freecores/gecko3/GECKO3COM/gecko3com-fw/doc/inc/leopard_gecko_by_larkin_art.jpg

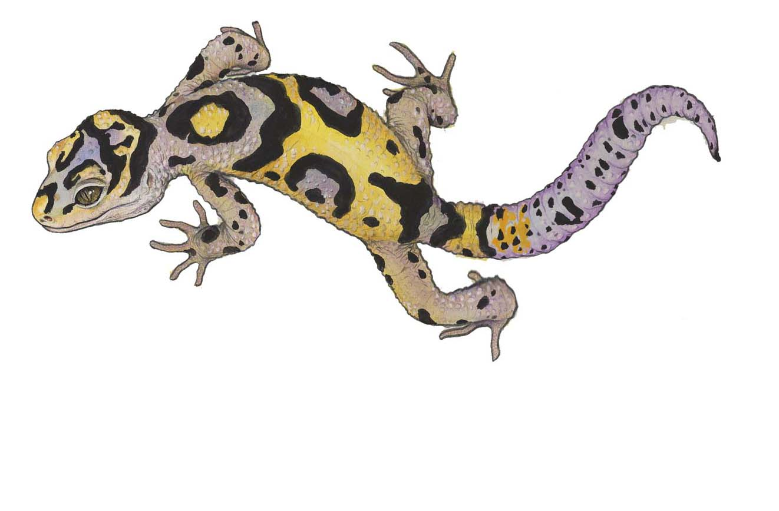
GECKO3COM/gecko3com-fw/doc/inc/leopard_gecko_by_larkin_art.jpg
