freecores/gecko3/GECKO3main/product-label/gecko3main-label.odt

# GECKO3main

Type: XC3S1500

Case: FG676

Speed: 4

Serialnumber: 1

Testdate:

# GECKO3main

Type: XC3S1500

Case: FG676

Speed: 4

Serialnumber: 2

Testdate:

# GECKO3main

Type: XC3S1500

Case: FG676

Speed: 4

Serialnumber: 3

Testdate:

# GECKO3main

Type: XC3S1500

Case: FG676

Speed: 4

Serialnumber: 4

Testdate:

# GECKO3main

Type: XC3S1500

Case: FG676

Speed: 4

Serialnumber: 5

Testdate:

# GECKO3main

Type: XC3S1500

Case: FG676

Speed: 4

Serialnumber: 6

Testdate:

# GECKO3main

Type: XC3S1500

Case: FG676

Speed: 4

Serialnumber: 7

Testdate:

# GECKO3main

Type: XC3S1500

Case: FG676

Speed: 4

Serialnumber: 8

Testdate:

# GECKO3main

Type: XC3S1500

Case: FG676

Speed: 4

Serialnumber: 9

Testdate:

# GECKO3main

Type: XC3S1500

Case: FG676

Speed: 4

Serialnumber: 10

Testdate:

# GECKO3main

Type: XC3S1500

Case: FG676

Speed: 4

Serialnumber: 11

Testdate:

# GECKO3main

Type: XC3S1500

Case: FG676

Speed: 4

Serialnumber: 12

Testdate:

# GECKO3main

Type: XC3S1500

Case: FG676

Speed: 4

Serialnumber: 13

Testdate:

# GECKO3main

Type: XC3S1500

Case: FG676

Speed: 4

Serialnumber: 14

Testdate:

# GECKO3main

Type: XC3S1500

Case: FG676

Speed: 4

Serialnumber: 15

Testdate:

# GECKO3main

Type: XC3S1500

Case: FG676

Speed: 4

Serialnumber: 16

Testdate:

# GECKO3main

Type: XC3S1500

Case: FG676

Speed: 4

Serialnumber: 17

Testdate:

# GECKO3main

Type: XC3S1500

Case: FG676

Speed: 4

Serialnumber: 18

Testdate:

# GECKO3main

Type: XC3S1500

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

Case: FG676

Speed: 4

Serialnumber: 48

Testdate:

# GECKO3main

Type: XC3S1500

Case: FG676

Speed: 4

Serialnumber: 49

Testdate:

# GECKO3main

Type: XC3S1500

Case: FG676

Speed: 4

Serialnumber: 50

Testdate:

# GECKO3main

Type: XC3S1500

Case: FG676

Speed: 4

Serialnumber: 51

Testdate:
