freecores/gecko3/GECKO3COM/gecko3com-ip/doc/fpga_fx2_interface_1.png

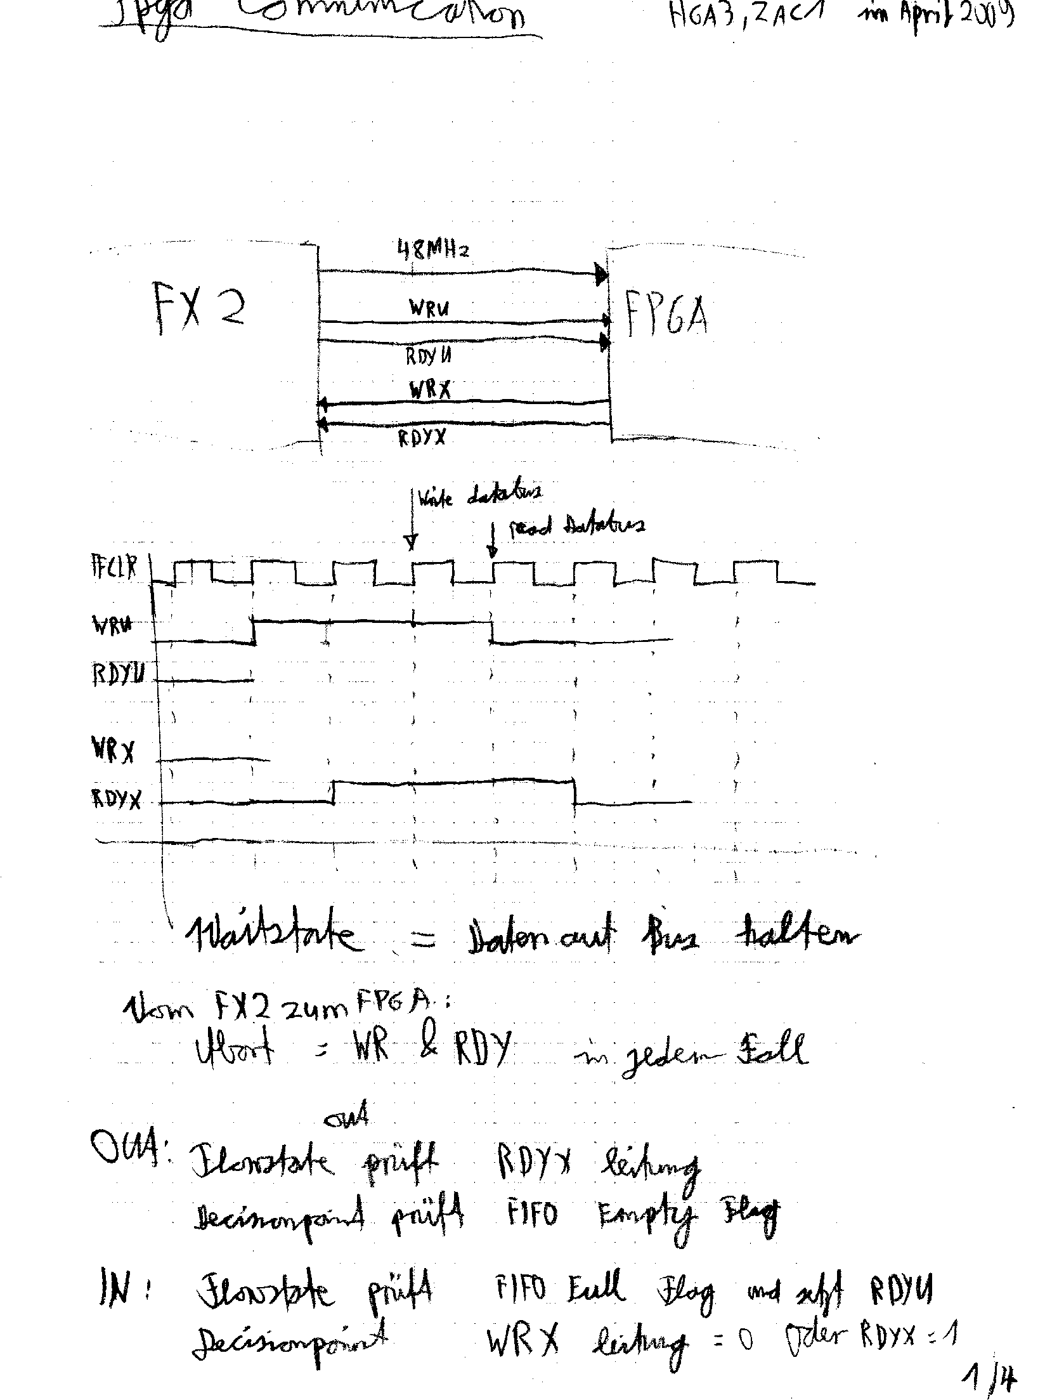
GECKO3COM/gecko3com-ip/doc/fpga_fx2_interface_1.png
