freecores/gecko3/GECKO3COM/gecko3com-ip/doc/GECKO3COM_simple_fsm_2.png

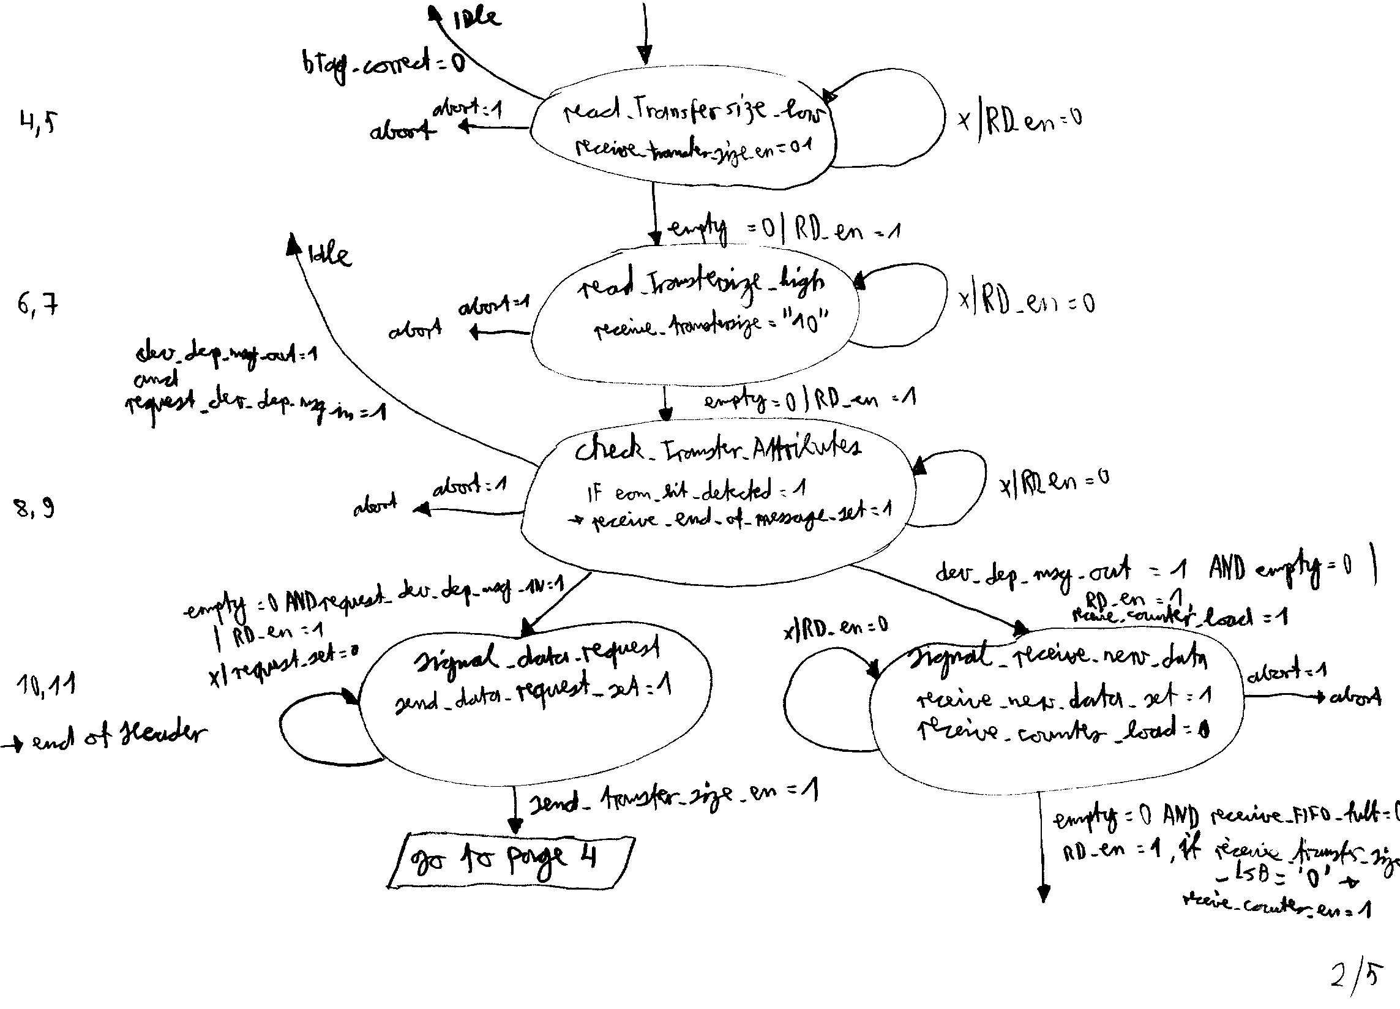
GECKO3COM/gecko3com-ip/doc/GECKO3COM_simple_fsm_2.png
