freecores/gecko3/GECKO3COM/gecko3com-ip/doc/GECKO3COM_simple_fsm_3.png

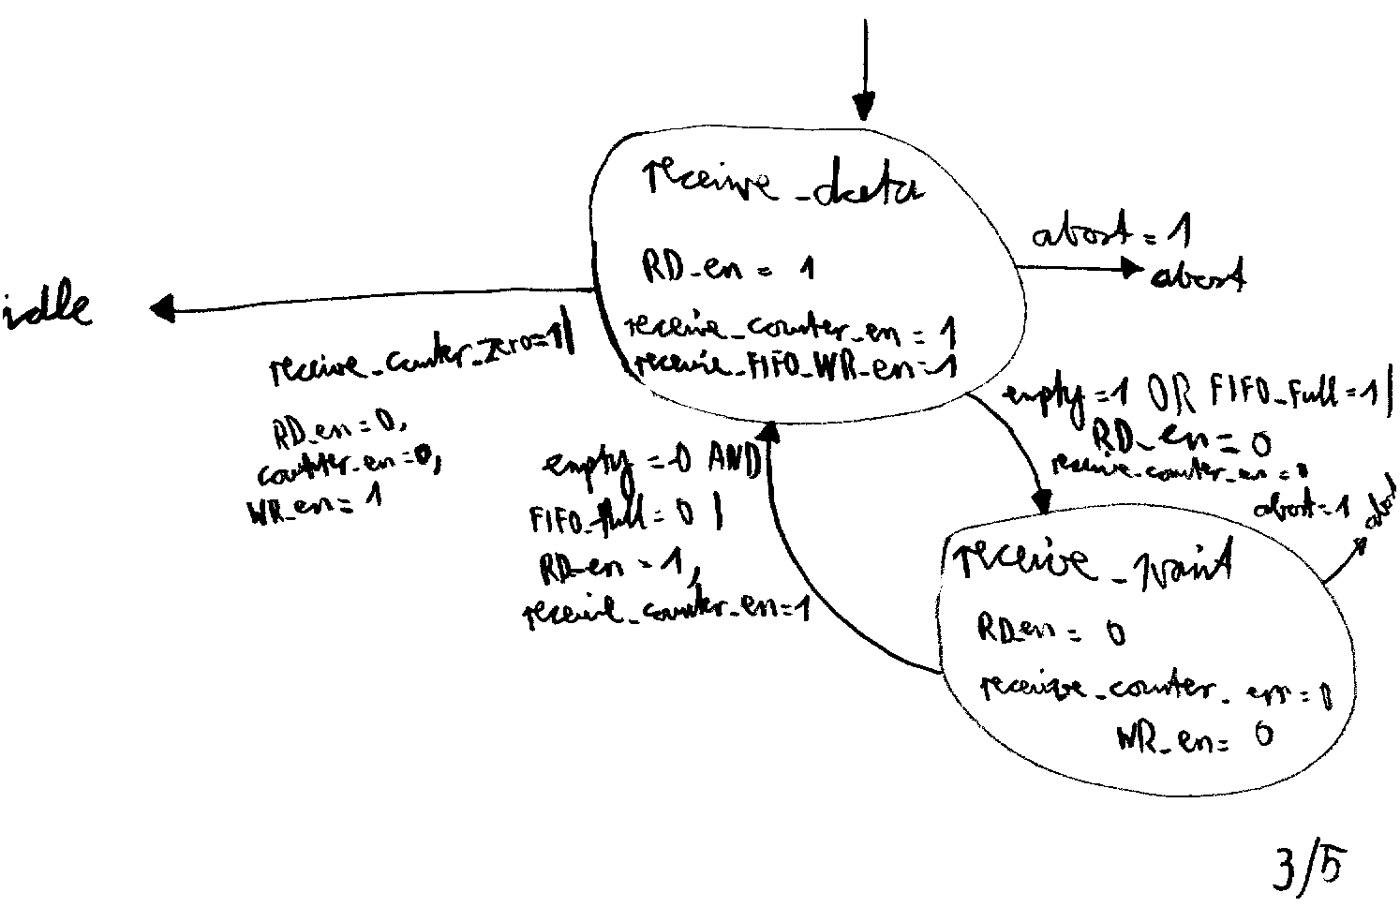
GECKO3COM/gecko3com-ip/doc/GECKO3COM_simple_fsm_3.png
