freecores/gecko3/GECKO3COM/gecko3com-ip/doc/GECKO3COM_simple_fsm_5.png

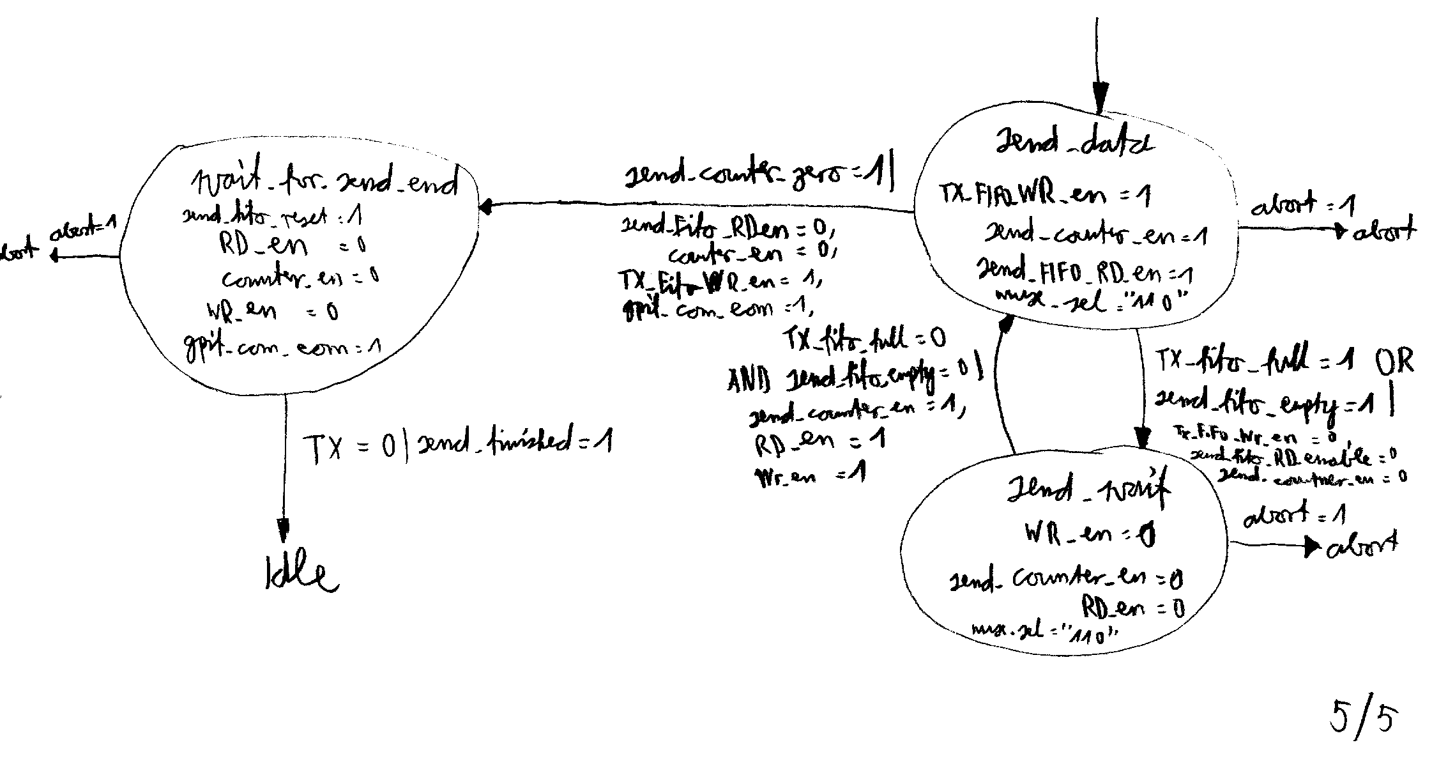
GECKO3COM/gecko3com-ip/doc/GECKO3COM_simple_fsm_5.png
