freecores/gecko3/GECKO3COM/gecko3com-ip/doc/GECKO3COM_simple_symbol.png

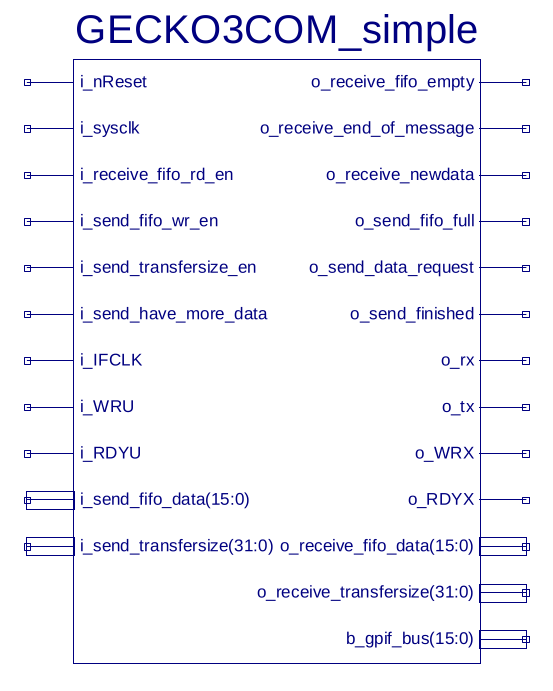
GECKO3COM/gecko3com-ip/doc/GECKO3COM_simple_symbol.png
