freecores/gecko3/GECKO3COM/gecko3com-ip/doc/gpif_com_symbol.png

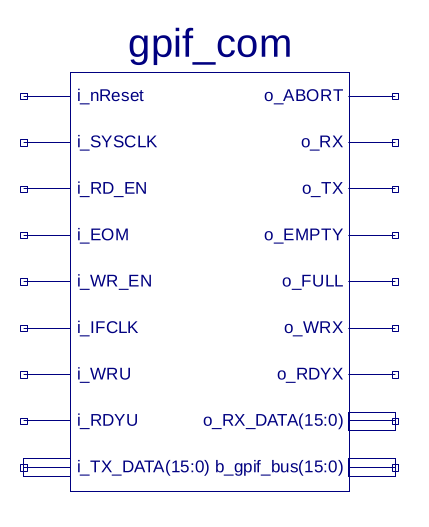
GECKO3COM/gecko3com-ip/doc/gpif_com_symbol.png
