freecores/gecko3/GECKO3COM/gecko3com-ip/doc/in_transfer_planing.png

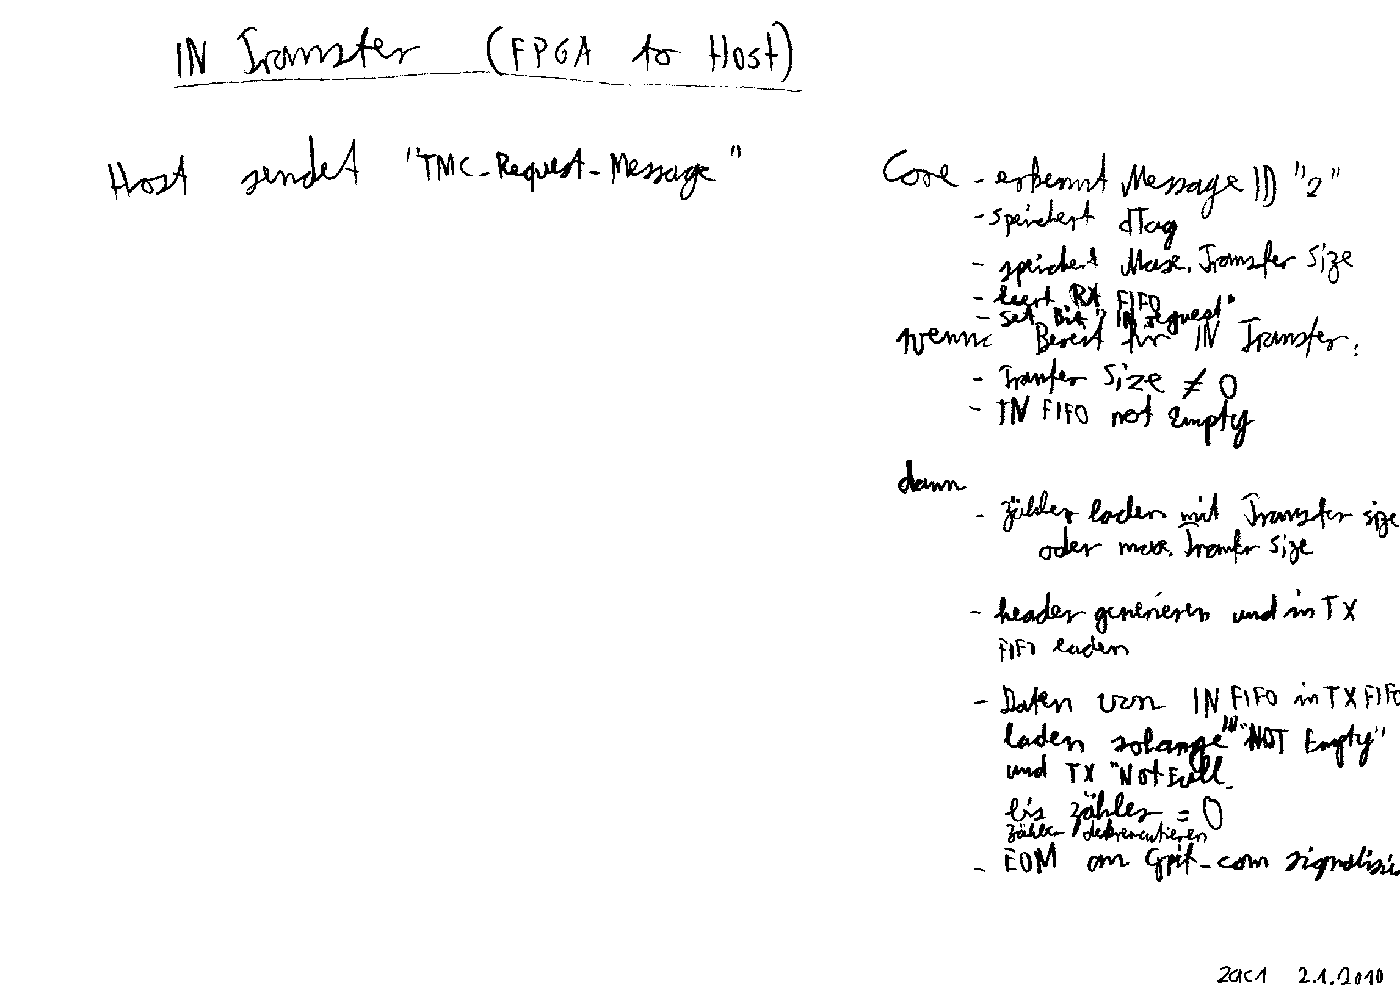
GECKO3COM/gecko3com-ip/doc/in_transfer_planing.png
