freecores/gecko3/GECKO3COM/gecko3com-ip/doc/out_transfer_planing.png

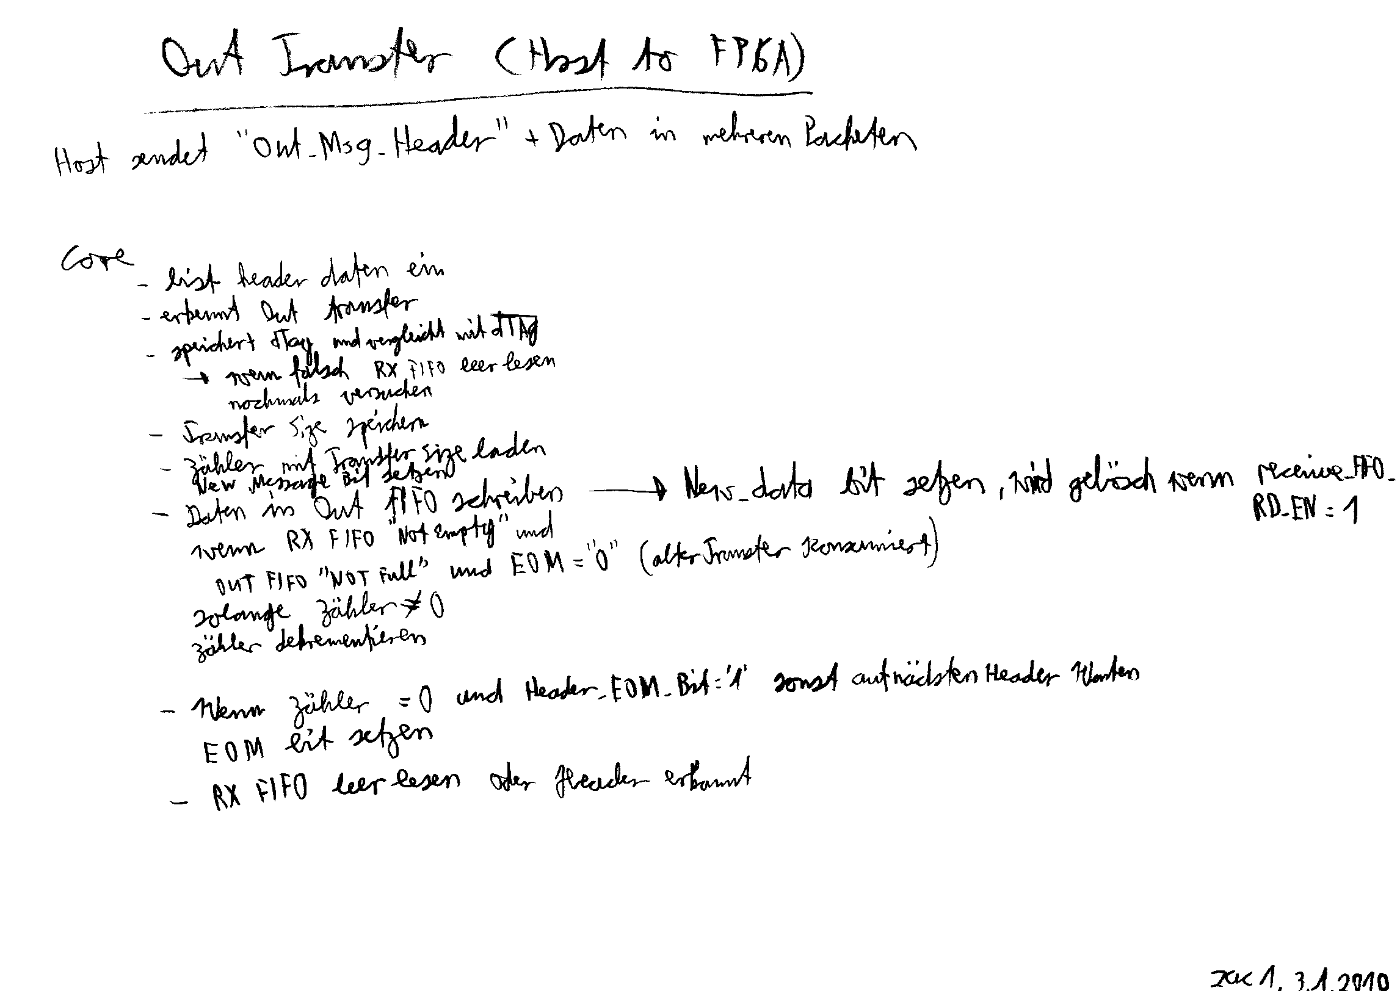
GECKO3COM/gecko3com-ip/doc/out_transfer_planing.png
