freecores/gecko3/GECKO3COM/gecko3com-ip/doc/wave_arbit_col.png

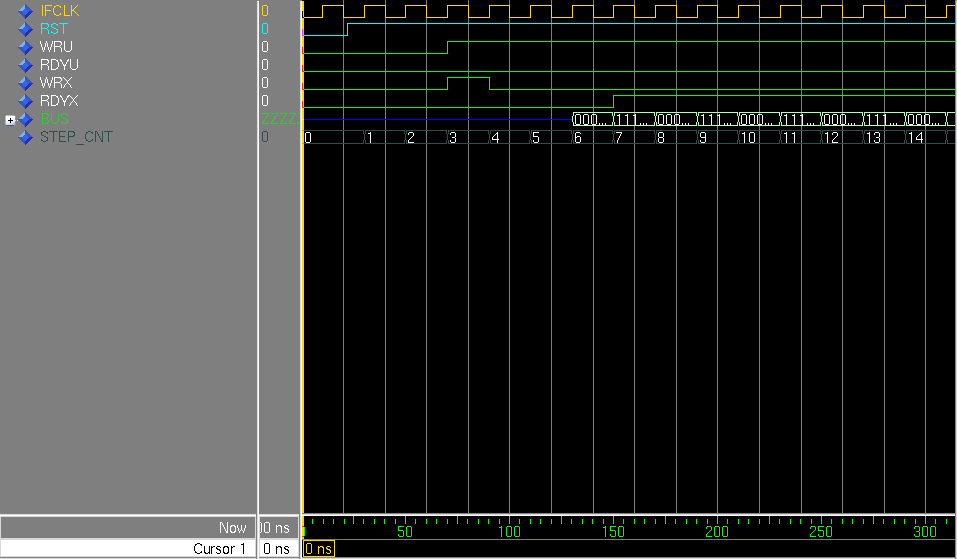
GECKO3COM/gecko3com-ip/doc/wave_arbit_col.png
