freecores/gecko3/GECKO3COM/gecko3com-ip/doc/wave_throt.png

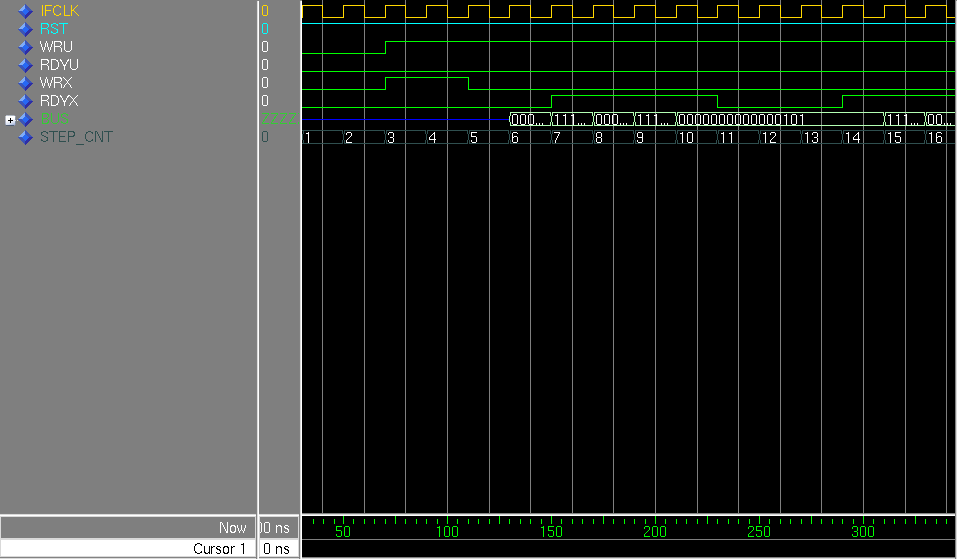
GECKO3COM/gecko3com-ip/doc/wave_throt.png
