freecores/gecko3/GECKO3main/blockdiagramm.png

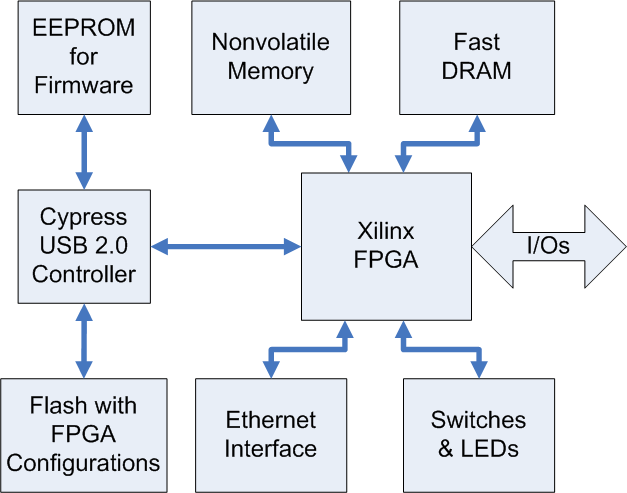
GECKO3main/blockdiagramm.png
