freecores/gecko3/CAD libraries/part-list.xls

Sheet: R
Value | Manufacturer | Part Number | Distributor | Distributor Number | Packaging unit | lead time | RoHS | Currency | Price
10R | TYCO ELECTRONICS | CRG0402J10R-10 | Farnell | 1174 141 | 50 |  | yes | CHF | 0.09
33R | TYCO ELECTRONICS | CRG0402J33R-10 | Farnell | 1174 144 | 50 |  | yes | CHF | 0.09
49.9R | Multicomp | MC 0.063W 0603 1% 49R9 | Farnell | 1170 658 | 50 |  | X-yes | CHF | 0.062
68R | PHYCOMP | 232270676809 | Farnell | 9239 090 | 50 |  | yes | CHF | 0.12
100R | PHYCOMP | 232270671001 | Farnell | 9239 111 | 50 |  | yes | CHF | 0.12
120R | PHYCOMP | 232270671201 | Farnell | 9239 120 | 50 |  | yes | CHF | 0.12
220R | PHYCOMP | 232270672201 | Farnell | 9239 154 | 50 |  | yes | CHF | 0.12
330R | PHYCOMP | 232270673301 | Farnell | 9239 170 | 50 |  | yes | CHF | 0.12
1.5K | PHYCOMP | 232270671502 | Farnell | 9239 251 | 50 |  | yes | CHF | 0.12
160K | Multicomp | MC 0.063W 0603 1% 160K | Farnell | 9330 682 | 50 |  | X-yes | CHF | 0.055
180K | PHYCOMP | 232270671804 | Farnell | 9239 502 | 50 |  | yes | CHF | 0.12
1M_250V | Multicomp | MC 0.125W 1206 1% 1M | Farnell | 9335 781 | 50 |  | X-yes | CHF | 0.055
2.2K | PHYCOMP | 232270672202 | Farnell | 9239 278 | 50 |  | yes | CHF | 0.12
2.2M | PHYCOMP | 232270672205 | Farnell | 9239 618 | 50 |  | yes | CHF | 0.12
330k | PHYCOMP | 232270673304 | Farnell | 9239 537 | 50 |  | yes | CHF | 0.12
4.7K | PHYCOMP | 232270674702 | Farnell | 9239 316 | 50 |  | yes | CHF | 0.12
4.87K | Multicomp | MC 0.063W 0603 1% 4K87 | Farnell | 1170 858 | 50 |  | X-yes | CHF | 0.09
4x27 | PHYCOMP | 235003410279 | Farnell | 9234 969 | 10 |  | yes | CHF | 0.17
6.2K | Multicomp | MC 0.063W 0603 1% 6K2 | Farnell | 9331 409 | 50 |  | X-yes | CHF | 0.055
82K | PHYCOMP | 232270678203 | Farnell | 9239 464 | 50 |  | yes | CHF | 0.12
27R | PHYCOMP | 232270672709 | Farnell | 9239 049 | 50 |  | yes | CHF | 0.12
1.2K | PHYCOMP | 232270671202 | Farnell | 9239 243 | 50 |  | yes | CHF | 0.12
1.8k 0603 | Multicomp | MC 0.063W 0603 1% 1K8 | Farnell | 9330 712 | 50 |  | X-yes | CHF | 0.062
330k 0603 | Multicomp | MC 0.063W 0603 1% 330K | Farnell | 9331 042 | 50 |  | X-yes | CHF | 0.062
1M 0603 | Multicomp | MC 0.063W 0603 1% 1M | Farnell | 9330 410 | 50 |  | X-yes | CHF | 0.062
1k 0603 | Multicomp | MC 0.063W 0603 1% 1K | Farnell | 9330 380 | 50 |  | X-yes | CHF | 0.062
1M 0603 | Multicomp | MC 0.063W 0603 1% 1K24 | Farnell | 1170 797 | 50 |  | X-yes | CHF | 0.034
10R 0603 | Multicomp | MC 0.063W 0603 1% 10R | Farnell | 9330 429 | 50 |  | X-yes | CHF | 0.062
150R 0603 | Multicomp | MC 0.063W 0603 1% 150R | Farnell | 9330 593 | 50 |  | X-yes | CHF | 0.062
2k 0603 | Multicomp | MC 0.063W 0603 1% 2K | Farnell | 9330 763 | 50 |  | X-yes | CHF | 0.062
7.5k 0603 | Multicomp | MC 0.063W 0603 1% 7K5 | Farnell | 9331 514 | 50 |  | X-yes | CHF | 0.062
10k 0603 | Multicomp | MC 0.063W 0603 1% 10K | Farnell | 9330 399 | 50 |  | X-yes | CHF | 0.062
100k 0603 | Multicomp | MC 0.063W 0603 1% 100K | Farnell | 9330 402 | 50 |  | X-yes | CHF | 0.062
137k 0603 | Multicomp | MC 0.063W 0603 1% 137K | Farnell | 1170 999 | 50 |  | X-yes | CHF | 0.034
150k 0603 | Multicomp | MC 0.063W 0603 1% 150K | Farnell | 9330 623 | 50 |  | X-yes | CHF | 0.034
470k 0603 | Multicomp | MC 0.063W 0603 1% 470K | Farnell | 9331 263 | 50 |  | X-yes | CHF | 0.034
2.2M 0603 | PHYCOMP | 232270462205 | Farnell | 9238 883 | 50 |  | yes | CHF | 0.122
3.3M 0603 | PHYCOMP | 232270463305 | Farnell | 9238 905 | 50 |  | yes | CHF | 0.122
680k 0603 | Multicomp | MC 0.063W 0603 1% 680K | Farnell | 9331 476 | 50 |  | X-yes | CHF | 0.062
120k 0603 | Multicomp | MC 0.063W 0603 1% 120K | Farnell | 9330 526 | 50 |  | X-yes | CHF | 0.062
220R 0603 | PHYCOMP | 232270462204 | Farnell | 9238 760 | 50 |  | yes | CHF | 0.123

Sheet: C
Value | Manufacturer | Part Number | Distributor | Distributor Number | Packaging unit | lead time | RoHS | Currency | Price
470nF | PHYCOMP | 2238 786 19758 | Farnell | 3188 851 | 10 |  | yes | CHF | 0.17
100nF | Murata | GRM155R71C104KA88D | Farnell | 8819 742 | 10 |  | yes | CHF | 0.07
10nF | AVX | 04023C103KAT2A | Farnell | 1327 624 | 10 |  | yes | CHF | 0.11
10uF | Murata | GRM31CR70J106KA01L | Farnell | 9527 729 | 1 |  | yes | CHF | 0.25
22pF | Murata | GRM1555C1H220JZ01D | Farnell | 8819 629 | 10 |  | yes | CHF | 0.07
15pF | AVX | 04025A150JAT2A | Farnell | 1327 631 | 1 |  | yes | CHF | 0.07
1nF | PHYCOMP | 2238 587 15623 | Farnell | 3019 380 | 10 |  | yes | CHF | 0.11
2.2uF | Murata | GRM21BR71A225KA01L | Distrelec | 823 517 | 1 |  | yes | CHF | 0.54
220uF | AVX | TAJY227K010R | Farnell | 1135 081 | 1 |  | yes | CHF | 2.5
22uF | Yuden | EMK325BJ226MM-T | Farnell | 6578 950 | 1 | 14 Tage | yes | CHF | 0.67
22uF_ | Murata | GRM32CF51A226ZA01L | Farnell | 9527 770 | 10 |  | yes | CHF | 0.43
33pF | Murata | GRM1555C1H330JZ01D | Farnell | 8819 645 | 10 |  | yes | CHF | 0.066
39pF | PHYCOMP | 2238 867 15399 | Farnell | 722 030 | 1 |  | yes | CHF | 0.11
4.7nF_1000V | Murata | DEBF33A472ZC1B | Farnell | 9527 249 | 1 |  | yes | CHF | 0.52
470uF | Kemet | B45196-H2477-K509 | Distrelec | 811 024 | 1 |  | yes | CHF | 3.77
100uF | AVX | TCJB107M004R0070 | Farnell | 1135 228 | 1 |  | yes | CHF | 0.98
3.3nF | PHYCOMP | 2238 587 15629 | Farnell | 3019 410 | 10 |  | yes | CHF | 0.11
47pF | Murata | GRM1555C1H470JZ01D | Farnell | 8819 670 | 10 |  | yes | CHF | 0.07
680nF | PHYCOMP | 2238 240 15661 | Farnell | 3352 055 | 10 |  | yes | CHF | 0.34
47nF | PHYCOMP | 2238 787 19845 | Farnell | 3019 469 | 10 |  | yes | CHF | 0.15
4.7nF_1KV_SMD | AVX | 1206AC472KAT1A | Farnell | 1216 464 | 5 |  | yes | CHF | 0.38
22uF 0805 | Kemet | C0805C226M9PAC7800 | Farnell | 1108 326 | 1 |  | yes | CHF | 1.8
100uF ceramic | Kemet | C1210C107M9PAC7800 | Farnell | 1108 328 | 1 |  | yes | CHF | 4.13
4.7uF | Kemet | C0805C475K4PAC | Farnell | 9227 849 | 10 |  | yes | CHF | 0.508
4.7pF 0603 | AVX | 06032U4R7CAT2A | Farnell | 7568 258 | 5 |  | yes | CHF | 0.45
10nF 0603 | AVX | 06035C103KAT2A | Farnell | 1327 675 | 10 |  | yes | CHF | 0.07
22pF 0603 | Epcos | B37930K5220J60 | Farnell | 9753 486 | 10 |  | yes | CHF | 0.083
47pF 0603 | Murata | GRM1885C1H470JA01D | Farnell | 8819 840 | 10 |  | yes | CHF | 0.071
820pF 0603 | PHYCOMP | 2238 861 15821 | Farnell | 718 555 | 10 |  | yes | CHF | 0.115
1nF 0603 | Murata | GRM188R71H102KA01D | Farnell | 8819 955 | 10 |  | yes | CHF | 0.071

Sheet: IC
Value | Manufacturer | Part Number | Distributor | Distributor Number | Packaging unit | lead time | RoHS | Currency | Price
CY7C68013A-56BAXC | Cypress | CY7C68013A-56BAXC | Silica | CY7C68013A56BAXC | 490 | 12 Weeks | yes | CHF | 15.95
DP83848I | National | DP83848IVV/NOPB | EBV | DP83848IVV/NOPB | 1 |  | yes | CHF | 5.55
JS28F128J3D-75 | Intel | JS28F128J3D-75 | Silica | JS28F128J3D-75 | 96 | 13 Weeks | yes | $ | 10.2
LP8340CDT-2.5 | National | LP8340CDT-2.5 | EBV | LP8340CDT-2.5/NOPB | 75 | 6 Weeks | yes | CHF | 1.065
LTC3412A | Linear | LTC3412AEUF#PBF | Linear online | LTC3412AEUF#PBF | 1 | 2 Weeks | yes | $ | 4.93
LTC4411 | Linear | LTC4411ES5#PBF | Linear online | LTC4411ES5#PBF | 1 | 2 Weeks | yes | $ | 2.36
M25P16-SO8 | ST | M25P16-VMW6TG | Silica | M25P16VMW6TG | 1 | 8 Weeks | yes | CHF | 3.31
XC3S1500-4FG676C | Xilinx | XC3S1500-4FGG676C | Silica | XC3S15004FGG676C | 40 | 6 Weeks | yes | CHF | 130.74
XC3S1500-4FG456C | Xilinx | XC3S1500-4FG456C | Silica | XC3S1500FG456C | 66 | 6 Weeks | no | CHF | 85.93
MAX3232 | Maxim | MAX 3232 CPE | Distrelec | 648 972 | 1 |  | yes | CHF | 7.75
MT46V32M16P5B | Micron | MT46V32M16P5B | Silica | MT46V32M16P5B | 108 | 12 Weeks | yes | CHF | 15.87
MAX3232CSE | Maxim | MAX 3232 CSE | Distrelec | 648 973 | 1 |  | yes | CHF | 7.75
PCA9536DP | TI | PCA9536DGKR | Farnell | 1310 217 | 1 | 2 Weeks | yes | CHF | 2.45
24LC128-I/SN | Microchip | 24LC128-I/SN | Silica | 24LC128ISN | 100 | 6 Weeks | yes | CHF | 0.96
M25P16-SO16 | ST | M25P16-VMF6P | Farnell | 8661 316 | 1 |  | yes | CHF | 6.30
CY7C68013A-56LFXC | Cypress | CY7C68013A-56LFXC | Silica | CY7C68013A56LFXC | 260 | 5 Weeks | yes | CHF | 12.39
M25P32-VDFPN | ST | M25P32-VME6G | Silica | M25P32VME6G | 320 | 12 Weeks | yes | CHF | 6.92
XC3S4000-5FG676C | Xilinx | XC3S4000-5FG676C | Silica | XC3S40005FGG676C | 40 | 6 Weeks | yes | CHF | 184.72
Si9986 | Vishay | SI9986DY-T1-E3 | Farnell | 1199 224 | 1 | 2 Weeks | yes | CHF | 6.60
LTC4075 | Linear | LTC4075EDD#PBF | Linear online | LTC4075EDD#PBF | 1 | 2 Weeks | yes | $ | 2.67
LTC3412AEFE | Linear | LTC3412AEFE#PBF | Linear online | LTC3412AEFE#PBF | 2 | 2 Weeks | yes | $ | 4.93
LTC4412 | Linear | LTC4412ES6#PBF | Linear online | LTC4412ES6#PBF | 2 | 2 Weeks | yes | $ | 1.93
LMV321IDBVR | TI | LMV321IDBVR | Farnell | 1105 935 | 1 |  | yes | CHF | 0.863
LM2703 | National | LM2703MF-ADJ | Farnell | 9779 442 | 1 |  | yes | CHF | 4.00
74HC74D | TI | SN74HC74D | Farnell | 9591 680 | 1 |  | yes | CHF | 0.632

Sheet: L
Value | Manufacturer | Part Number | Distributor | Distributor Number | Packaging unit | lead time | RoHS | Currency | Price
22nH | Panasonic | ELJRE22NJFA | Farnell | 1198 381 | 5 |  | yes | CHF | 0.45
2uH | Cooper Bussmann | SD14-2R0-R | Hy-Line |  | 3800 | 10 Days | yes | CHF | 1.85
2.2uH | Cooper Bussmann | SD18-2R2-R | Farnell | 9458 719 | 1 | 2 Weeks | yes | CHF | 2.40
MLB-160808-0300A-N2 | Kitagawa | MLB-160808-0300A-N2 | Distrelec | 330 117 | 5 |  | yes | CHF | 0.54
MLB-160808-S600Q | Kitagawa | MLB-160808-S600Q | Distrelec | 330 131 | 5 |  | yes | CHF | 0.75
2.2uH 1210 | Murata | LQH32CN2R2M33L | Farnell | 9522 182 | 5 |  | yes | CHF | 0.357
2.2uH DR73 | Cooper Bussmann | DR73-2R2 | Farnell | 1463 507 | 1 |  | yes | CHF | 2.00

Sheet: Con
Value | Manufacturer | Part Number | Distributor | Distributor Number | Packaging unit | lead time | RoHS | Currency | Price
fh-120p-5mm | AMP | 5177984-5 | Farnell | 1098 339 | 1 |  | yes | CHF | 7.95
fh-120r-9mm | AMP | 5-5179009-5 | Farnell | 1098 355 | 1 |  | yes | CHF | 6.85
fh-120r-5mm | AMP | 5177983-5 | Farnell | 1098 349 | 1 |  | yes | CHF | 7.76
fh-60p-5mm | AMP | 5177984-2 | Farnell | 1098 336 | 1 |  | yes | CHF | 3.7
fh-60r-9mm | AMP | 5-5179009-2 | Farnell | 1098 352 | 1 |  | yes | CHF | 3.7
fh-60r-13mm | AMP | 5-5179010-2 | Farnell | 1098 357 | 1 |  | yes | CHF | 3.85
Header 1x6, right angle | Preci-Dip | 330.36.1 L 02 902 | Distrelec | 122 112 | 6 |  | yes | CHF | 2.26
Header 1x6, straight | Fischer | SL1/53/36 Z | Distrelec | 122 201 | 6 |  | yes | CHF | 2.69
M22-2040205 | HARWIN | M22-2040205 | Farnell | 672 208 | 1 |  | yes | CHF | 1.2
M22-2540305 | HARWIN | M22F2040305 | Farnell | 672 210 | 1 |  | yes | CHF | 2.3
miniUSB-tht | Molex | 54819-0519 | Mouser | 538-54819-0519 | 1 | 2 Weeks | yes | $ | 1.2
S1751-46R | HARWIN | S1751-46R | Farnell | 1022 338 | 100 |  | yes | CHF | 0.1895
SI-10021 | Stewart | SI-10021 | Farnell | 1137 981 | 1 |  | yes | CHF | 12.65
DB9M | Harting | 0965 162 6812 | Farnell | 1097 063 | 1 |  | yes | CHF | 3.1
miniUSB-smt | Lumberg | 2486 01 | Farnell | 1243 250 | 1 |  | yes | CHF | 2.55
Header 2x3,smt | AMP | 1241050-3 | Farnell | 9689 567 | 1 |  | yes | CHF | 1.5
DC8 | CLIFF ELECTRONIC | DC8 | Farnell | 224 947 | 10 |  | yes | CHF | 1.855
M20-7890546 | HARWIN | M20-7890546 | Farnell | 7992 076 | 10 |  | yes | CHF | 1.45
Socket 2x20,smt | Sullins | NPPC202KFMS-RC | DIGIKEY | S5729-ND | 1 | 2 Weeks | yes | $ | 5.94
DB9F | MULTICOMP | 5504F1-09S-01-03-F1 | Farnell | 1084 710 | 10 |  | yes | CHF | 1.55
Header 1x2, straight | Preci-Dip | 330.36.1 L 02 902 | Distrelec | 122 112 | 18 |  | yes | CHF | 2.26

Sheet: T
Value | Manufacturer | Part Number | Distributor | Distributor Number | Packaging unit | lead time | RoHS | Currency | Price
BSS670 | Infineon | BSS670S2L | Farnell | 1095 673 | 5 |  | yes | CHF | 0.35
IRF5800 | IRF | IRF5800TRPBF | Farnell | 1298 519 | 1 |  | yes | CHF | 1.5
IRF7705 | IRF | IRF7705TRPBF | Farnell | 1298 533 | 1 |  | yes | CHF | 3.65

Sheet: D
Value | Manufacturer | Part Number | Distributor | Distributor Number | Packaging unit | lead time | RoHS | Currency | Price
10BQ030 | Vishay | 10BQ030PBF | Farnell | 9100 687 | 1 |  | yes | CHF | 0.42
MBR0520 | ON Semi | MBR0520LT1G | Farnell | 9556 915 | 1 |  | yes | CHF | 0.561
BAT54C | ST | BAT54CFILM | Farnell | 1261 334 | 1 | 2 Weeks | yes | CHF | 0.13
BRBG1211C | Stanley | BRBG1211C | Distrelec | 253 183 | 1 |  | yes | CHF | 0.86
side led green | Avago | HSMQ-C110 | Farnell | 8554 692 | 5 |  | yes | CHF | 1.8
side led red | Avago | HSMC-C110 | Farnell | 8554 498 | 5 |  | yes | CHF | 0.288
side led yellow | Avago | HSMA-C110 | Farnell | 8554 455 | 5 |  | yes | CHF | 0.577
MBRS340TR | Vishay | MBRS340TRPBF | Farnell | 1463 234 | 1 |  | yes | CHF | 0.617
LED 5mm green | Avago | HLMP-3507 | Distrelec | 251 536 | 5 |  | yes | CHF | 0.43
LED 5mm red | Avago | HLMP3301 | Distrelec | 251 534 | 5 |  | yes | CHF | 0.54
SB340 | Diotec | SB340 | Distrelec | 601 797 | 1 |  | yes | CHF | 0.86

Sheet: other
Value | Manufacturer | Part Number | Distributor | Distributor Number | Packaging unit | lead time | RoHS | Currency | Price
50MHz-osc | Jauch | VX3MH-5000 | Distrelec | 644 127 | 1 |  | yes | CHF | 6.99
?MHz-osc | Jauch | VX3MH-* | Distrelec | 644 1XX | 1 |  | yes | CHF | 6.99
24MHz | auris | Q-24.000M-HC49USSMD-F-30-50-D-30 | Distrelec | 335 040 | 1 |  | yes | CHF | 1.29
25MHz | ABRACON | ABLS-25.000MHZ-B2F-T | Farnell | 7940 579 | 1 | 2 Weeks | yes | CHF | 0.53
MMS 238 T | KNITTER | MMS 238 T | Farnell | 8546 827 | 1 |  | yes | CHF | 3.35
FSM | TYCO | 0-1437565-1 | Distrelec | 200 858 | 1 |  | yes | CHF | 0.86
SMD-DIP2 | TYCO | GDH02S | Farnell | 1123 952 | 1 |  | yes | CHF | 7.10
SW-DIP4 | Diptronics | PM-040900 | Distrelec | 210 036 | 1 |  | yes | CHF | 3.34
PA-LP987 | Contrel | PA-LP987 | Contrel | PA-LP987 | 1 | 5 Weeks | yes | CHF
TCND5000 | Vishay | TCND5000 | Farnell | 9169 997 | 1 | 2 Weeks | yes | CHF | 3.30
74HC74D | TI | SN74HC74D | Farnell | 9591 680 | 1 |  | yes | CHF | 0.632
TEN5-0510 | TRACO | TEN5-0510 | Distrelec | 362 901 | 1 |  | yes | CHF | 47.34
?MHz-osc dil14 | Rakon | LF X3xxB | Farnell | 9712 xxx | 1 |  | yes | CHF | 8.35
