freecores/gecko3/GECKO3 tester/gecko3main-tester.pdf

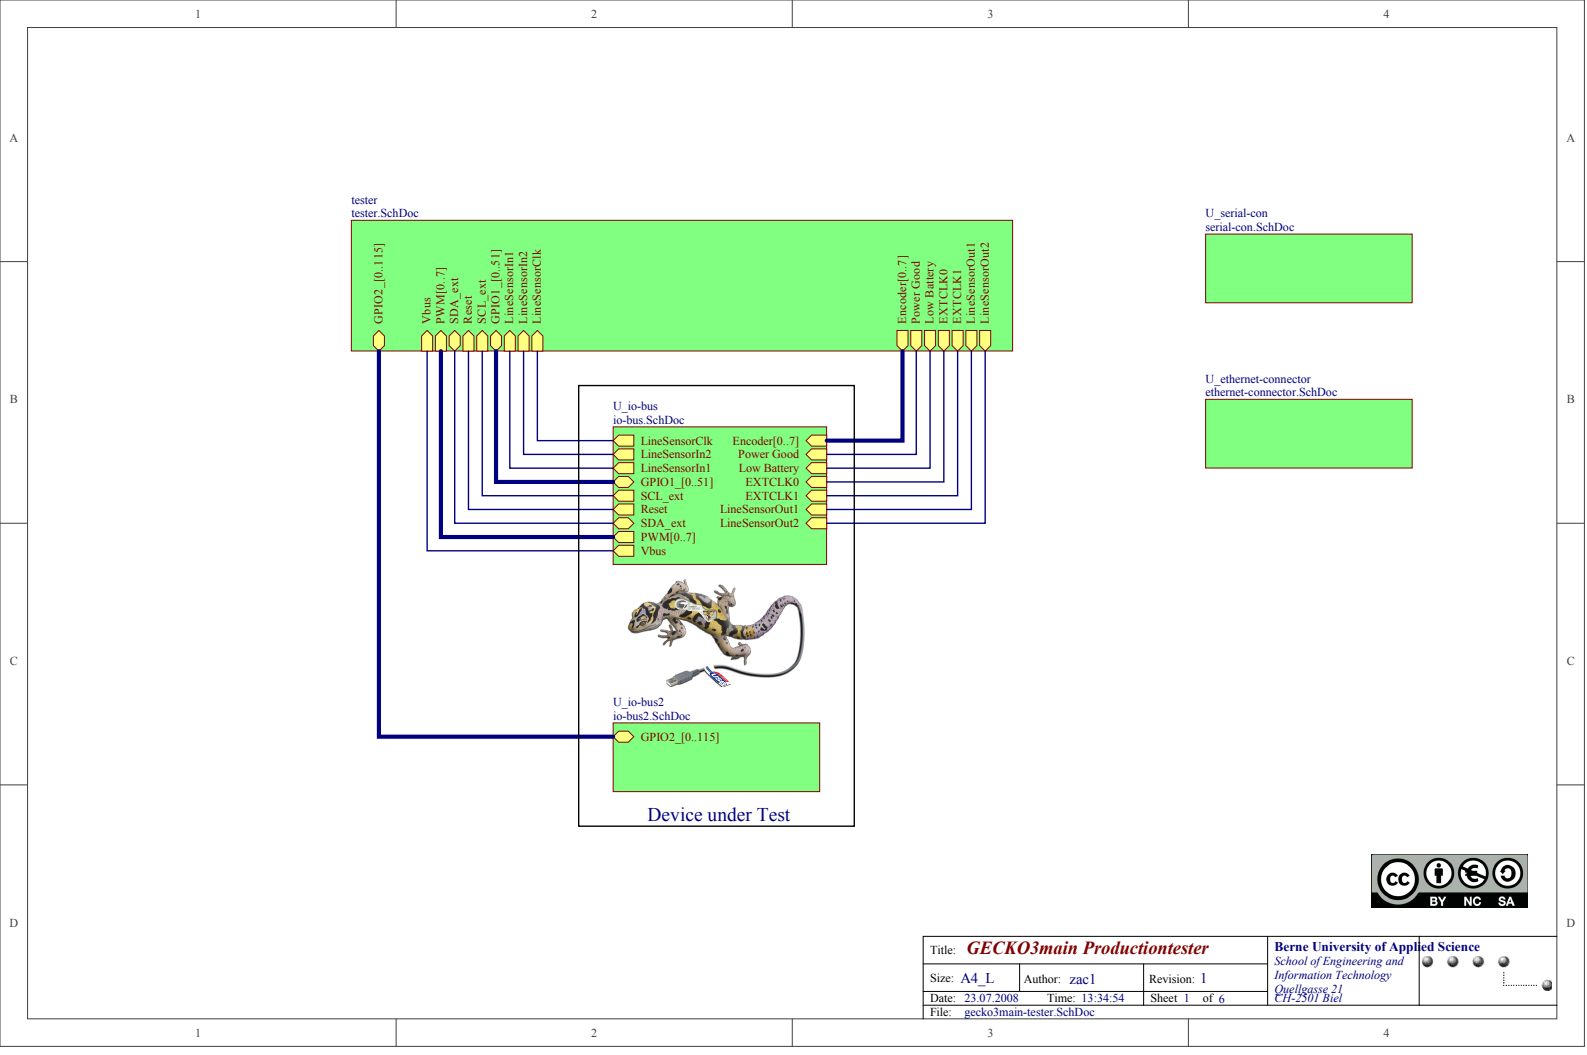
[picture p24: page 1]
Power Good Low Battery

U_serial-con
serial-con.SchDoc

U_ethernet-connector
ethernet-connector.SchDoc

Device under Test

GECKO3main Productiontester Title: | Berne University of Applied Science School of Engineering and Information Technology CH-2501 Biel

Size: A4_L | Author: zac1 | Revision: 1 | Quellgasse 21 6

Date: 23.07.2008 Time: 13:34:54 | | Sheet 1 of

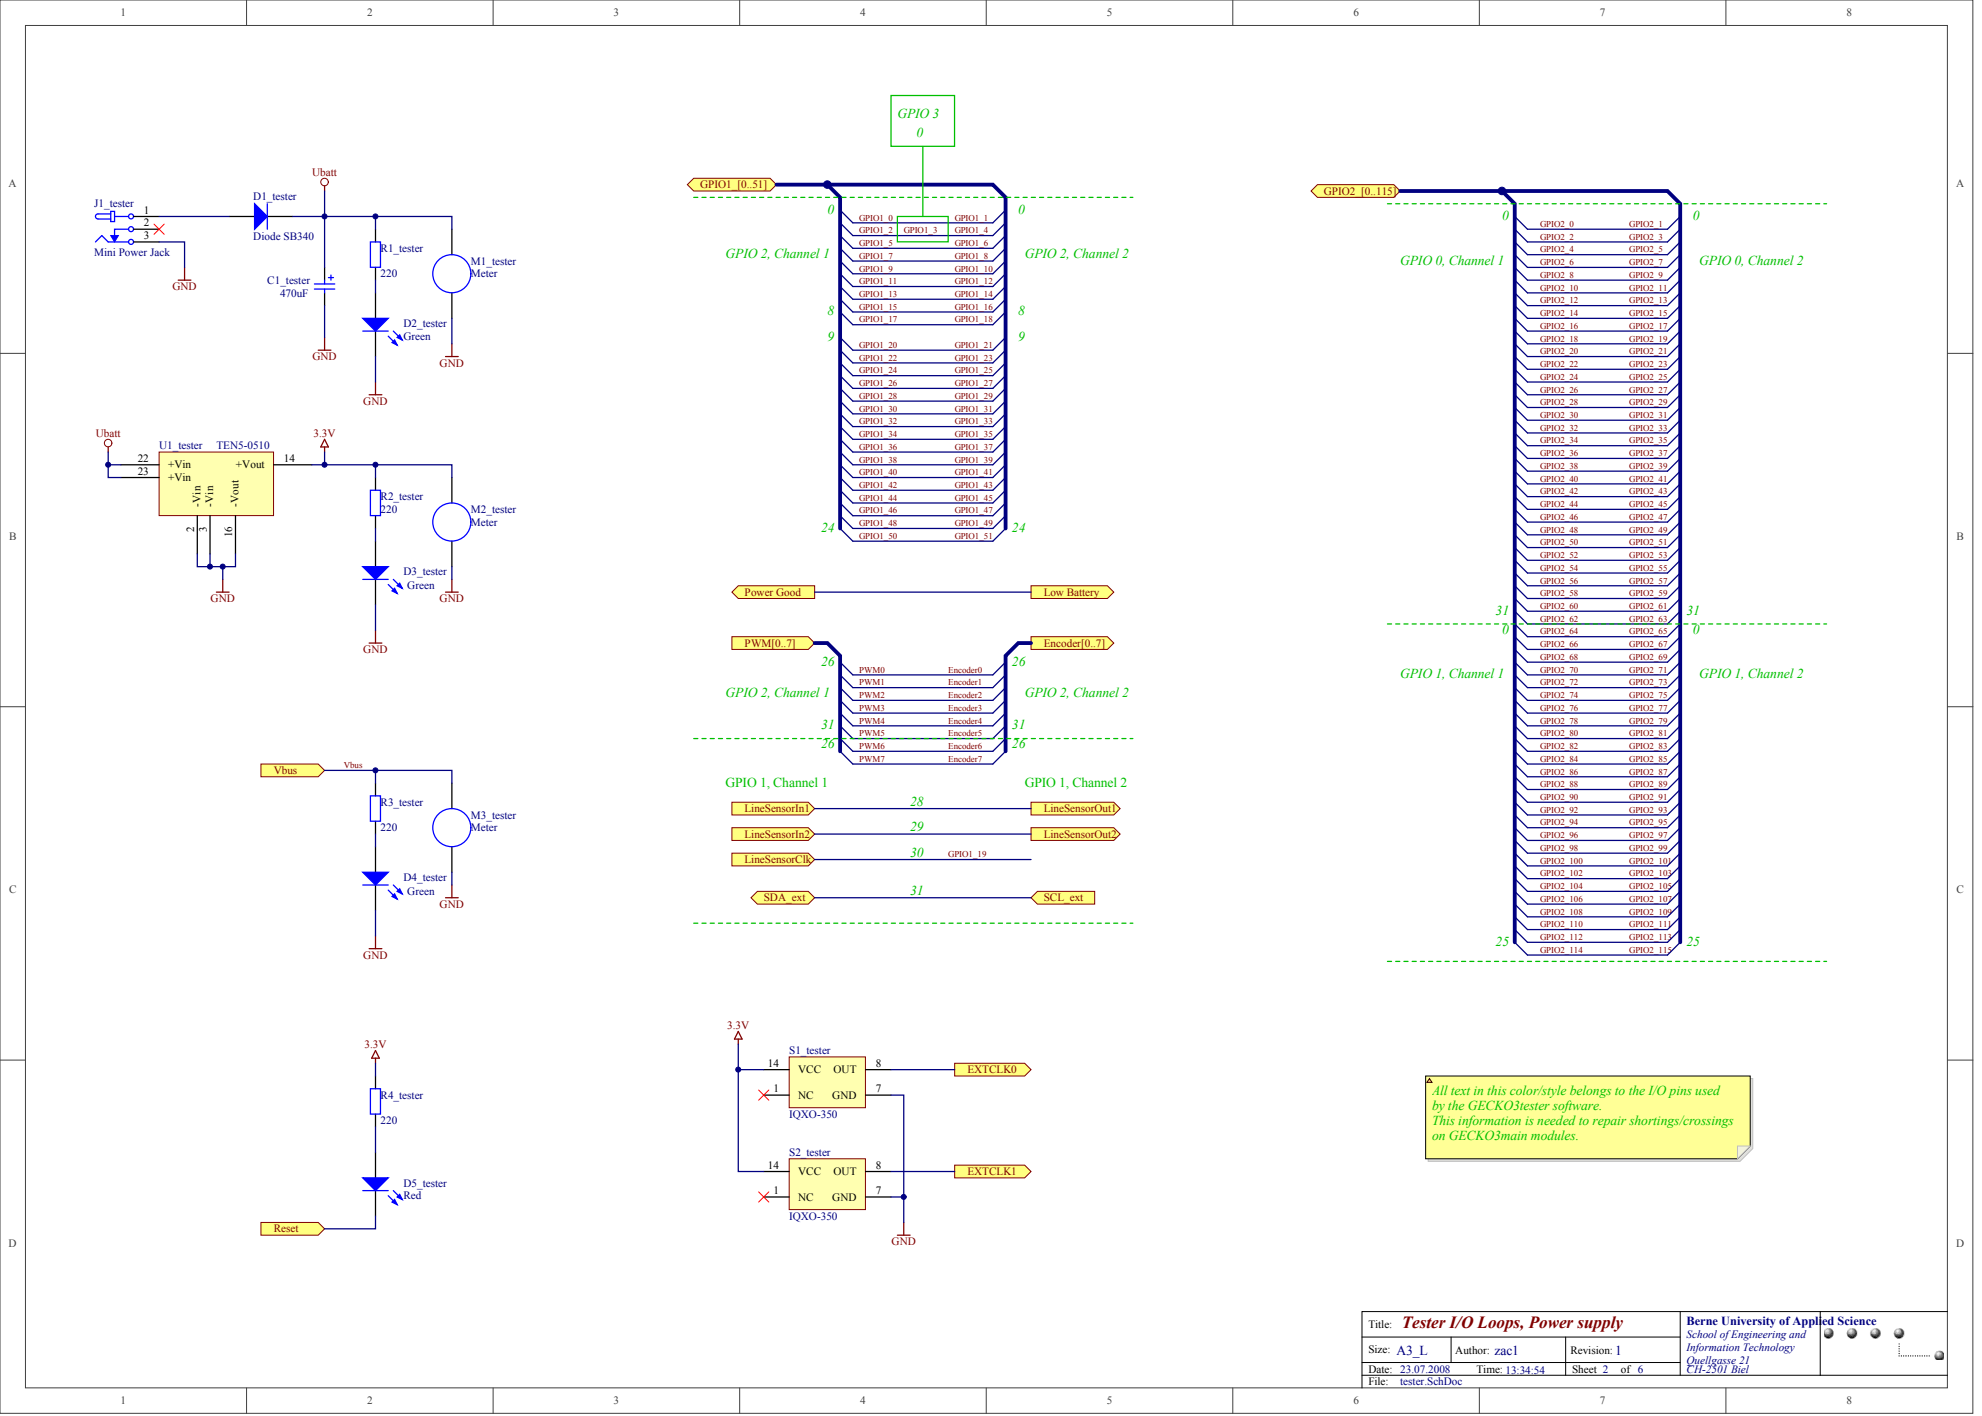
[picture p25: page 2]
PWM[0..7]; Encoder[0..7] Power Good; Low Battery; IO1_[0..51] LineSensorIn1 LineSensorIn2; LineSensorOut1 LineSensorOut2; 321 J1_tester; Diode SB340; -Vin 2; +Vin 22; +Vout; +Vin 23; -Vin 3; -Vout 16; VCC 14; Encoder7 GPIO1_19; GPIO 0, Channel 1; GPIO 0, Channel 2; GPIO 1, Channel 10; GPIO 1, Channel 2; GPIO 2, Channel 1098; GPIO 2, Channel 2; GPIO 2, Channel 1; PIO 1, Channel 1; PIO 1, Channel 2; GPIO 3 0; CKO3tester software.; CKO3main modules.; P0C10tester01 P0C10tester02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

Mini Power Jack

All text in this color/style belongs to the I/O pins used
by the GE
This information is needed to repair shortings/crossings

Tester I/O Loops, Power supply Title: | Berne University of Applied Science School of Engineering and Information Technology Quellgasse 21 CH-2501 Biel

Size: A3_L | Author: zac1 | Revision: 1

Date: File: 23.07.2008 Time: 13:34:54 | | Sheet 2 of 6

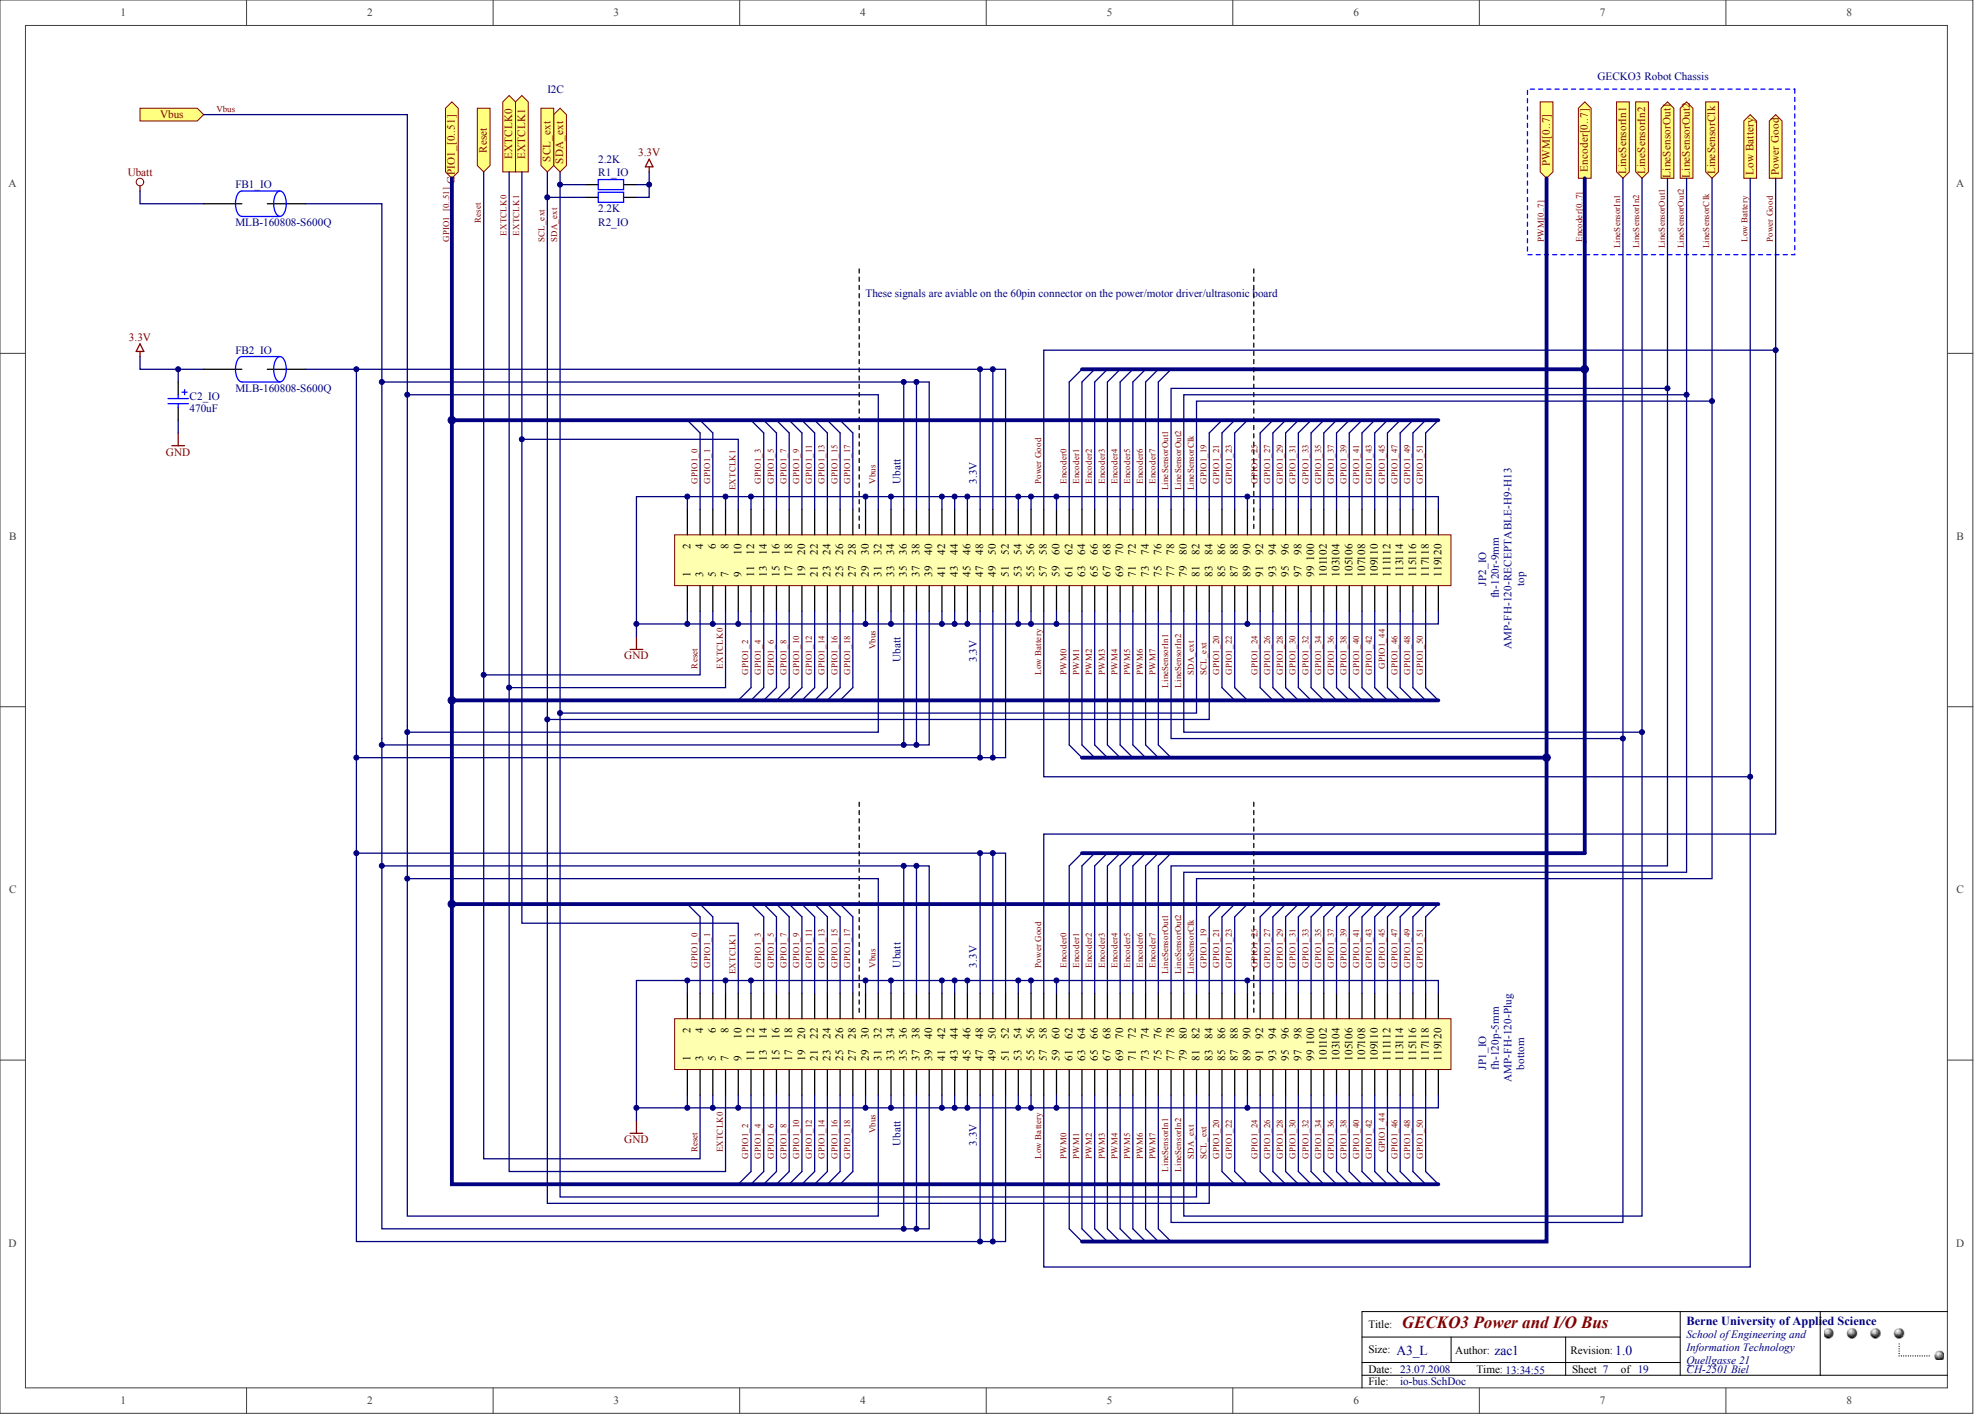
[picture p26: page 3]
GECKO3 Robot Chassis; MLB-160808-S600Q FB2_IO; MLB-160808-S600Q FB1_IO; Power Good; Low Battery; Vbus Vbus; ext I2C; _[0..51] GPIO1_[0..51]; LineSensorClk LineSensorClk; 3 GPIO1; 5 GPIO1; 7 GPIO1; 9 GPIO1; 11 GPIO1; 13 GPIO1; 15 GPIO1; 17 GPIO1; 20 GPIO1; 22 GPIO1; 24 GPIO1; 26 GPIO1; 28 GPIO1; 30 GPIO1; 32 GPIO1; 34 GPIO1; 36 GPIO1; 38 GPIO1; 40 GPIO1; 42 GPIO1; 44 GPIO1; 46 GPIO1; 48 GPIO1; 50 GPIO1; N0ENCODER0 N0ENCODER0; N0ENCODER1 N0ENCODER1; N0ENCODER2 N0ENCODER2; N0ENCODER3 N0ENCODER3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

These signals are aviable on the 60pin connector on the power/motor driver/ultrasonic board

AMP-FH-120-RECEPTABLE-H9-H13

Low Battery Power Good

AMP-FH-120-Plug

GECKO3 Power and I/O Bus Title: | Berne University of Applied Science School of Engineering and Information Technology CH-2501 Biel

Size: A3_L | Author: zac1 | Revision: 1.0
Date: File: 23.07.2008 Time: 13:34:55 | | Sheet 7 of | Quellgasse 21 19

io-bus.SchDoc

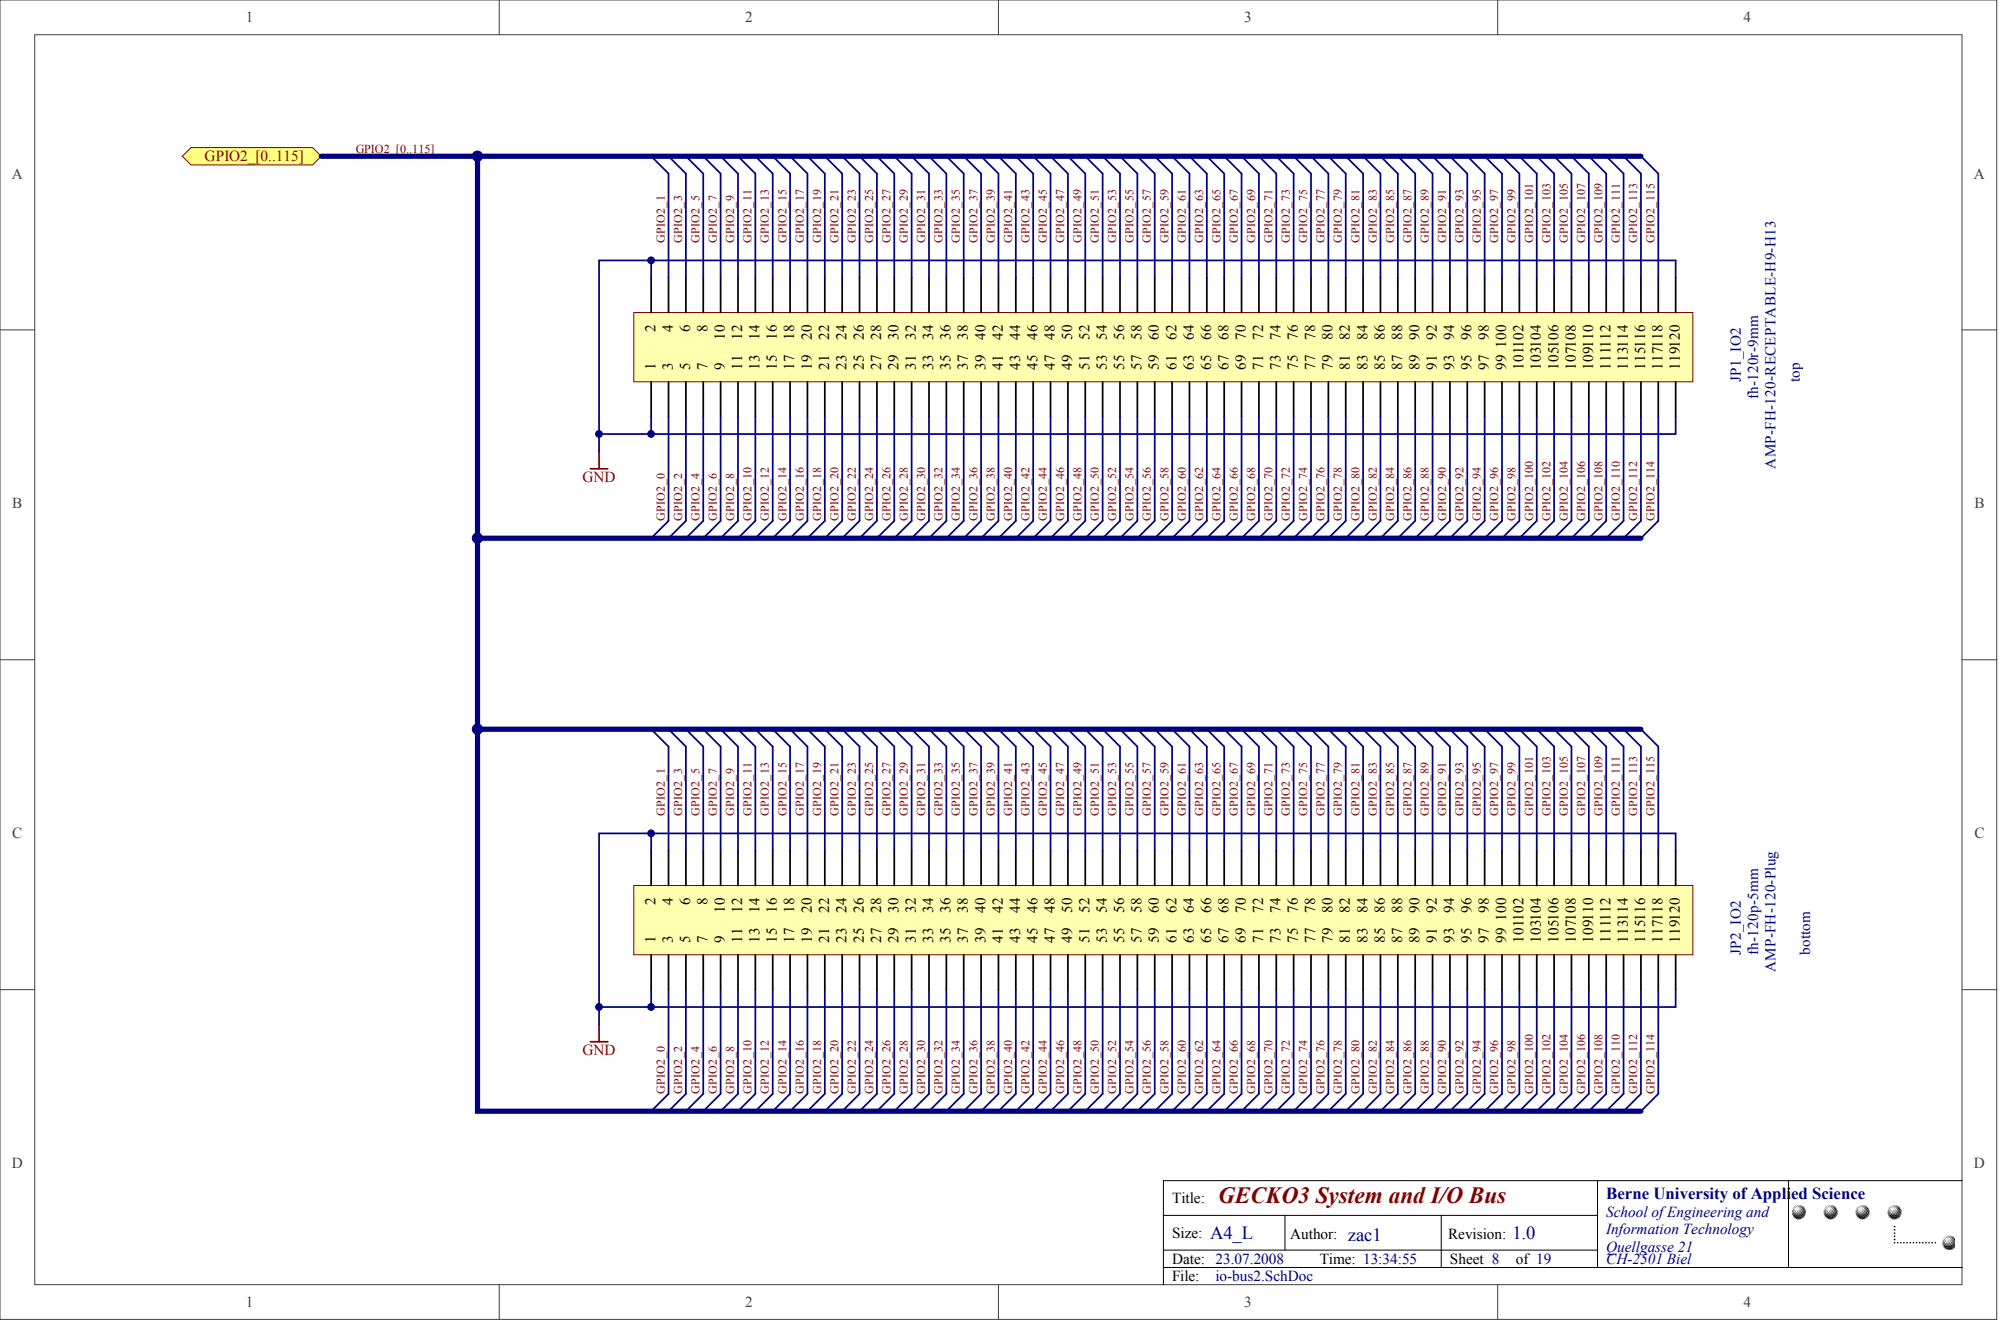
[picture p27: page 4]
2 GPIO2; 4 GPIO2; 6 GPIO2; 8 GPIO2; 10 GPIO2; 12 GPIO2; 14 GPIO2; 16 GPIO2; 18 GPIO2; 20 GPIO2; 22 GPIO2; 24 GPIO2; 26 GPIO2; 28 GPIO2; 30 GPIO2; 32 GPIO2; 34 GPIO2; 36 GPIO2; 38 GPIO2; 40 GPIO2; 42 GPIO2; 44 GPIO2; 46 GPIO2; 48 GPIO2; 50 GPIO2; 52 GPIO2; 54 GPIO2; 56 GPIO2; 58 GPIO2; 60 GPIO2; 62 GPIO2; 64 GPIO2; 66 GPIO2; 68 GPIO2; 70 GPIO2; 72 GPIO2; 74 GPIO2; 76 GPIO2; 78 GPIO2; 80 GPIO2; 82 GPIO2; 84 GPIO2; 86 GPIO2; 88 GPIO2; 90 GPIO2; 92 GPIO2; 94 GPIO2; 96 GPIO2; 98 GPIO2; 100 GPIO2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

AMP-FH-120-RECEPTABLE-H9-H13

AMP-FH-120-Plug

GECKO3 System and I/O Bus Title: | Berne University of Applied Science School of Engineering and Information Technology CH-2501 Biel

Size: A4_L | Author: zac1 | Revision: 1.0 | Quellgasse 21 19

Date: File: 23.07.2008 Time: 13:34:55 | | Sheet 8 of

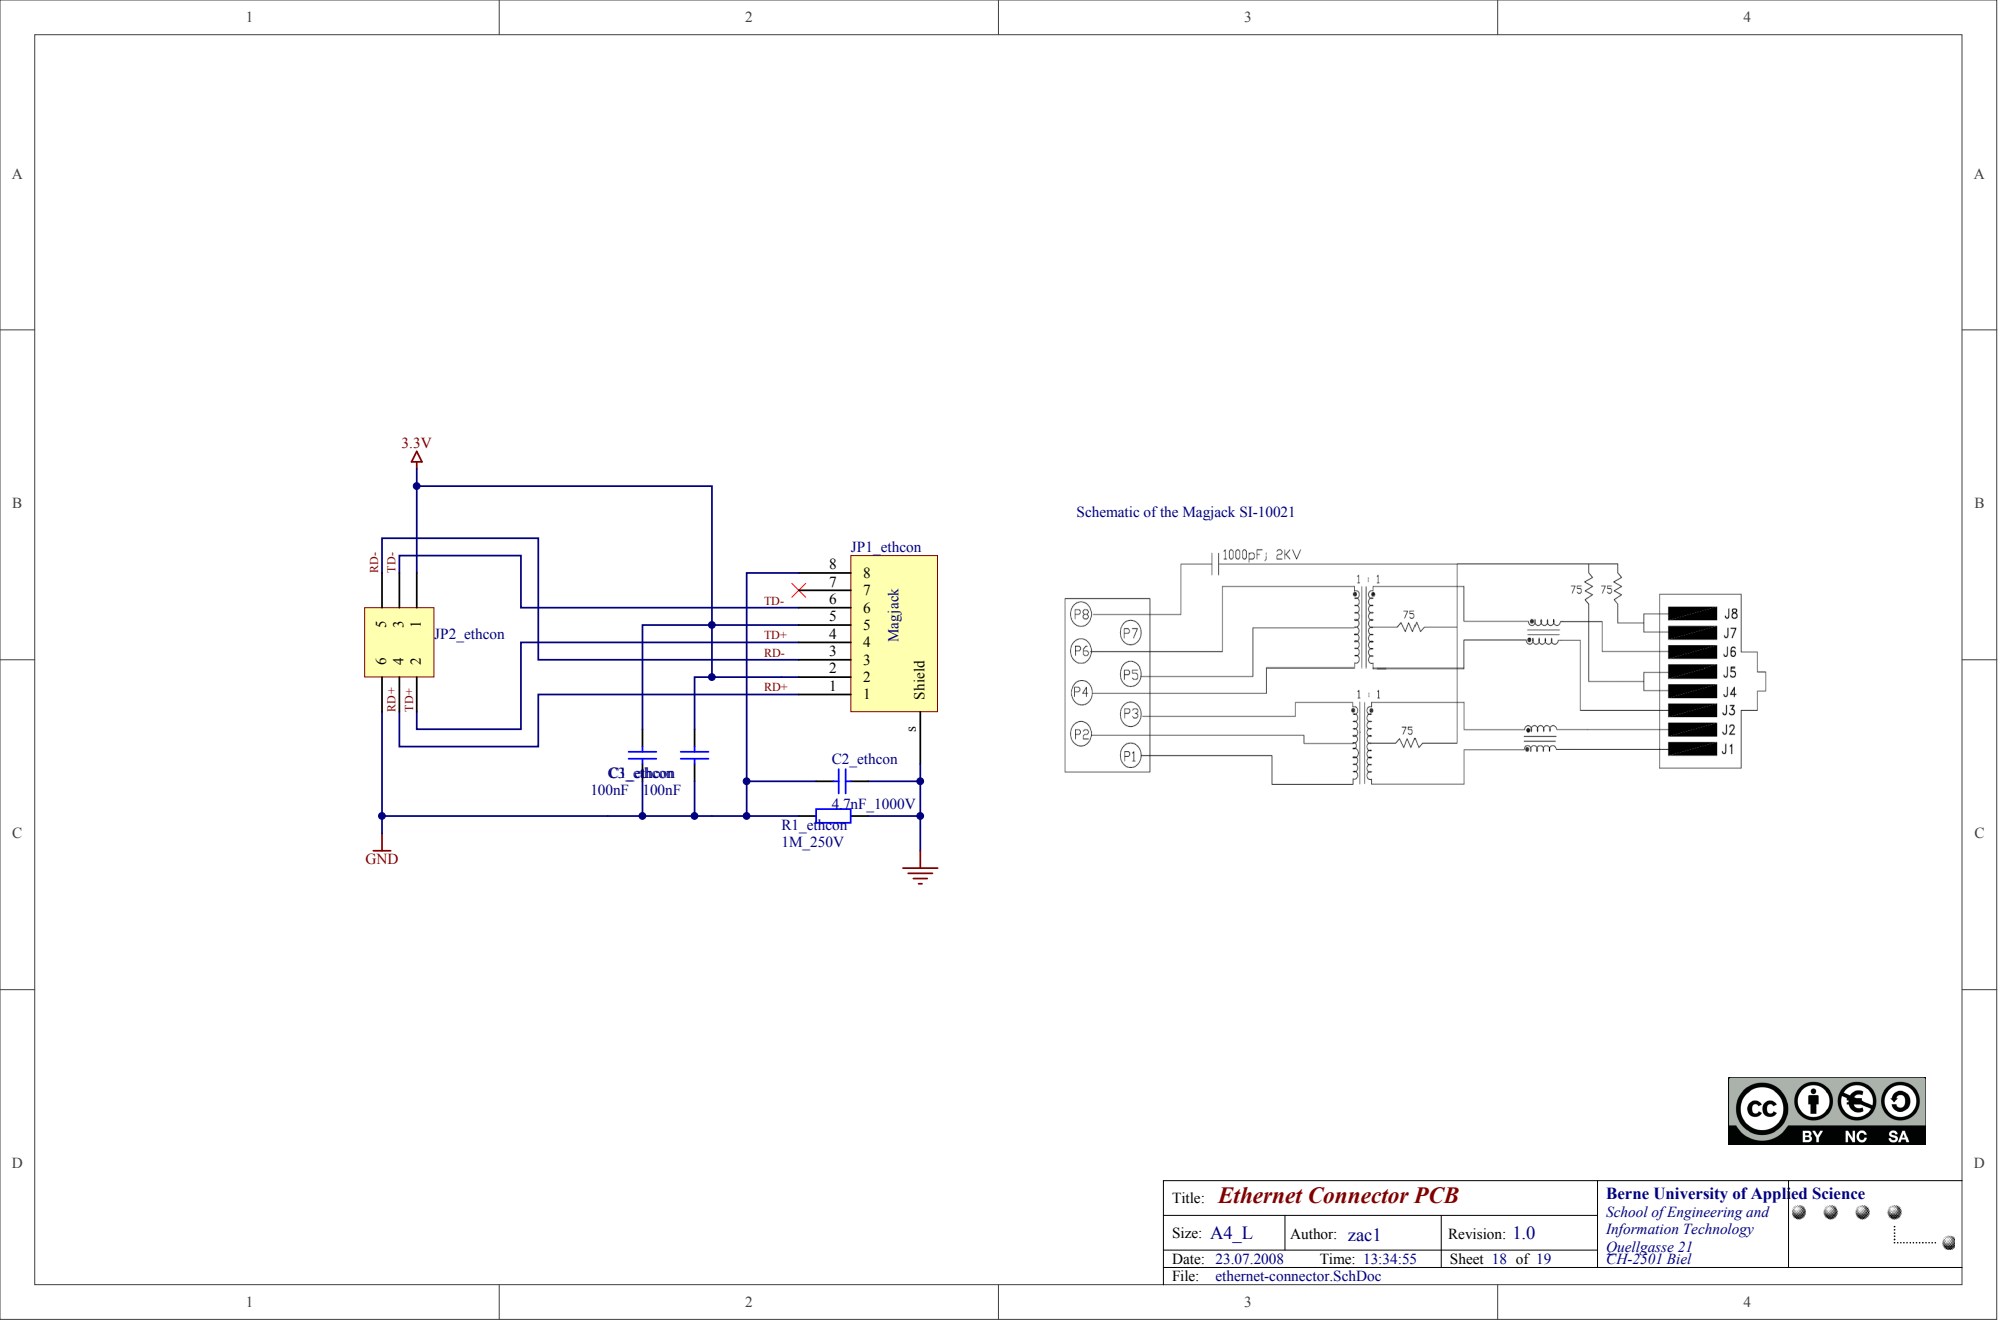
[picture p28: page 5]
Shield s; P0C10ethcon01 P0C10ethcon02; P0C20ethcon02 P0C20ethcon01; P0C30ethcon01 P0C30ethcon02; P0JP20ethcon01 P0JP20ethcon02; P0JP20ethcon03 P0JP20ethcon04; P0JP20ethcon05 P0JP20ethcon06; P0R10ethcon02 P0R10ethcon01

Schematic of the Magjack SI

JP2_ethcon | | RD+ TD- TD+ N0TD+ | | 4 P0JP10ethcon04 P0JP10ethcon04 P0JP10ethcon04 P0JP10ethcon04

5 P0JP10ethcon05 P0JP10ethcon05 P0JP10ethcon05 P0JP10ethcon05

RD-N0RD0 | | 3 P0JP10ethcon03 P0JP10ethcon03 P0JP10ethcon03 P0JP10ethcon03

2 P0JP10ethcon02 P0JP10ethcon02 P0JP10ethcon02 P0JP10ethcon02
N0RD+ | 1 P0JP10ethcon01 P0JP10ethcon01 P0JP10ethcon01 P0JP10ethcon01

Ethernet Connector PCB Title: | Berne University of Applied Science School of Engineering and Information Technology CH-2501 Biel

Size: A4_L | Author: zac1 | Revision: 1.0 | Quellgasse 21 19

Date: File: 23.07.2008 Time: 13:34:55 | | Sheet 18 of

ethernet-connector.SchDoc

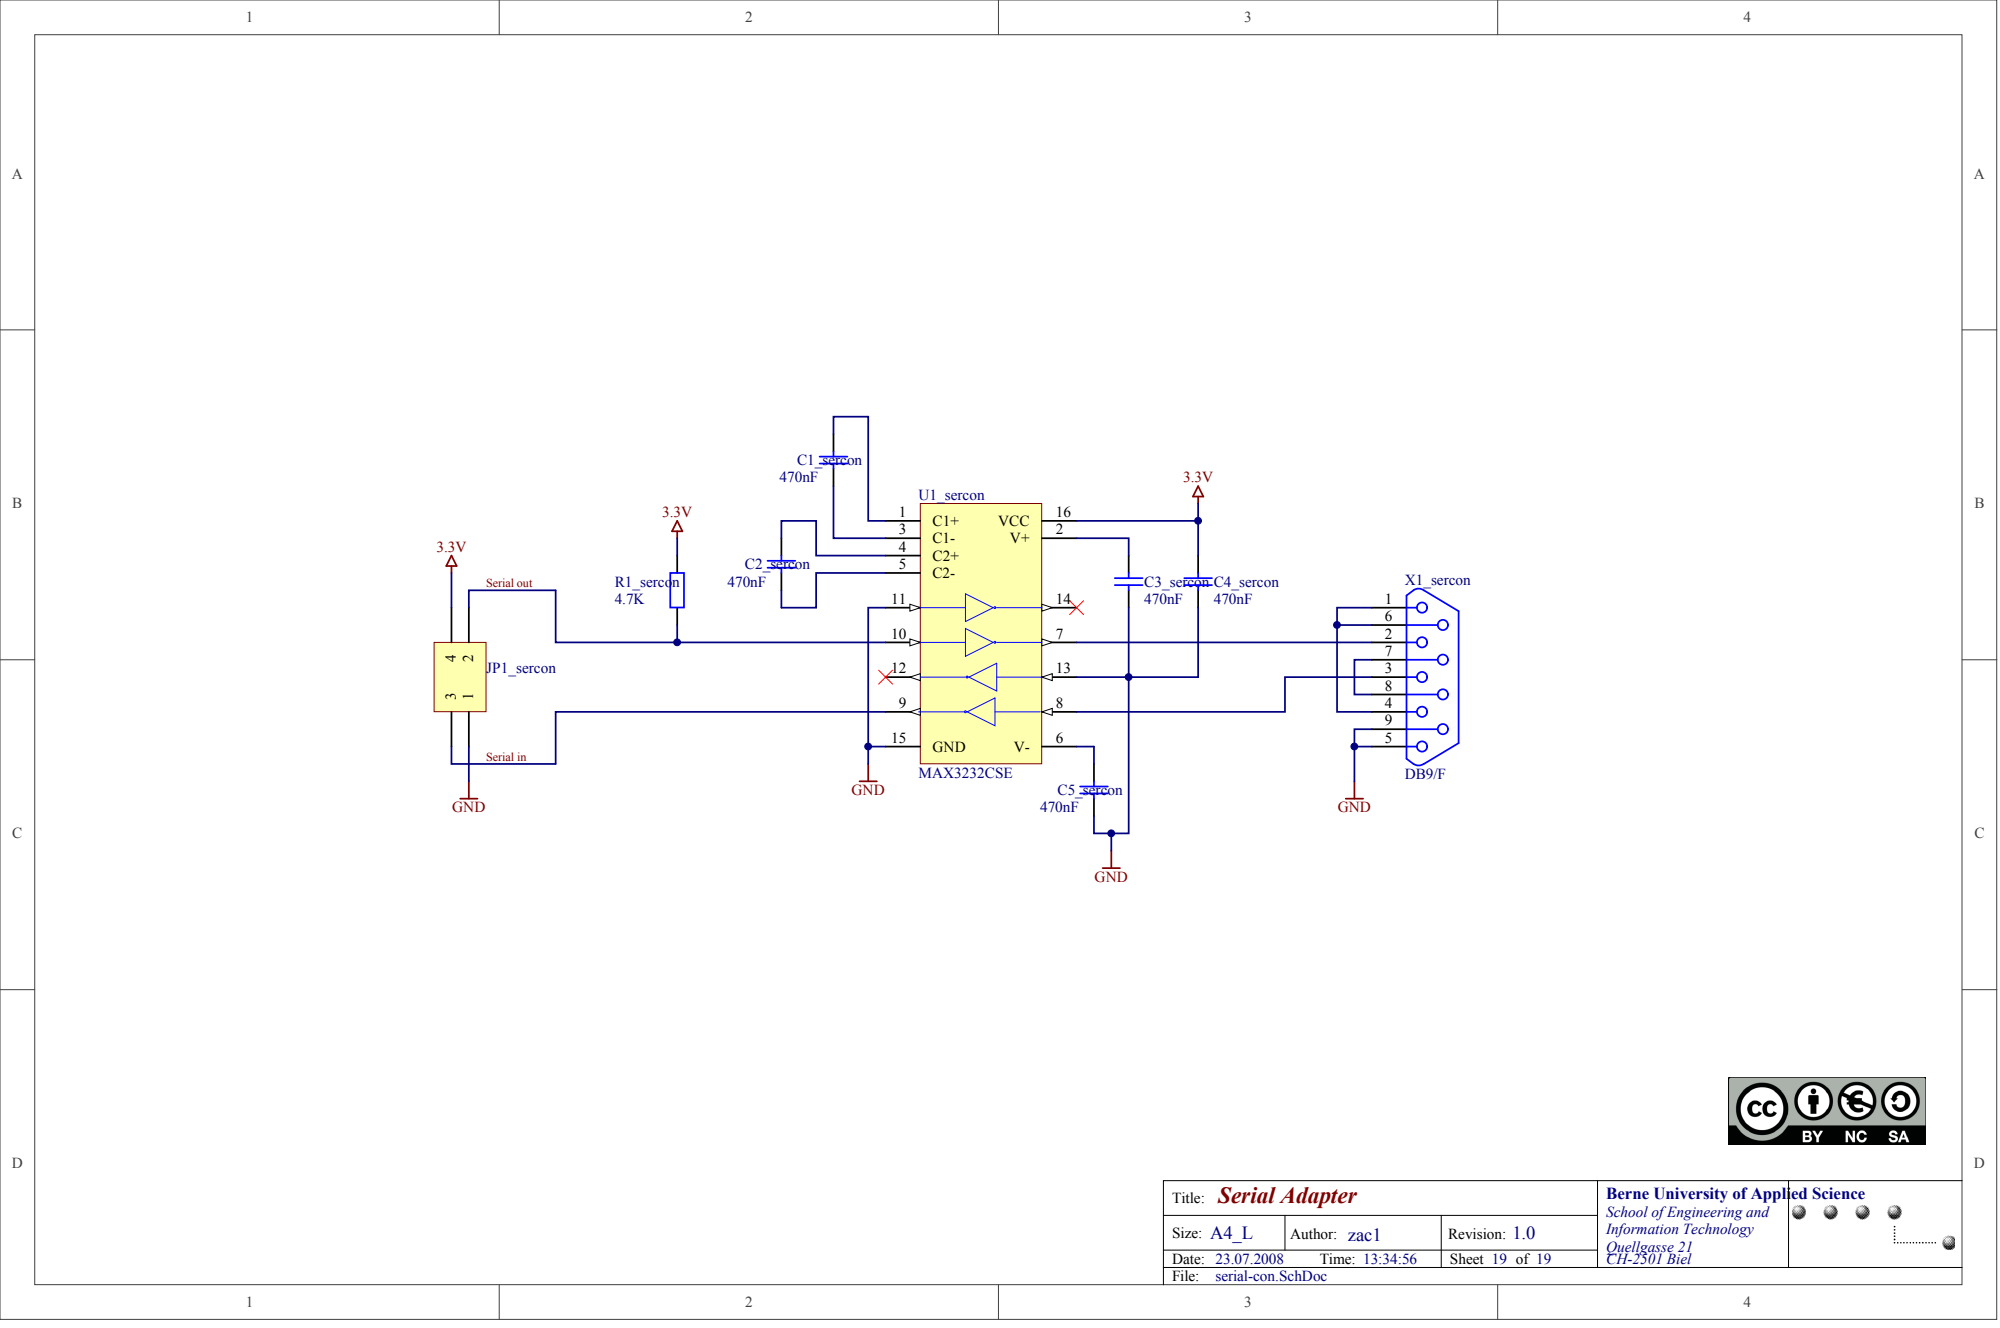
[picture p29: page 6]
GND 15; Serial out; P0C10sercon01 P0C10sercon02; P0C20sercon01 P0C20sercon02; P0C30sercon01 P0C30sercon02; P0C40sercon01 P0C40sercon02; P0C50sercon01 P0C50sercon02; P0JP10sercon01 P0JP10sercon02; P0JP10sercon03 P0JP10sercon04; P0R10sercon01 P0R10sercon02; P0U10sercon02 P0U10sercon03; P0U10sercon08 P0U10sercon09; N0SERIAL OUT

Serial in N0SERIAL IN N0SERIAL IN

Serial Adapter Title: | Berne University of Applied Science School of Engineering and Information Technology CH-2501 Biel

Size: A4_L | Author: zac1 | Revision: 1.0 | Quellgasse 21 19

Date: File: 23.07.2008 Time: 13:34:56 | | Sheet 19 of

serial-con.SchDoc

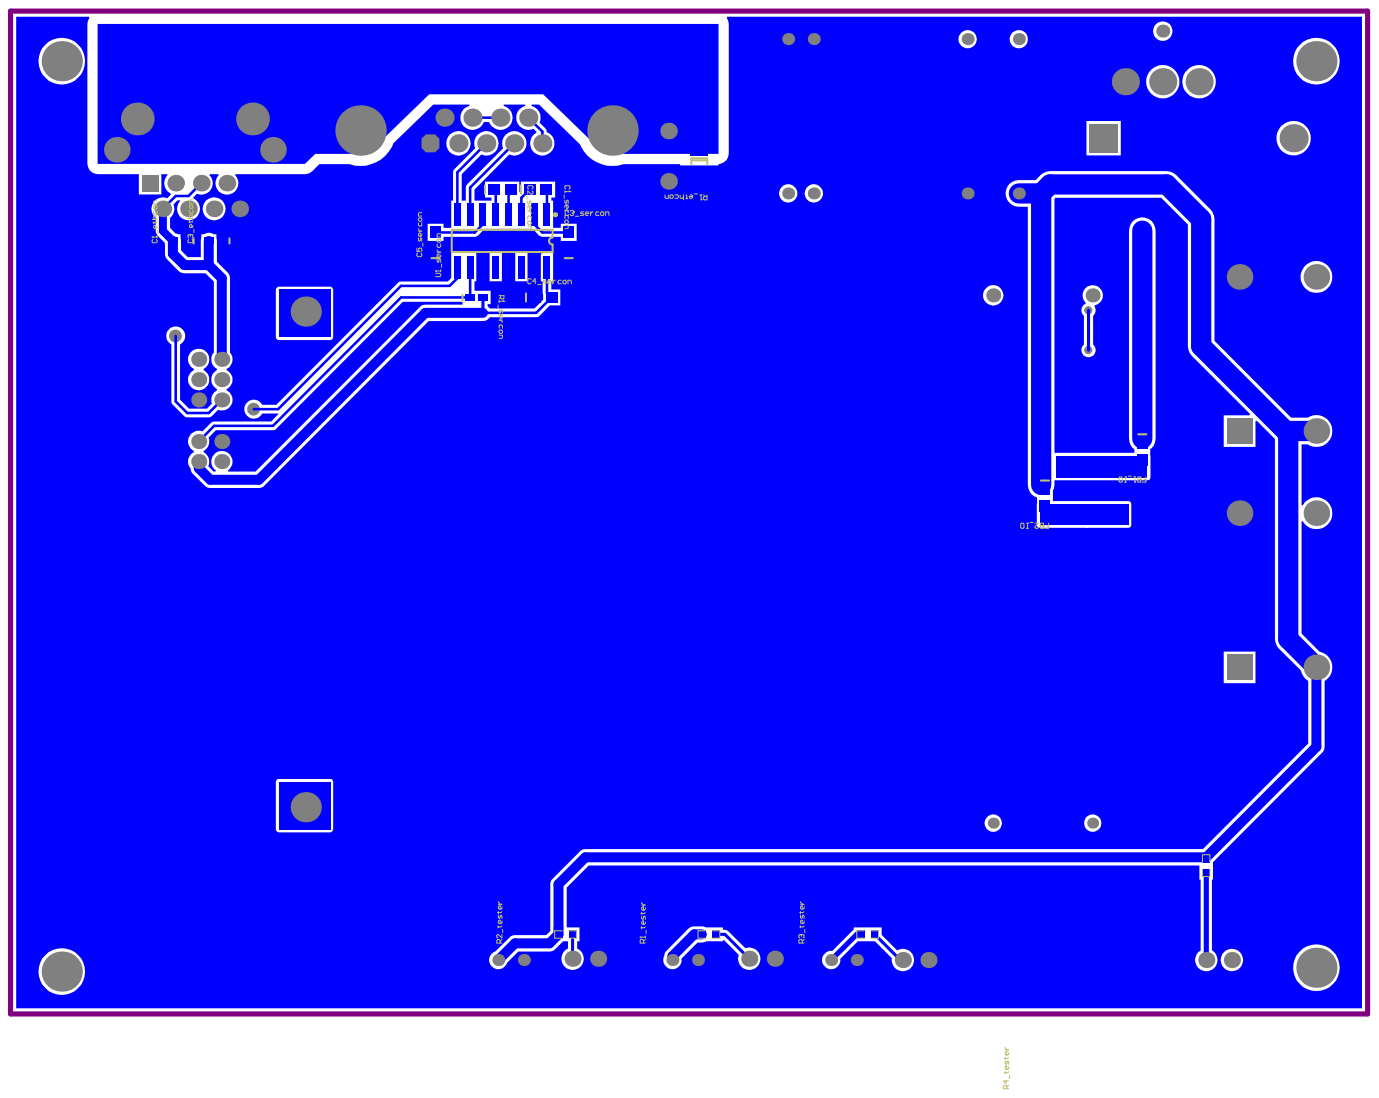
[picture p30: page 7]
P0C10ethcon02 P0C10ethcon01 C10ethcon; P0C10sercon01 P0C10sercon02 C20sercon; P0C20sercon01 P0C20sercon02; P0C30ethcon02 P0C30ethcon01 C30ethcon; C30sercon P0C30sercon01 P0C30sercon02; P0C40sercon01 P0C40sercon02; P0C50sercon01 P0C50sercon02; P0R10sercon01 P0R10sercon02; P0R10tester01 P0R10tester02; P0C10ethcon02 P0C30ethcon02; P0JP10ethcon02 P0JP10ethcon05; P0JP10ethcon0s; P0R10ethcon01 P0X10sercon0; P0JP10sercon01 P0JP20ethcon06; P0U10tester02 P0U10tester03; P0C10sercon01 P0U10sercon03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

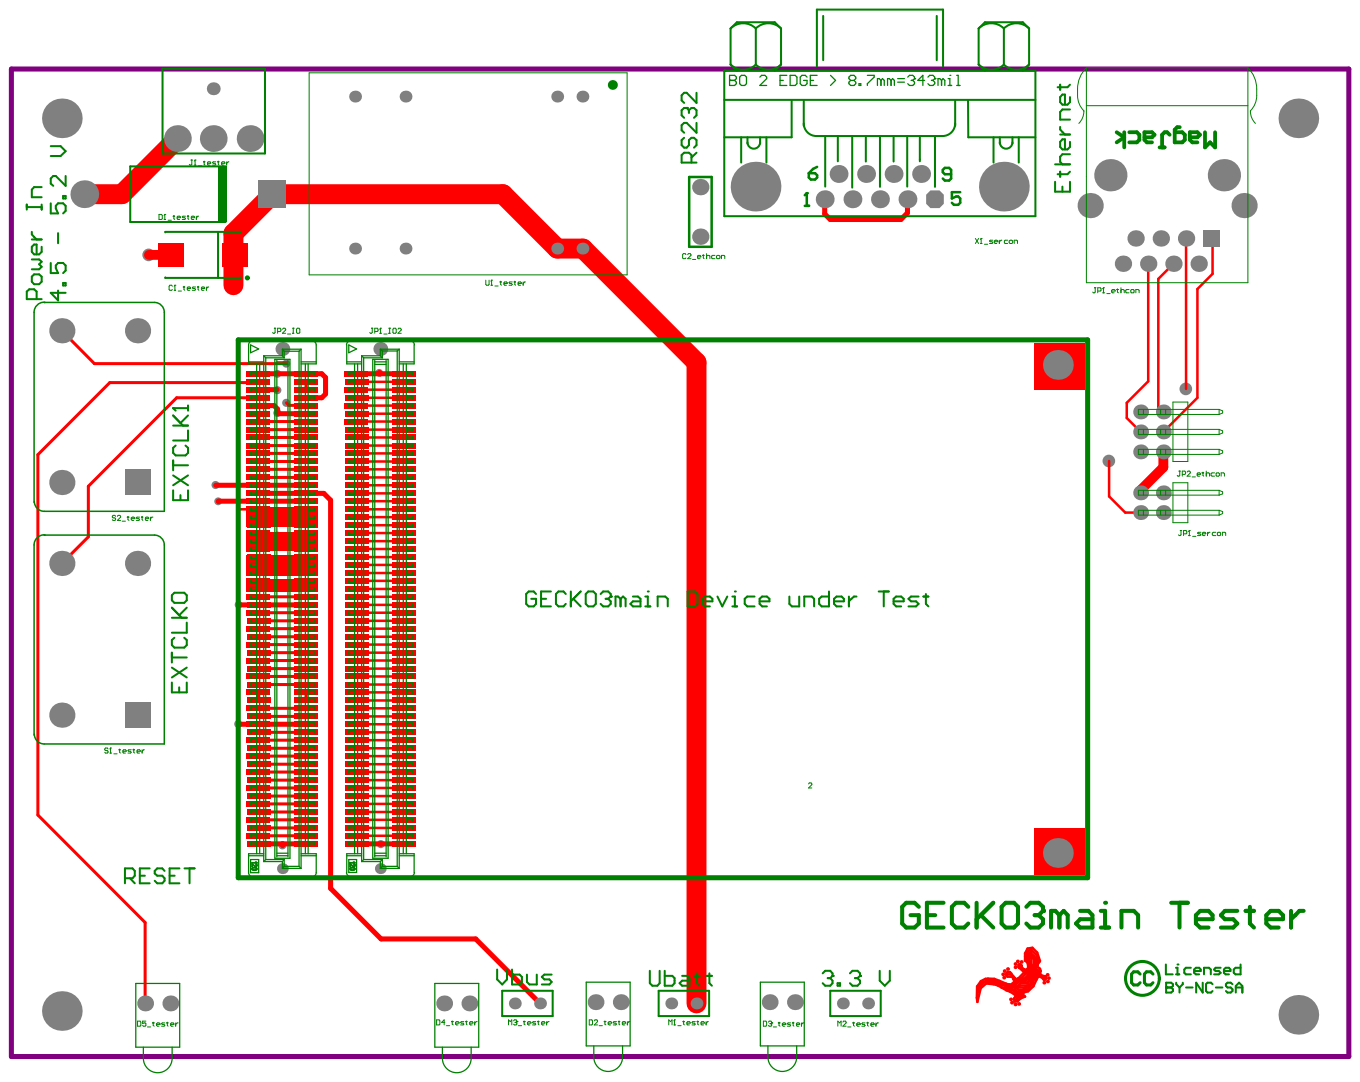
[picture p31: page 8]
P0C10tester02 P0C10tester01; C20ethcon; P0D20tester01 P0D20tester02; D30tester P0D30tester01; P0D40tester02 P0D40tester01; P0D50tester02 P0D50tester01; P0J10tester01 P0J10tester02 P0J10tester03; P0JP10ethcon02 P0JP10ethcon03; P0JP10ethcon04 P0JP10ethcon05; P0JP10sercon01 P0JP10sercon02; P0JP10sercon03 P0JP10sercon04; P0JP20ethcon01 P0JP20ethcon02; P0JP20ethcon03 P0JP20ethcon04 P0JP20ethcon05; P0JP20ethcon06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
