freecores/gecko3/GECKO3COM/gecko3com-ip/doc/GECKO3COM_simple_test_2.png

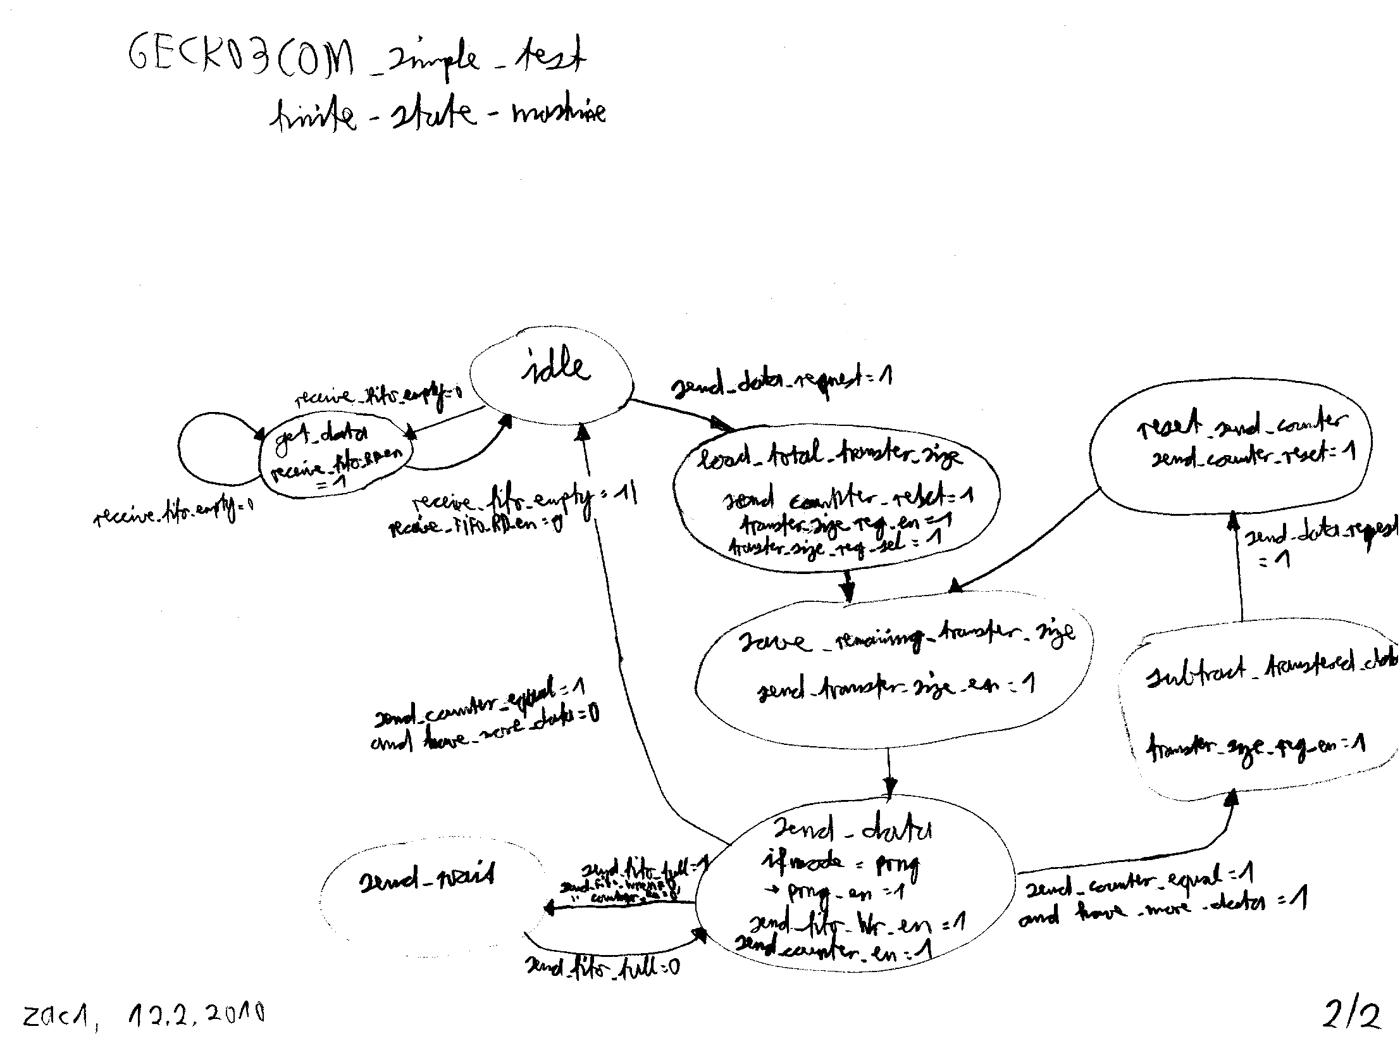
GECKO3COM/gecko3com-ip/doc/GECKO3COM_simple_test_2.png
