freecores/gecko3/GECKO3COM/gecko3com-ip/doc/gpif_com_test.png

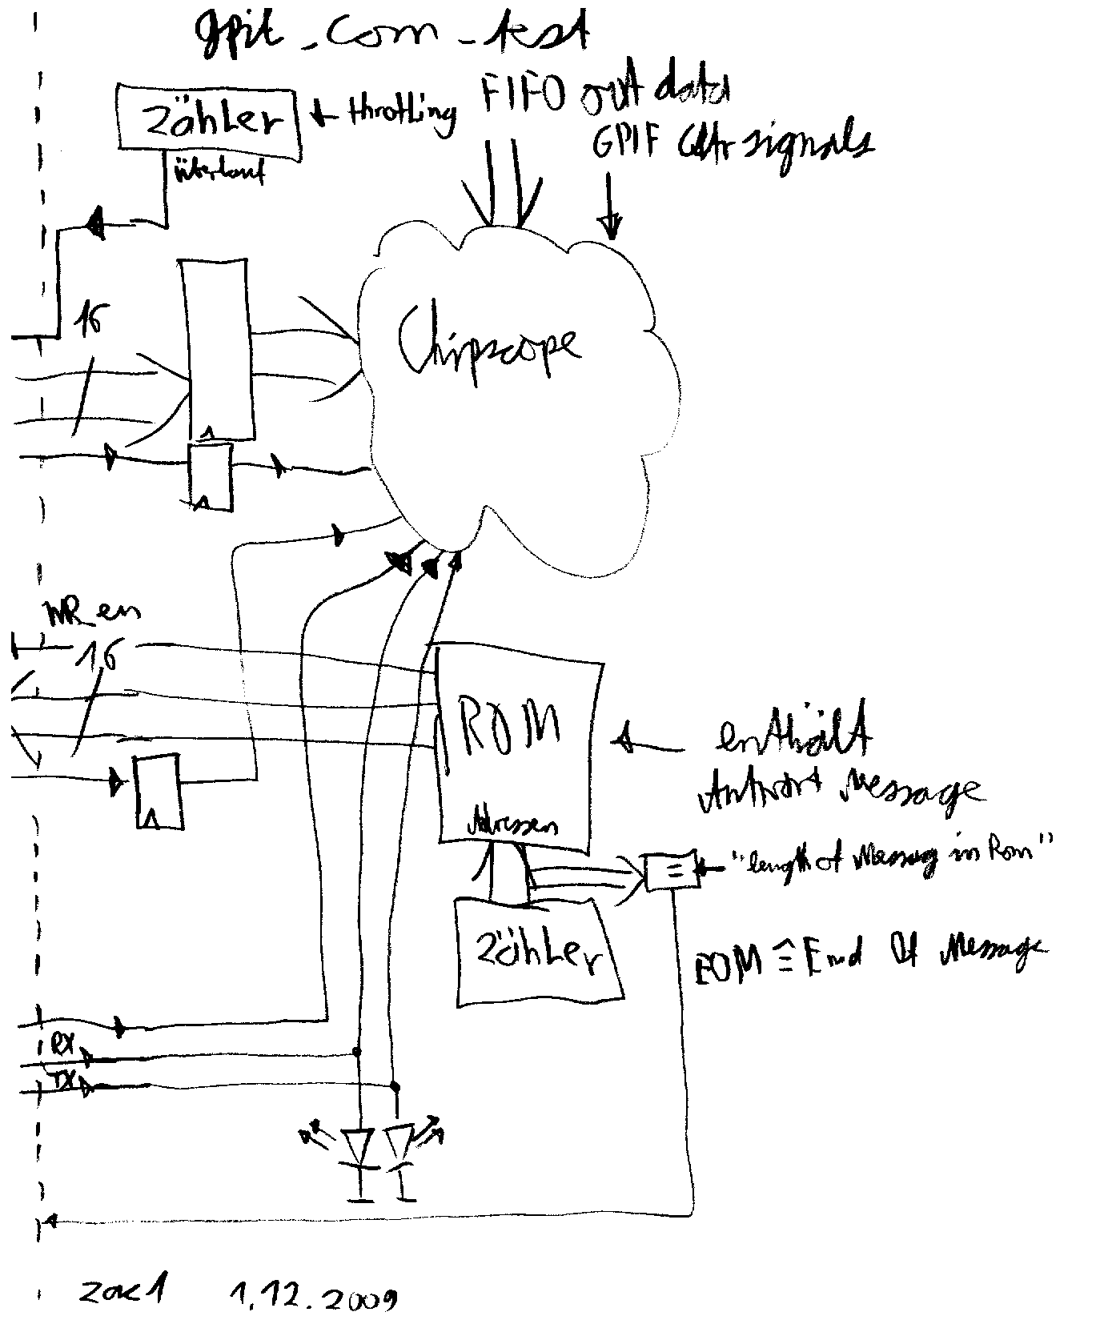
GECKO3COM/gecko3com-ip/doc/gpif_com_test.png
