freecores/gecko3/GECKO3basic/GECKO3basic.pdf

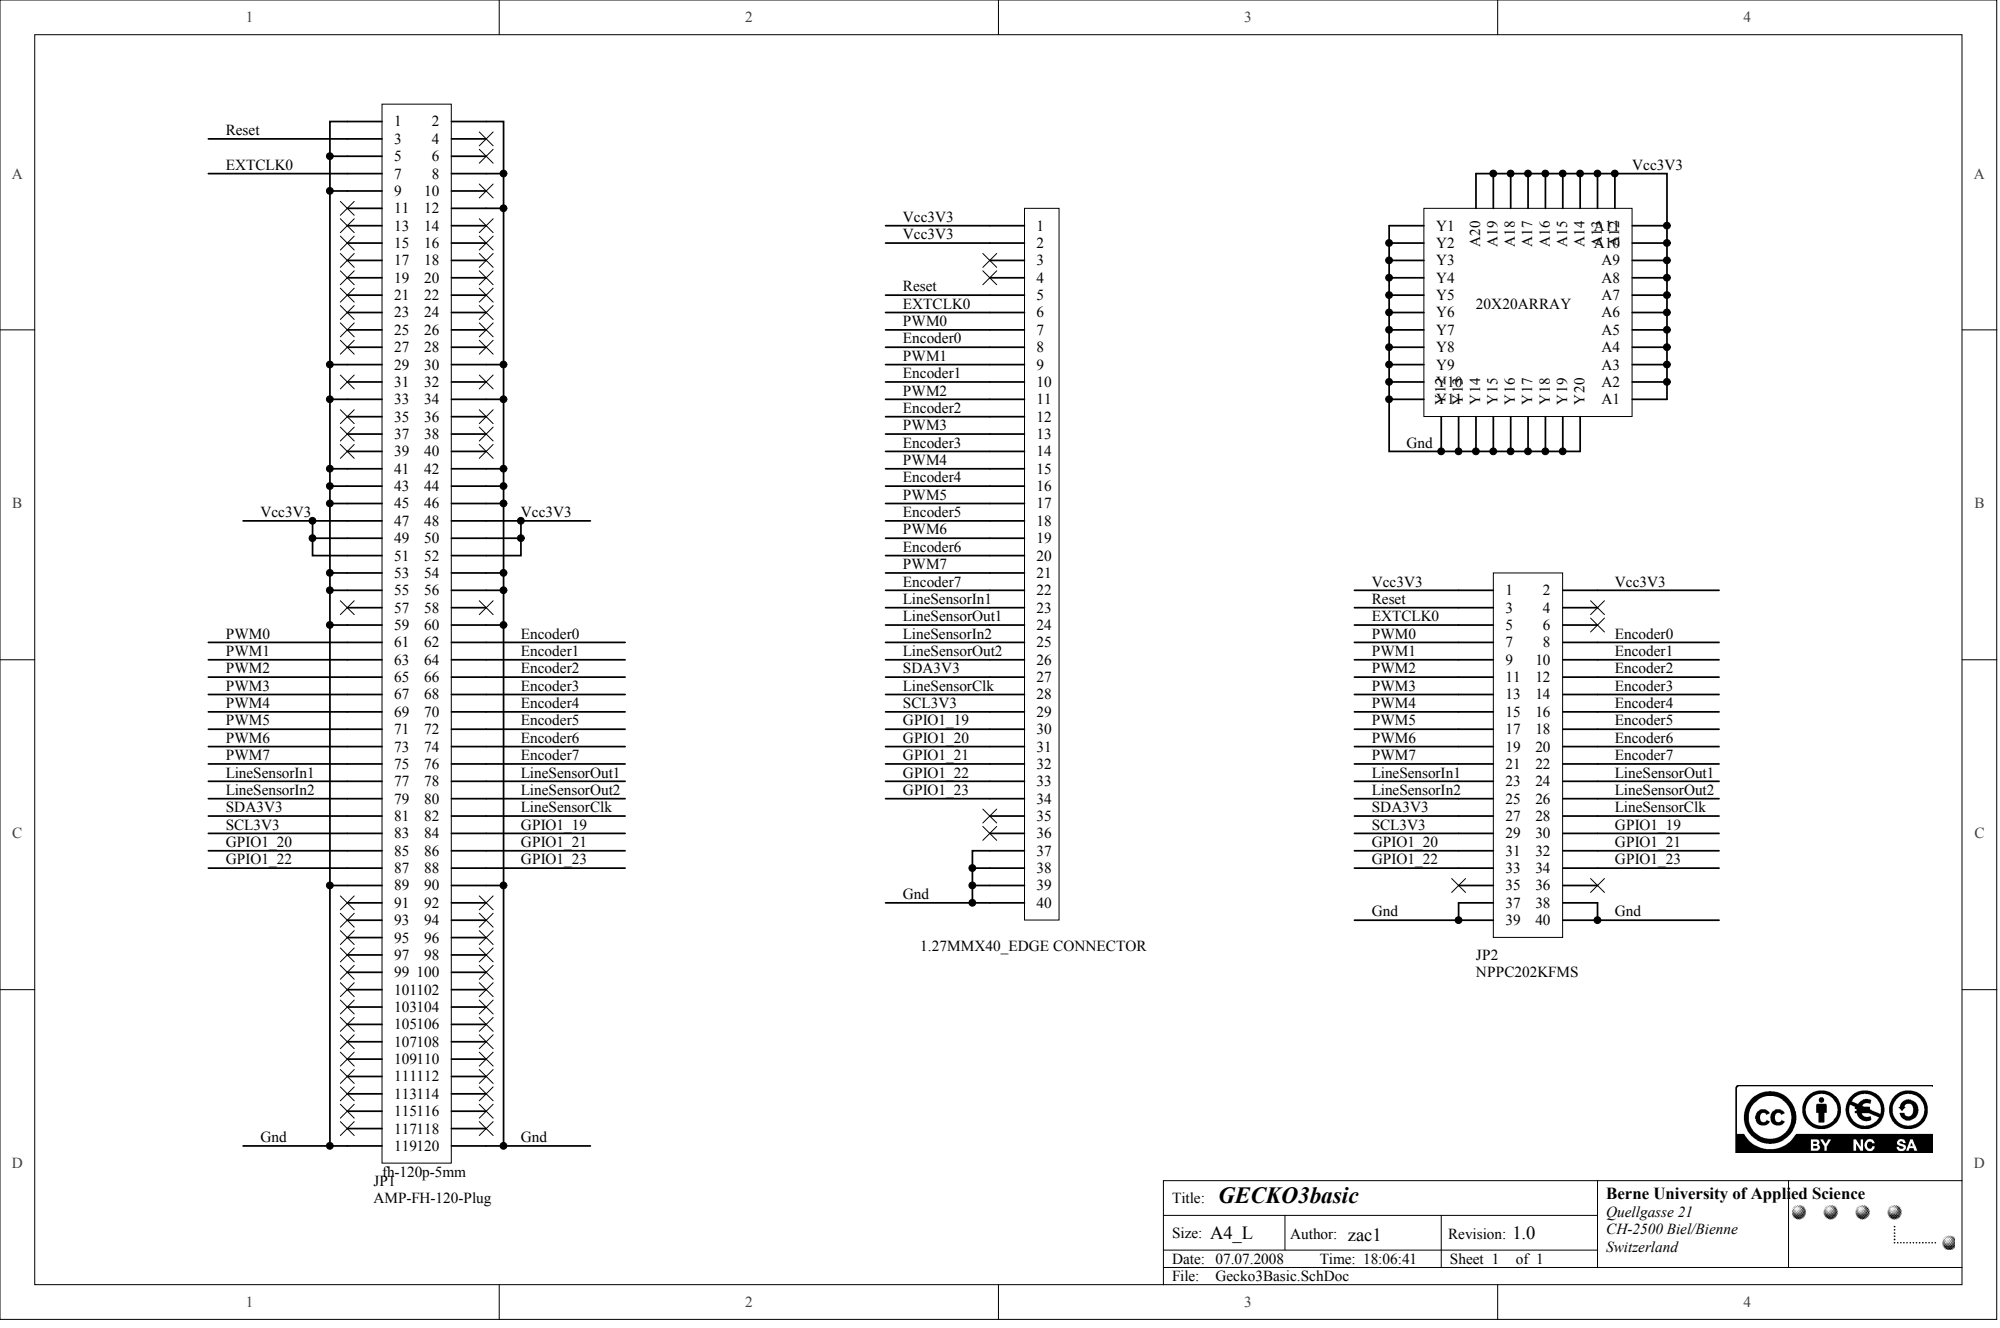
[picture p38: page 1]
Gnd LineSensorClk LineSensorOut2 LineSensorOut1; Vcc3V3; Vcc3V3 PWM0 PWM1 PWM2 PWM3 PWM4 PWM5 PWM6 PWM7 LineSensorIn1 LineSensorIn2; LineSensorClk LineSensorOut2 LineSensorOut1; PWM0 PWM1 PWM2 PWM3 PWM4 PWM5 PWM6 PWM7 LineSensorIn1 LineSensorIn2; Vcc3V3 1; 1.27MMX40_EDGE CONNECTOR; Vcc3V3 PWM0; Encoder0 PWM1; Encoder1 PWM2; Encoder2 PWM3; Encoder3 PWM4; Encoder4 PWM5; Encoder5 PWM6; Encoder6 PWM7; Encoder7 LineSensorIn1 LineSensorOut1 LineSensorIn2 LineSensorOut2; P0Array010Y11 P0Array010Y12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

P0SIP01038

Gnd

GECKO3basic Title: | Berne University of Applied Science Quellgasse 21 CH-2500 Biel/Bienne Switzerland

Size: A4_L | Author: zac1 | Revision: 1.0

Date: File: 07.07.2008 Time: 18:06:41 | | Sheet 1 of 1

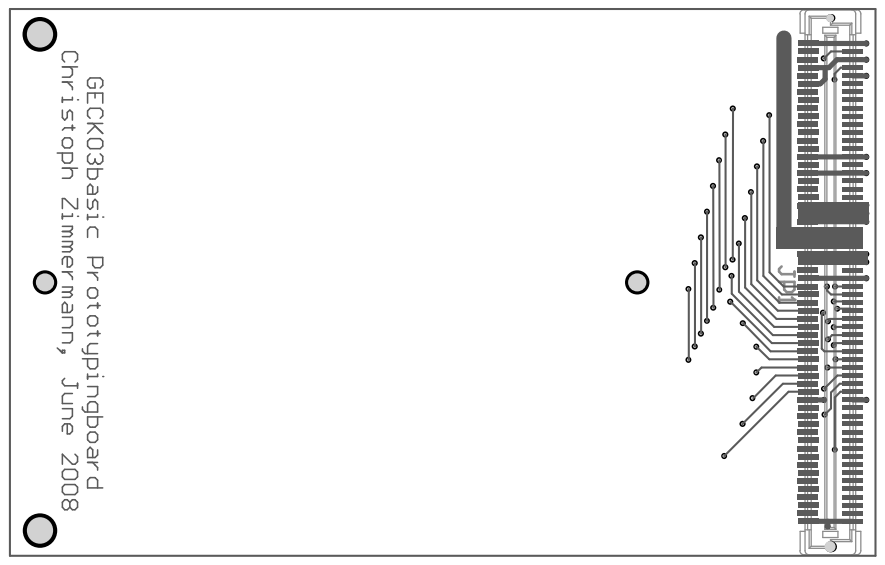
[picture p39: page 2]
P0JP10112 P0JP10111 P0JP10114 P0JP10113 P0JP10116 P0JP10115 P0JP10118 P0JP10117 P0JP10120 PJP10119

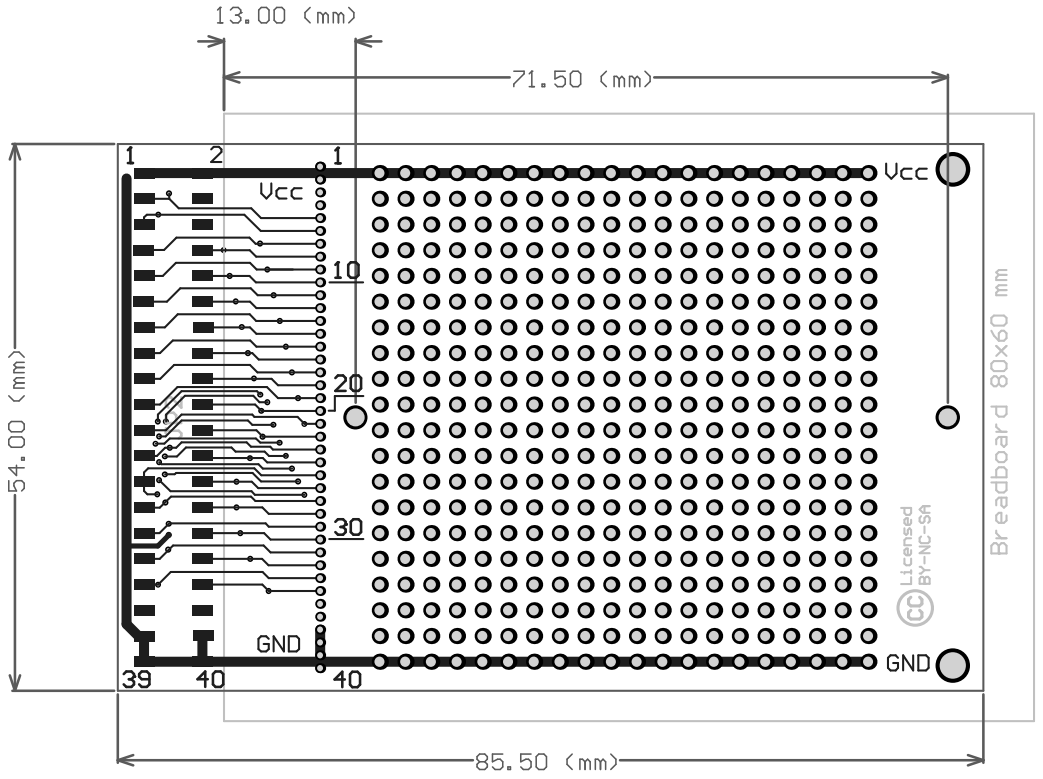
[picture p40: page 3]
P0Array010A1 P0Array010A2 P0Array010A3 P0Array010A4 P0Array010A5 P0Array010A6 P0Array010A7 P0Array010A8 P0Array010A9 P0Array010A10 P0Array010A11 P0Array010A12 P0Array010A13 P0Array010A14 P0Array010A15 P0Array010A16 P0Array010A17 P0Array010A18 P0Array010A19 P0Array010A20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
