freecores/gecko3/GECKO3main/ethernet-con.pdf

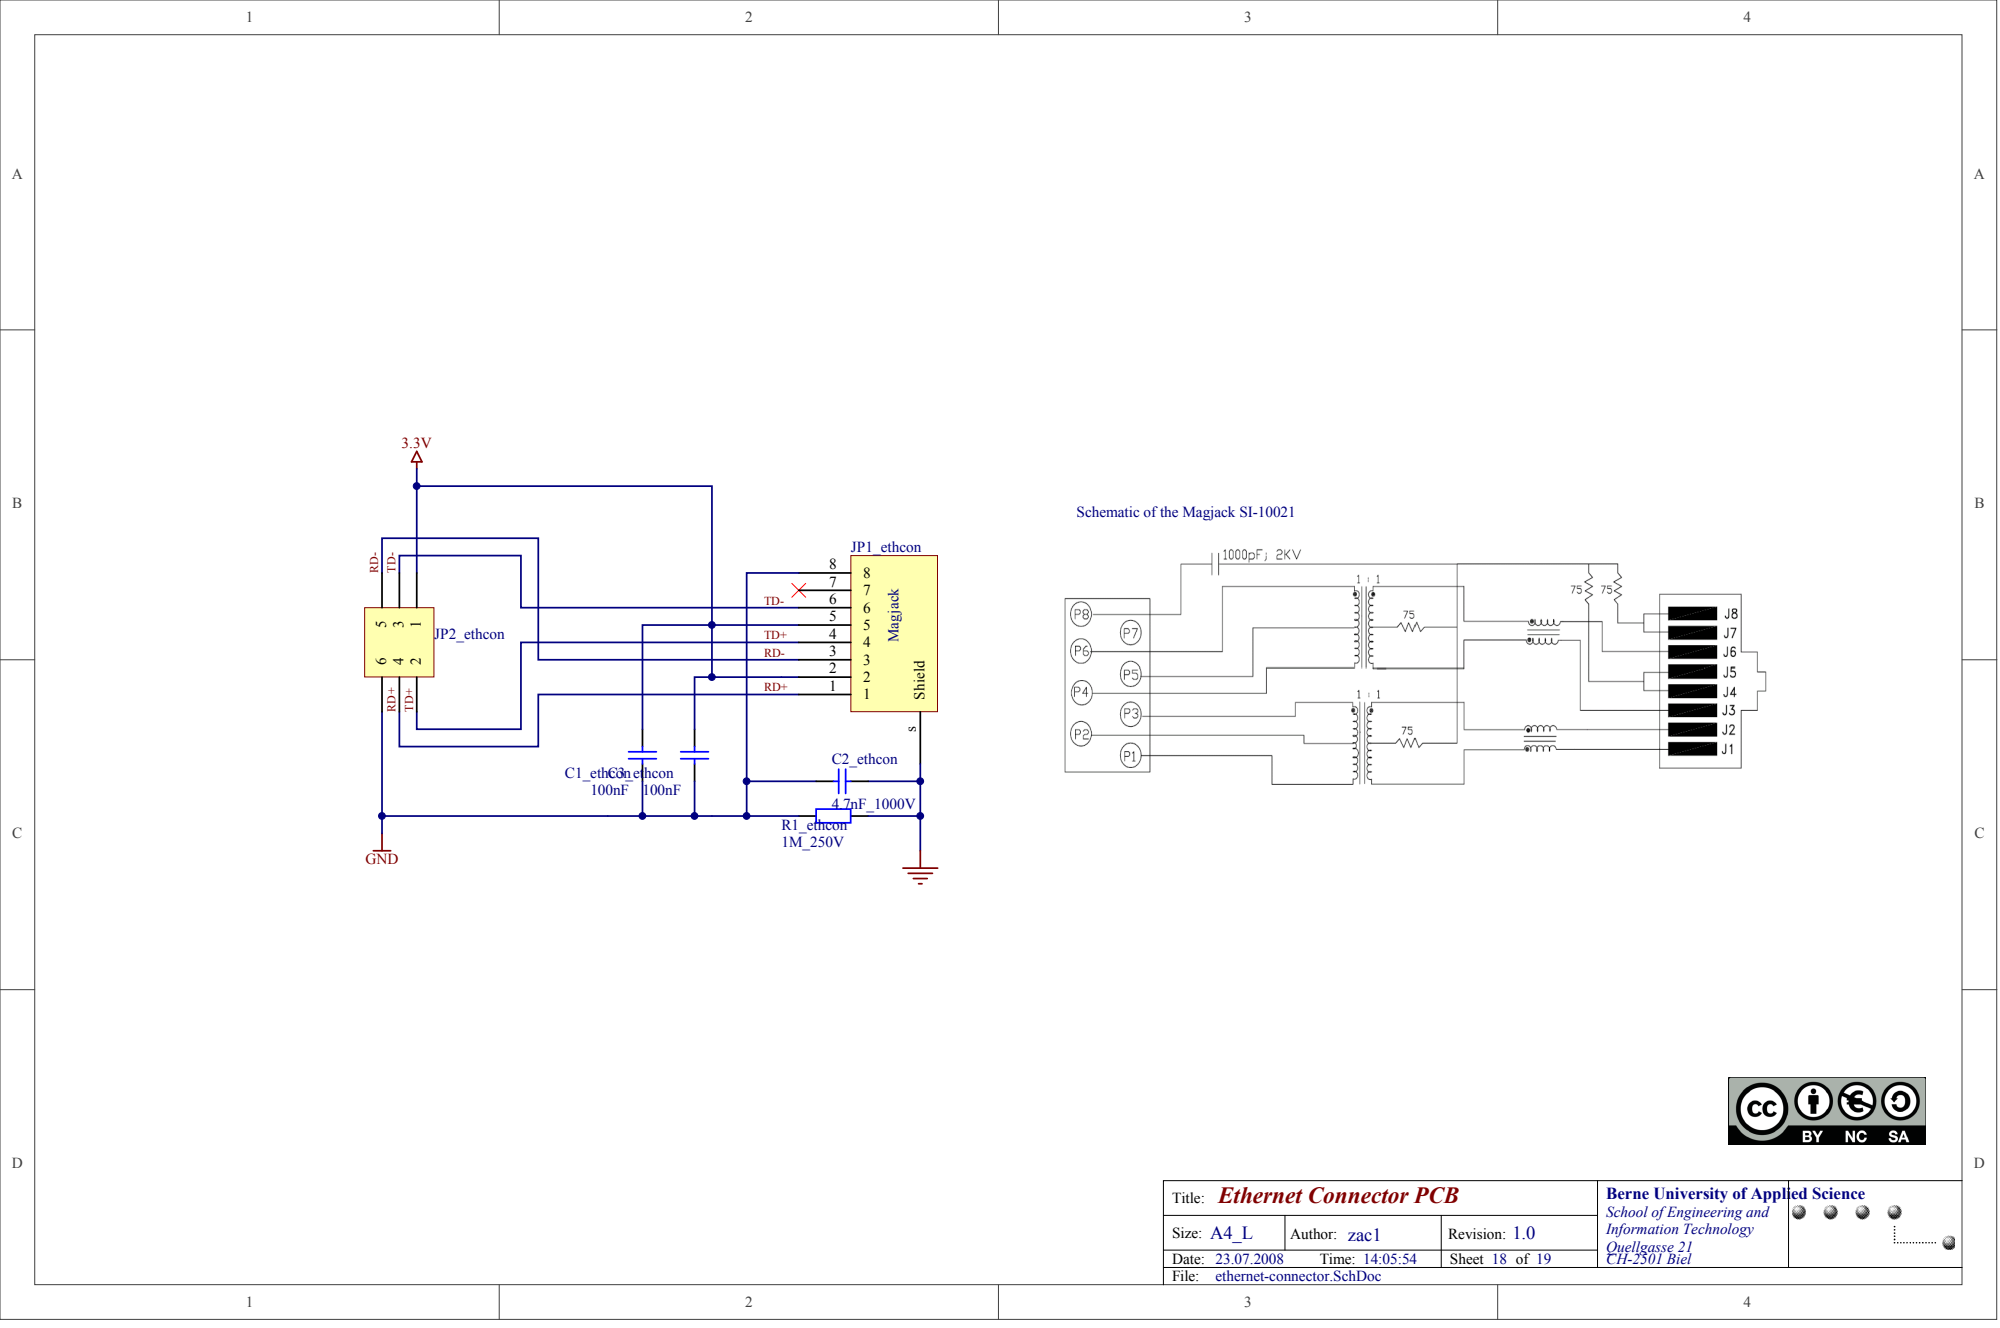
[picture p41: page 1]
Shield s; P0C10ethcon01 P0C10ethcon02; P0C20ethcon02 P0C20ethcon01; P0C30ethcon01 P0C30ethcon02; P0JP20ethcon01 P0JP20ethcon02; P0JP20ethcon03 P0JP20ethcon04; P0JP20ethcon05 P0JP20ethcon06; P0R10ethcon02 P0R10ethcon01

Schematic of the Magjack SI

JP2_ethcon | | RD+ TD- TD+ N0TD+ | | 4 P0JP10ethcon04 P0JP10ethcon04 P0JP10ethcon04

5 P0JP10ethcon05 P0JP10ethcon05 P0JP10ethcon05

RD-N0RD0 | | 3 P0JP10ethcon03 P0JP10ethcon03 P0JP10ethcon03

2 P0JP10ethcon02 P0JP10ethcon02 P0JP10ethcon02
N0RD+ | 1 P0JP10ethcon01 P0JP10ethcon01 P0JP10ethcon01

Ethernet Connector PCB Title: | Berne University of Applied Science School of Engineering and Information Technology CH-2501 Biel

Size: A4_L | Author: zac1 | Revision: 1.0 | Quellgasse 21 19

Date: File: 23.07.2008 Time: 14:05:54 | | Sheet 18 of

ethernet-connector.SchDoc

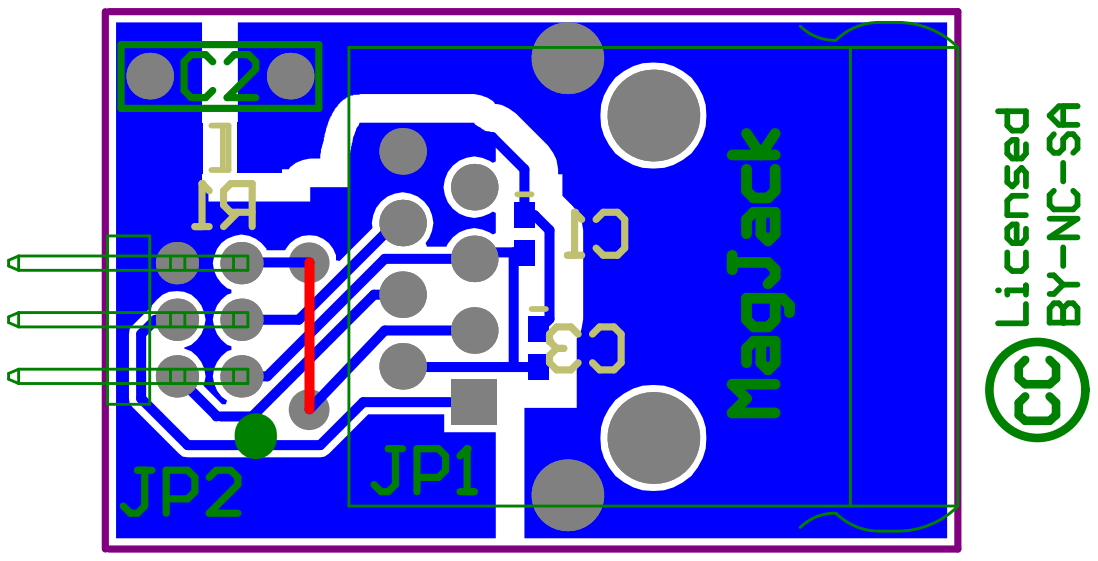
[picture p42: page 2]

P0JP204 P0JP203
P0JP202
