freecores/gecko3/GECKO3power/60pin_to_120pin_adapter/PCB_60PIN_120PIN.pdf

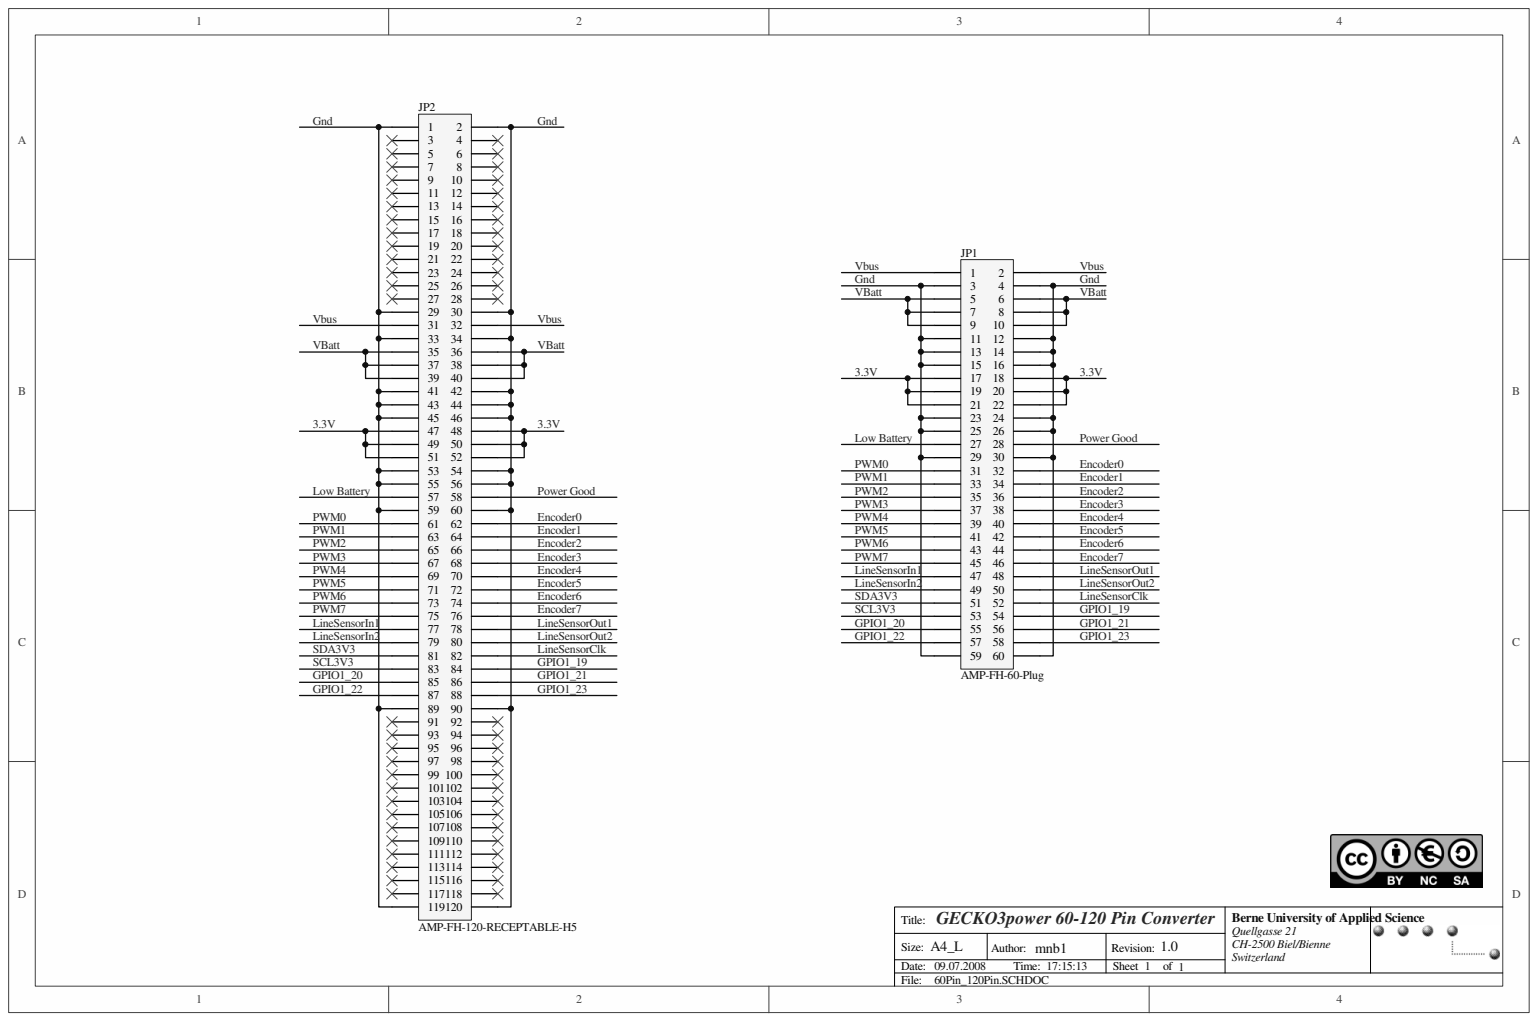
[picture p43: page 1]
GECKO3power 60-120 Pin Converter; mnb1; 09.07.2008 17:15:13 60Pin_120Pin.SCHDOC; Title:; Size:; Author:; Date: File:; Time:; Sheet; Revision:; AMP-FH-120-RECEPTABLE-H5; AMP-FH-60-Plug; Encoder0 Encoder1 Encoder2 Encoder3 Encoder4 Encoder5 Encoder6 Encoder7; LineSensorClk; SCL3V3; LineSensorOut1 LineSensorOut2; GPIO1_20 GPIO1_22; PWM0 PWM1 PWM2 PWM3 PWM4 PWM5 PWM6 PWM7; SDA3V3; LineSensorIn1 LineSensorIn2; GPIO1_19 GPIO1_21 GPIO1_23; Power Good; VBatt; Vbus; Low Battery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

Berne University of Applied Science
Quellgasse 21
CH-2500 Biel/Bienne
Switzerland
