freecores/gecko3/GECKO3power/documentation/GECKO3Power_Supply.pdf

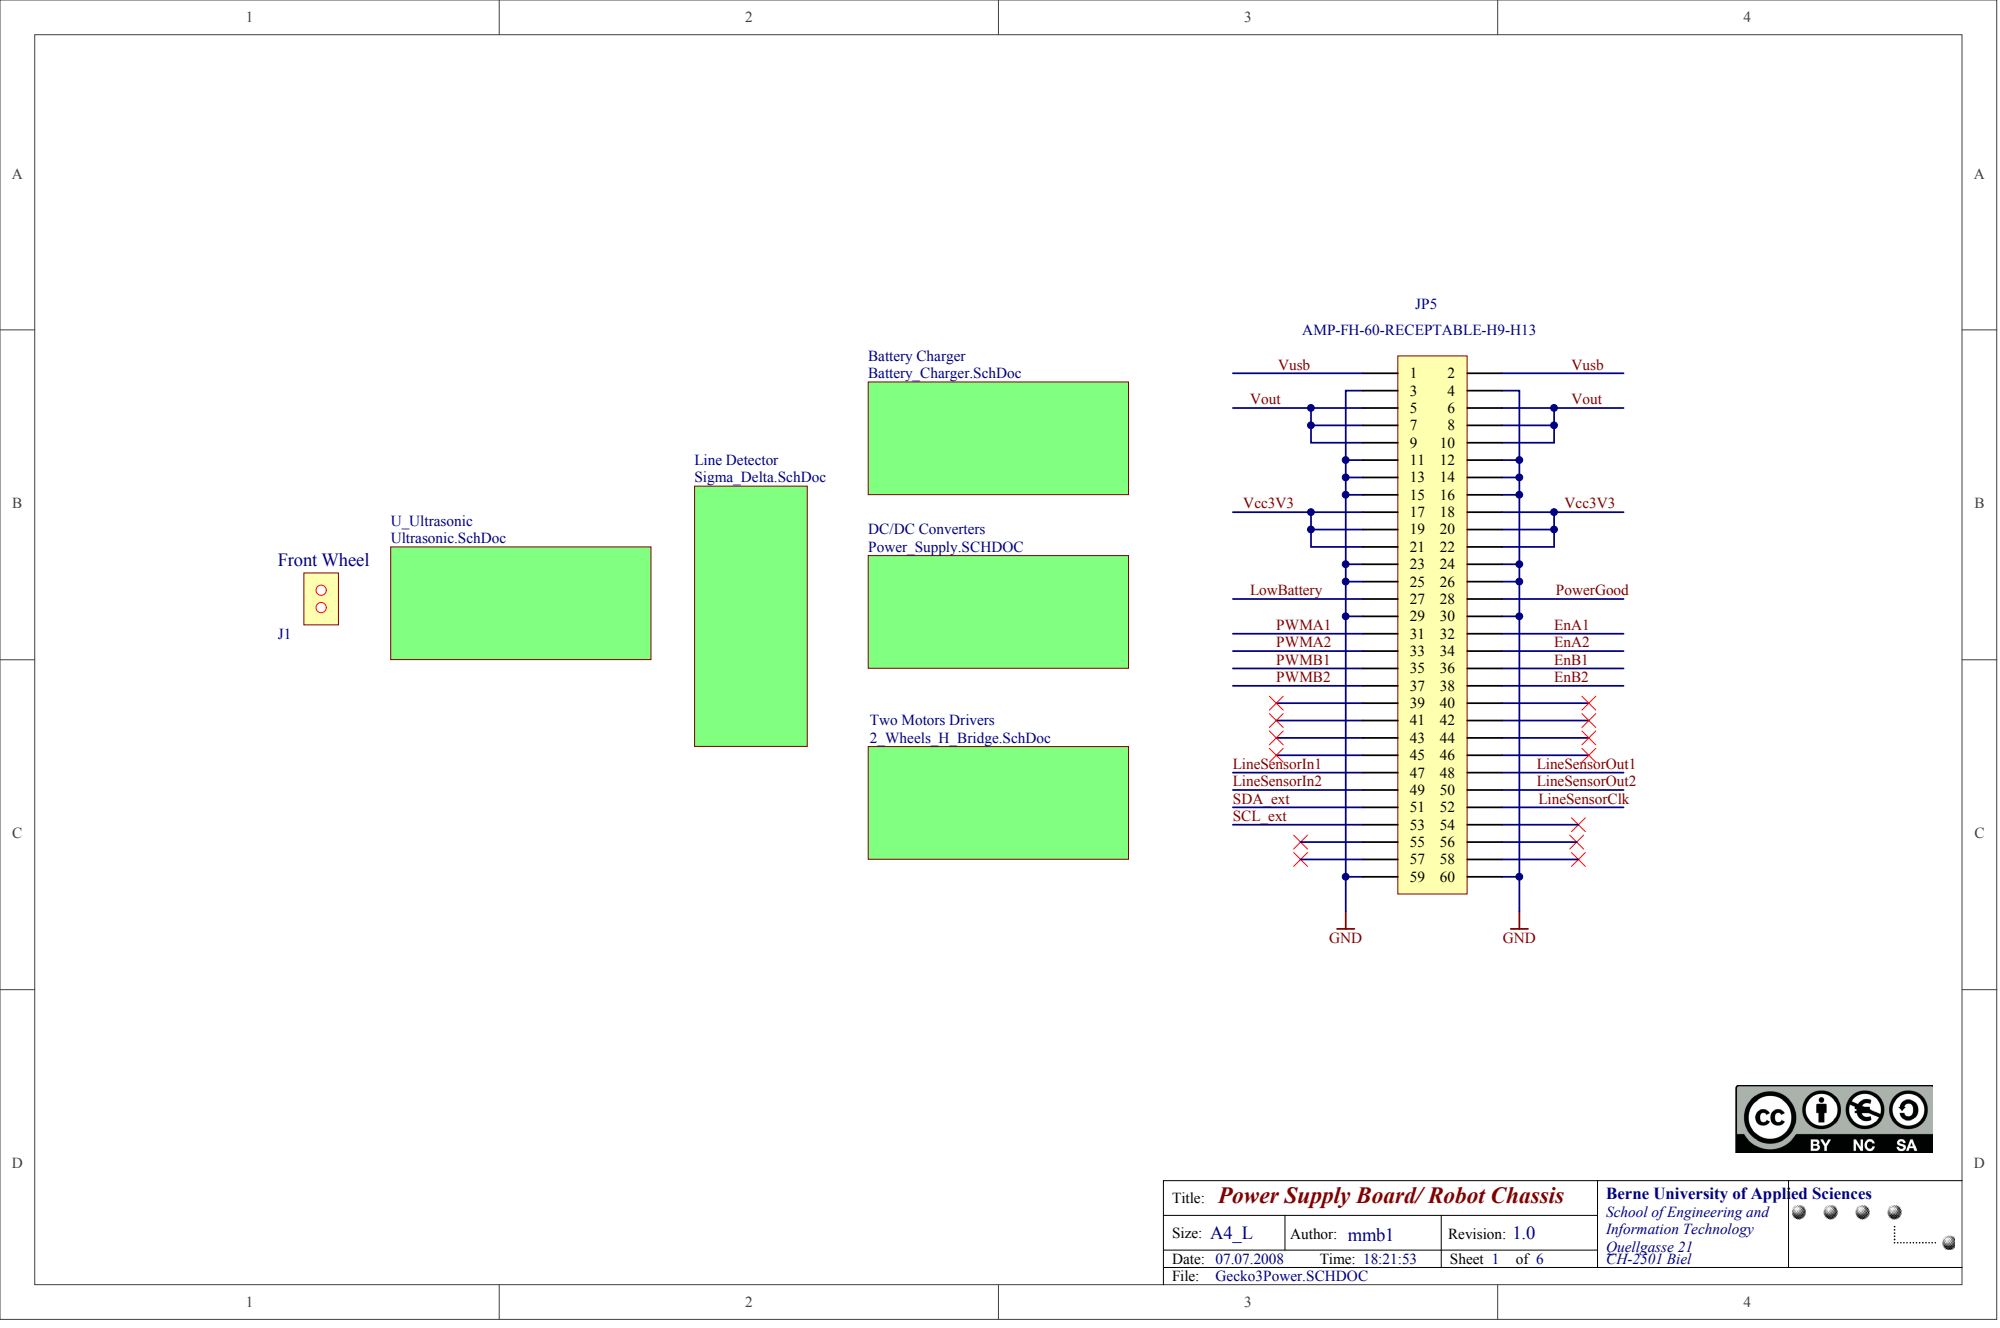
[picture p44: page 1]
Line Detector; Battery Charger; Front Wheel

AMP-FH-60-RECEPTABLE-H9-H13

DC/DC Converters
Power_Supply.SCHDOC

Two Motors Drivers
2_Wheels_H_Bridge.SchDoc

Power Supply Board/ Robot Chassis Title: | Berne University of Applied Sciences School of Engineering and Information Technology CH-2501 Biel

Size: A4_L | Author: mmb1 | Revision: 1.0 | Quellgasse 21 6

Date: 07.07.2008 Time: 18:21:53 | | Sheet 1 of

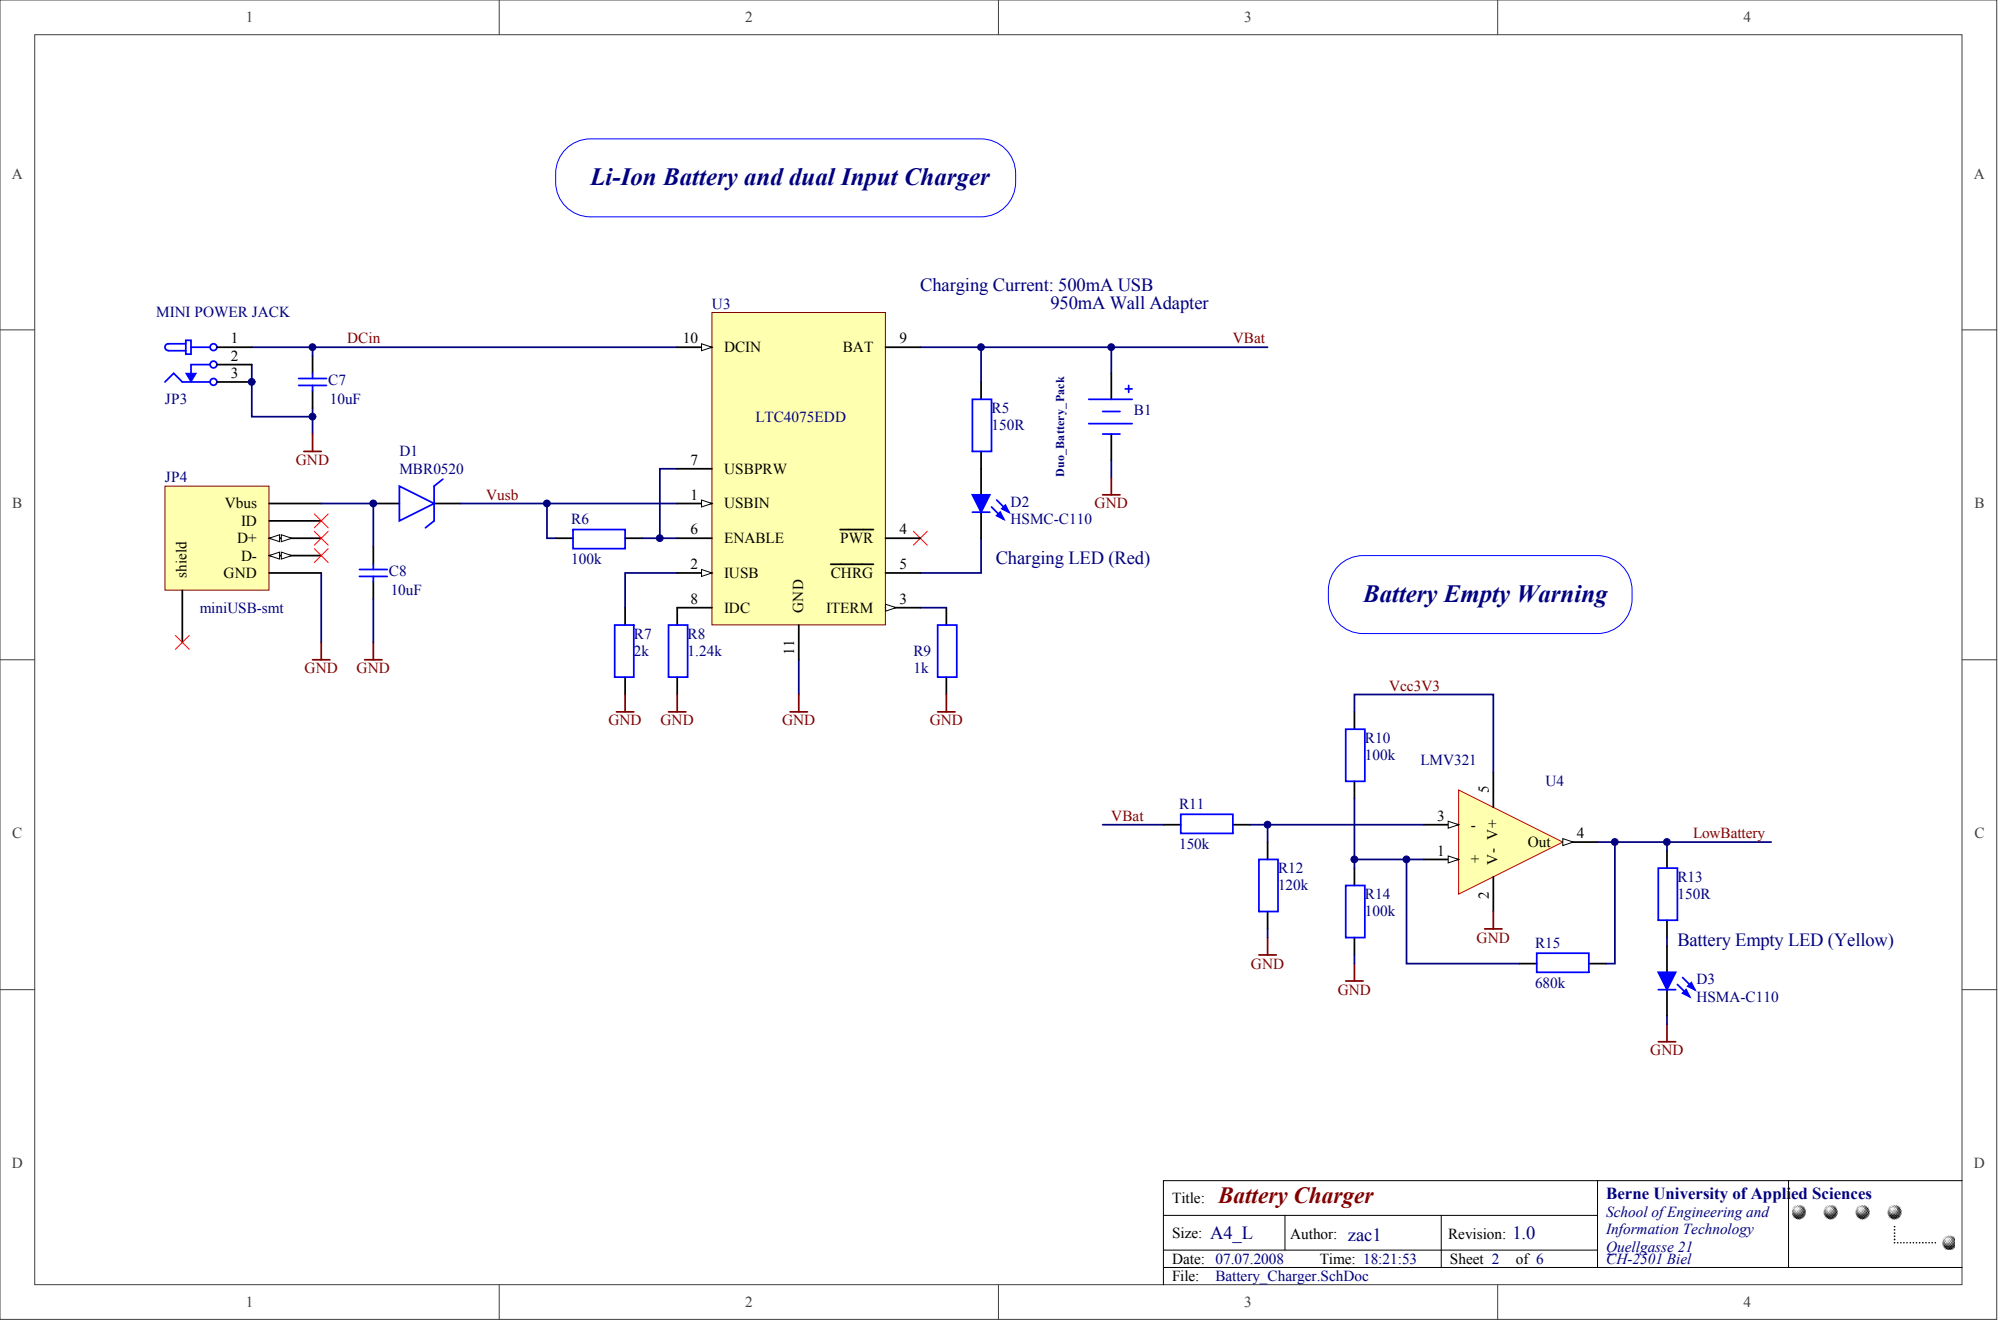
[picture p45: page 2]

Li-Ion Battery and dual Input Charger

Battery Charger Title: | Berne University of Applied Sciences School of Engineering and Information Technology Quellgasse 21 CH-2501 Biel

Size: A4_L | Author: zac1 | Revision: 1.0

Date: File: 07.07.2008 Time: 18:21:53 | | Sheet 2 of 6

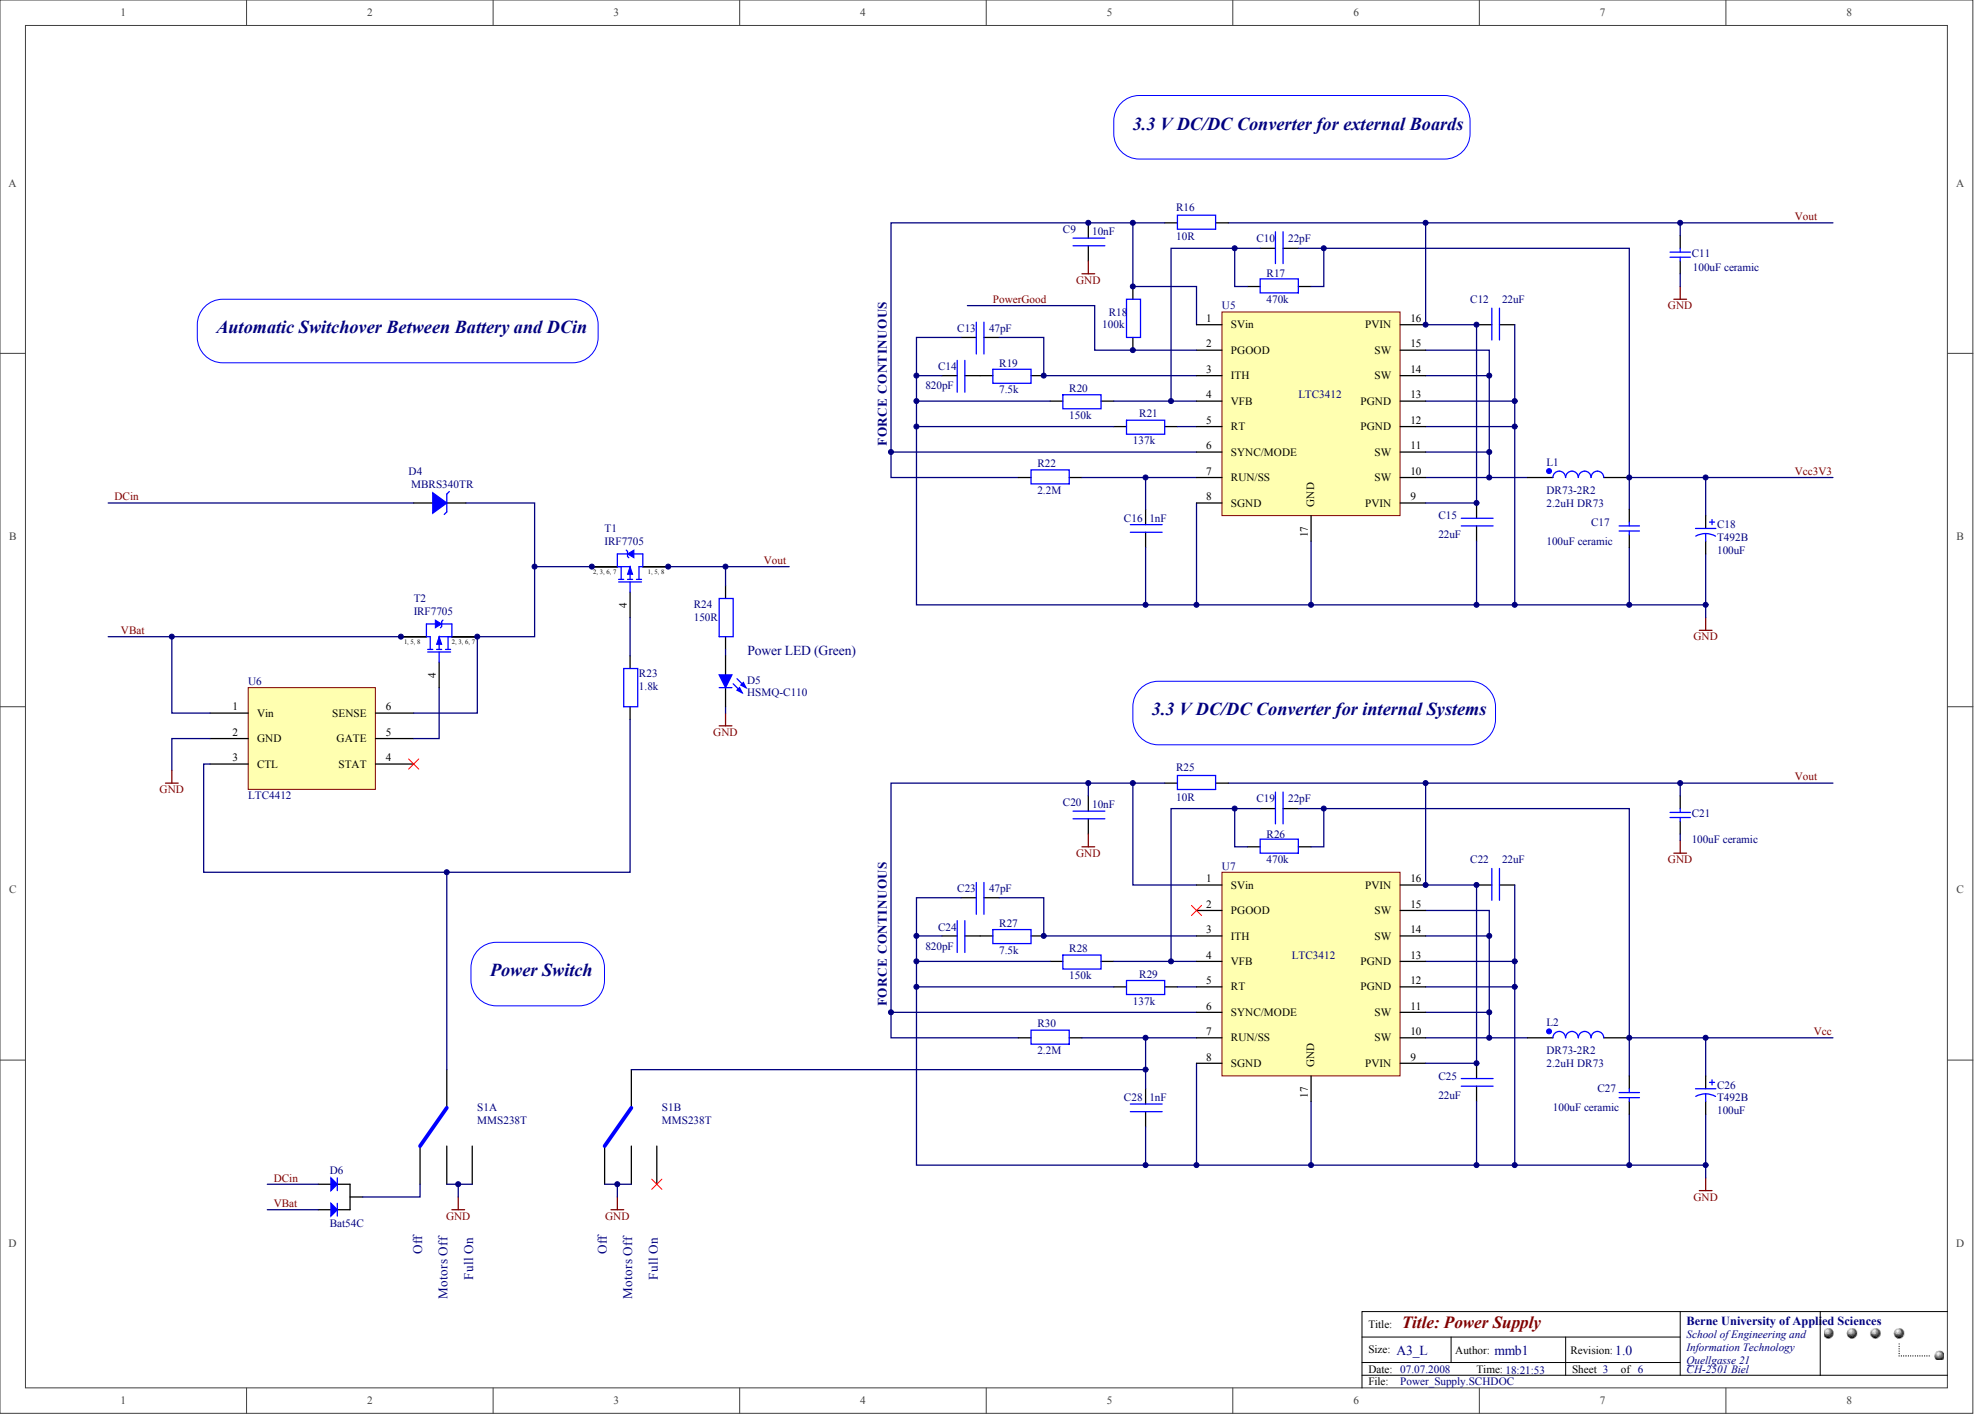
[picture p46: page 3]

3.3 V DC/DC Converter for external Boards

Automatic Switchover Between Battery and DCin

3.3 V DC/DC Converter for internal Systems

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

Size: A3_L | Author: | Revision:

Date: File: 07.07.2008 Time: 18:21:53 Power_Supply.SCHDOC | | Sheet 3 of 6

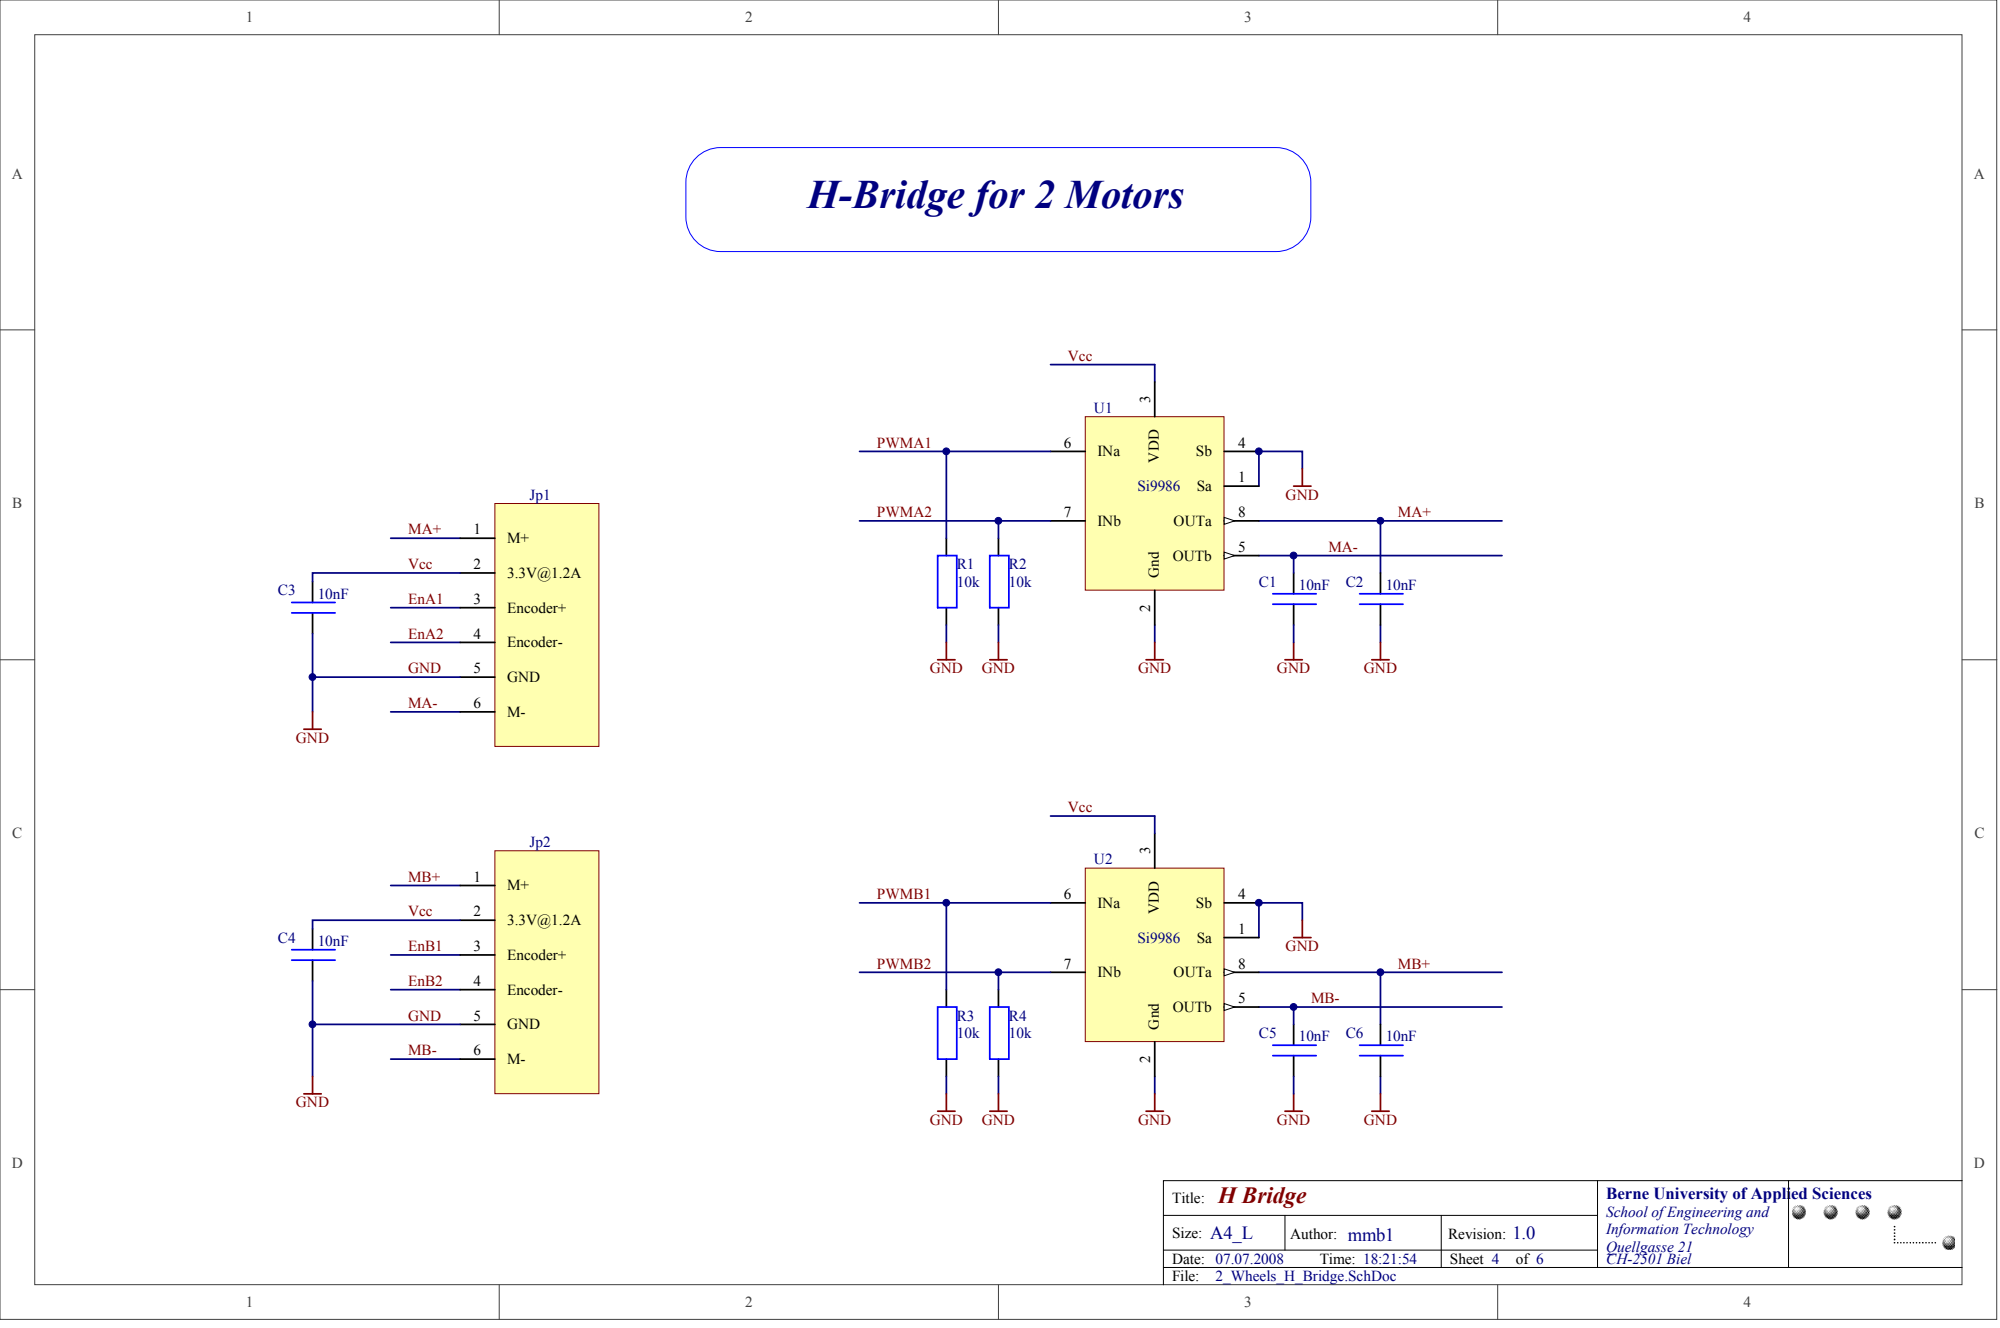
[picture p47: page 4]

H Bridge Title: | Berne University of Applied Sciences School of Engineering and Information Technology Quellgasse 21 CH-2501 Biel

Size: A4_L | Author: mmb1 | Revision: 1.0

Date: File: 07.07.2008 Time: 18:21:54 | | Sheet 4 of 6

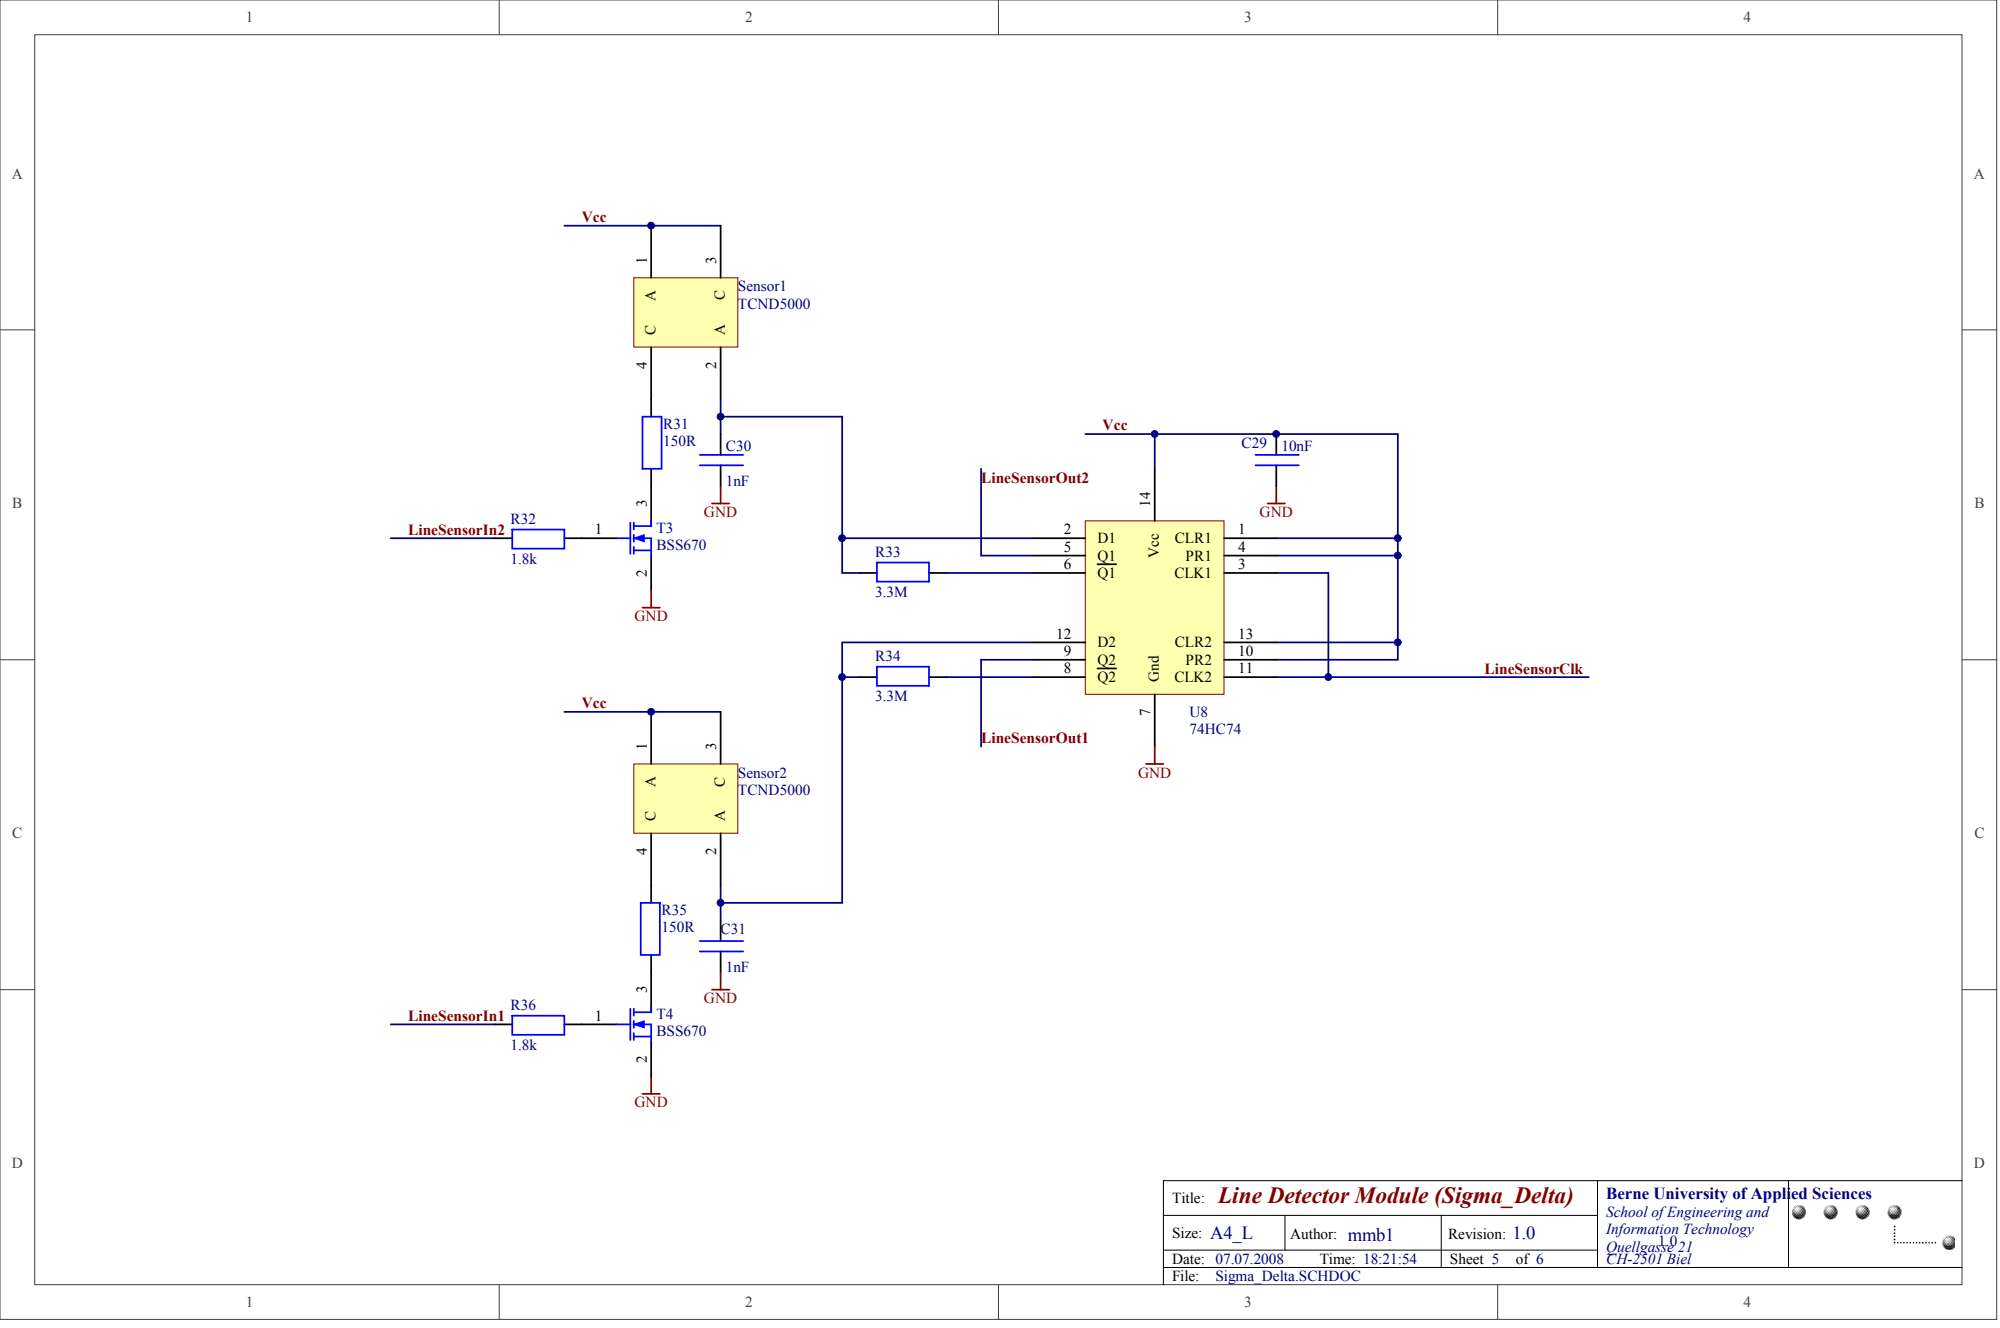
[picture p48: page 5]

Title: | Berne University of Applied Sciences School of Engineering and Information Technology 1.0 Quellgasse 21 CH-2501 Biel

Size: A4_L | Author: | Revision:

Date: File: 07.07.2008 Time: 18:21:54 | | Sheet 5 of 6

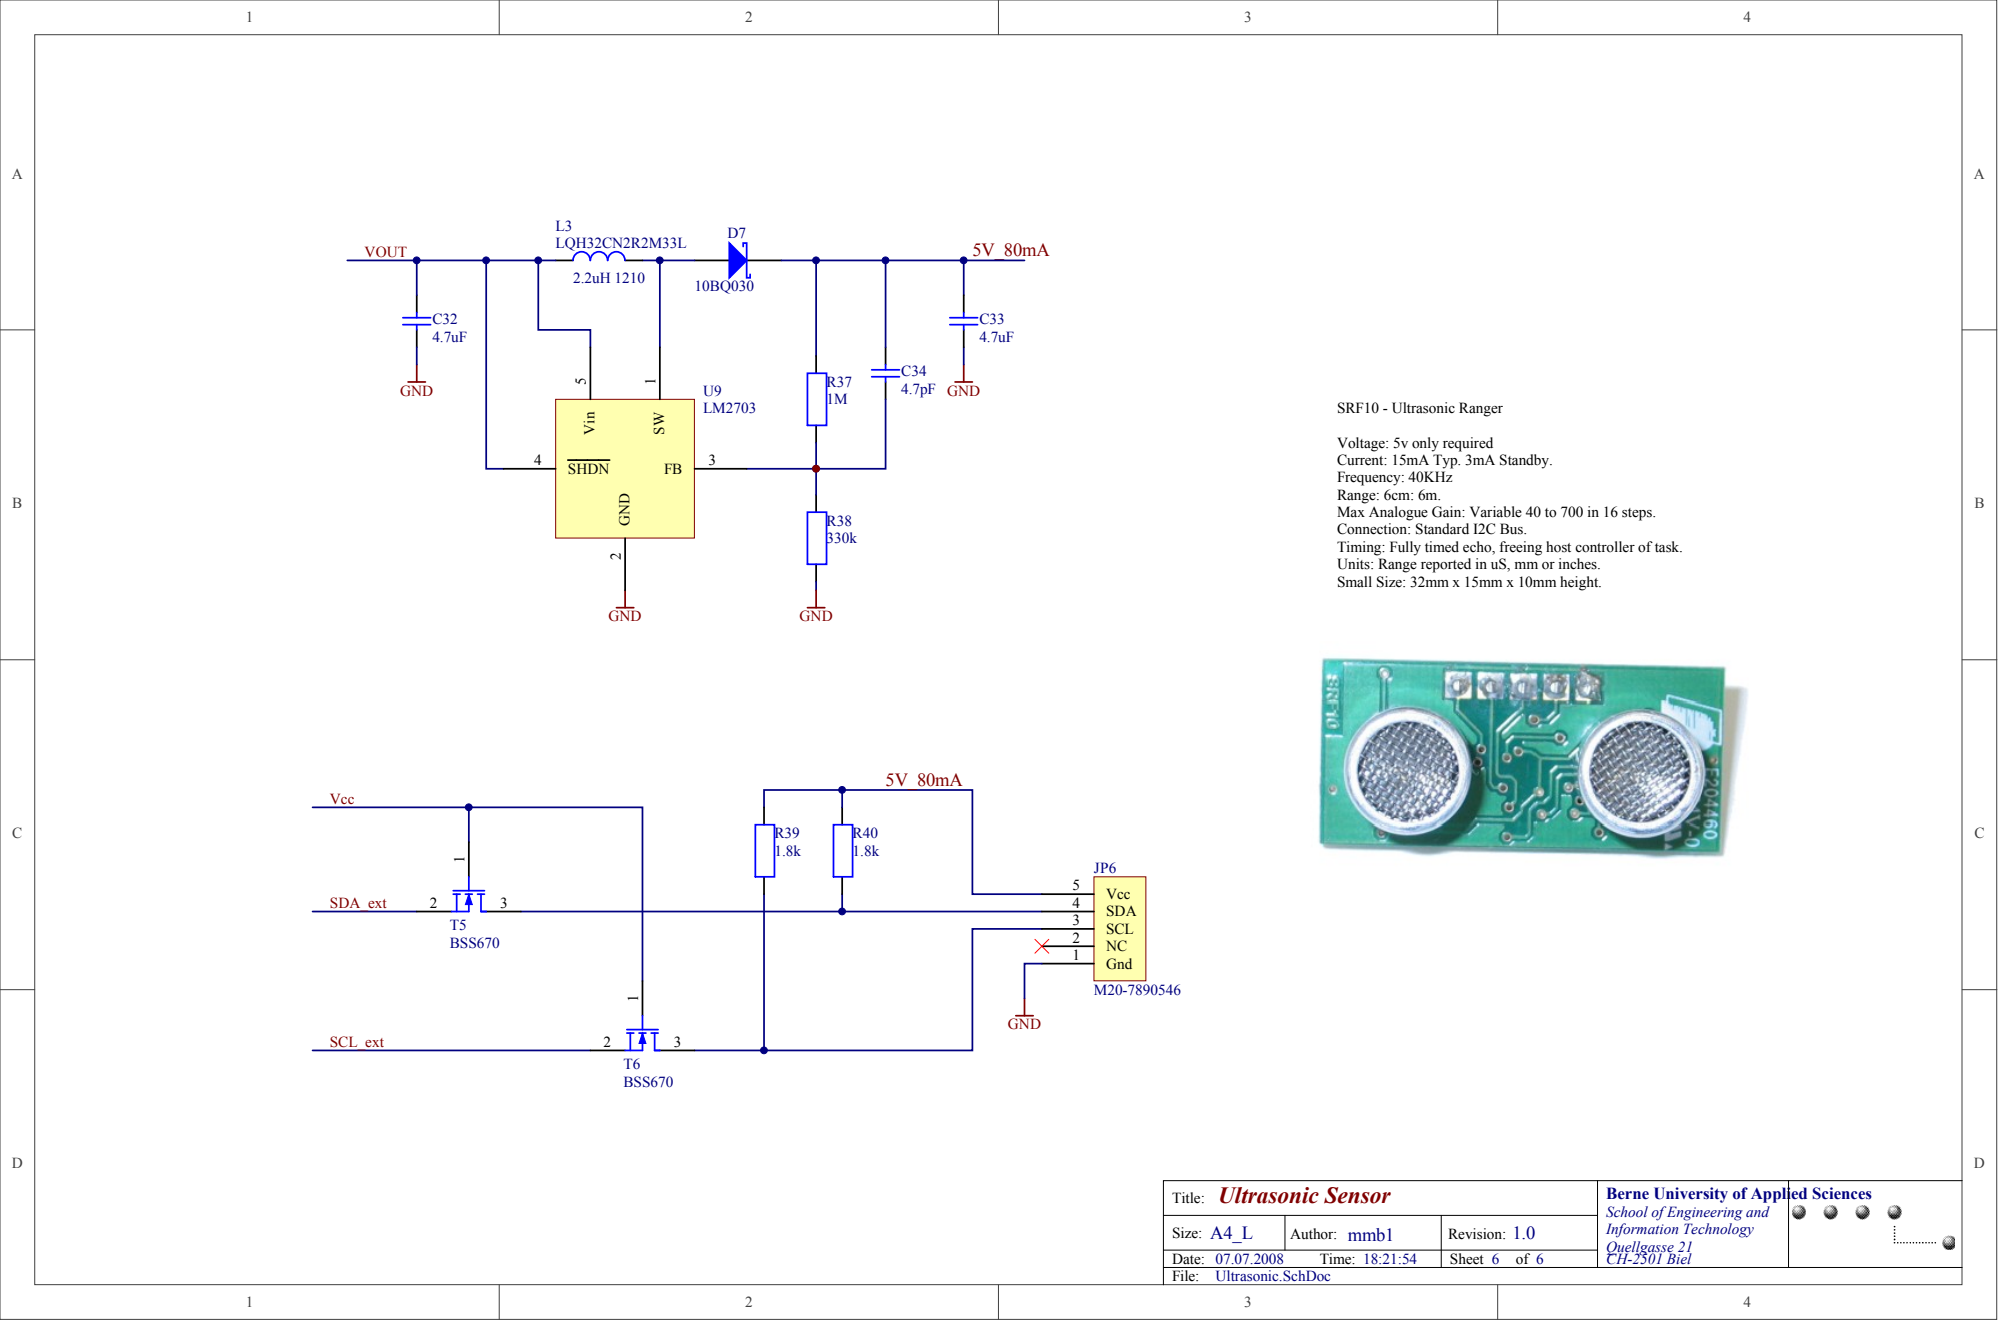
[picture p49: page 6]

Voltage: 5v only required
Current: 15mA Typ. 3mA Standby.
Frequency: 40KHz
Range: 6cm: 6m.
Max Analogue Gain: Variable 40 to 700 in 16 steps.
Connection: Standard I2C Bus.
Timing: Fully timed echo, freeing host controller of task.
Units: Range reported in uS, mm or inches.
Small Size: 32mm x 15mm x 10mm height.

P0JP604 P0JP604 | SDA 4

T5 | | P0JP603 P0JP603 | SCL 3

Ultrasonic Sensor Title: | Berne University of Applied Sciences School of Engineering and Information Technology CH-2501 Biel

Size: A4_L | Author: mmb1 | Revision: 1.0 | Quellgasse 21 6

Date: 07.07.2008 Time: 18:21:54 | | Sheet 6 of

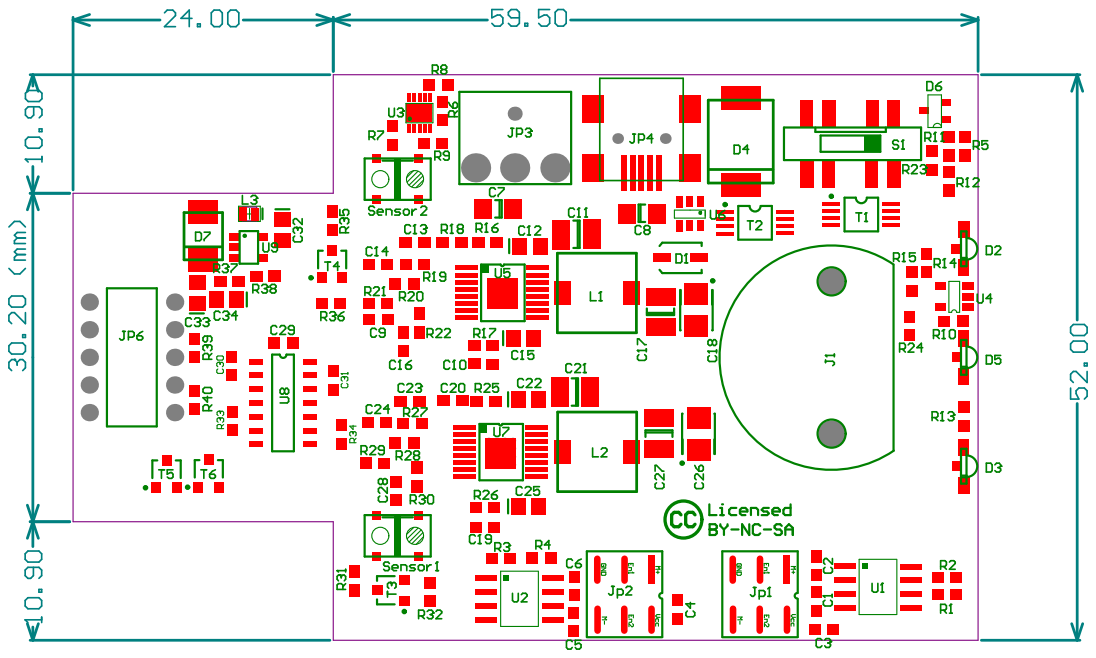
[picture p50: page 7]

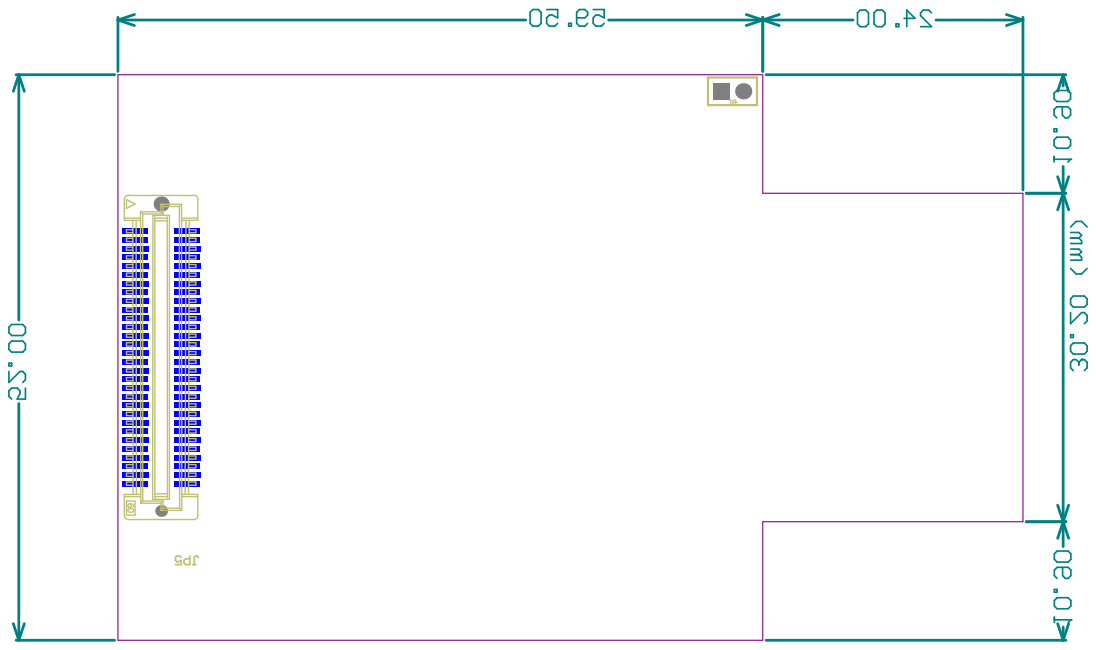
[picture p51: page 8]
