freecores/gecko3/GECKO3main/serial-con.pdf

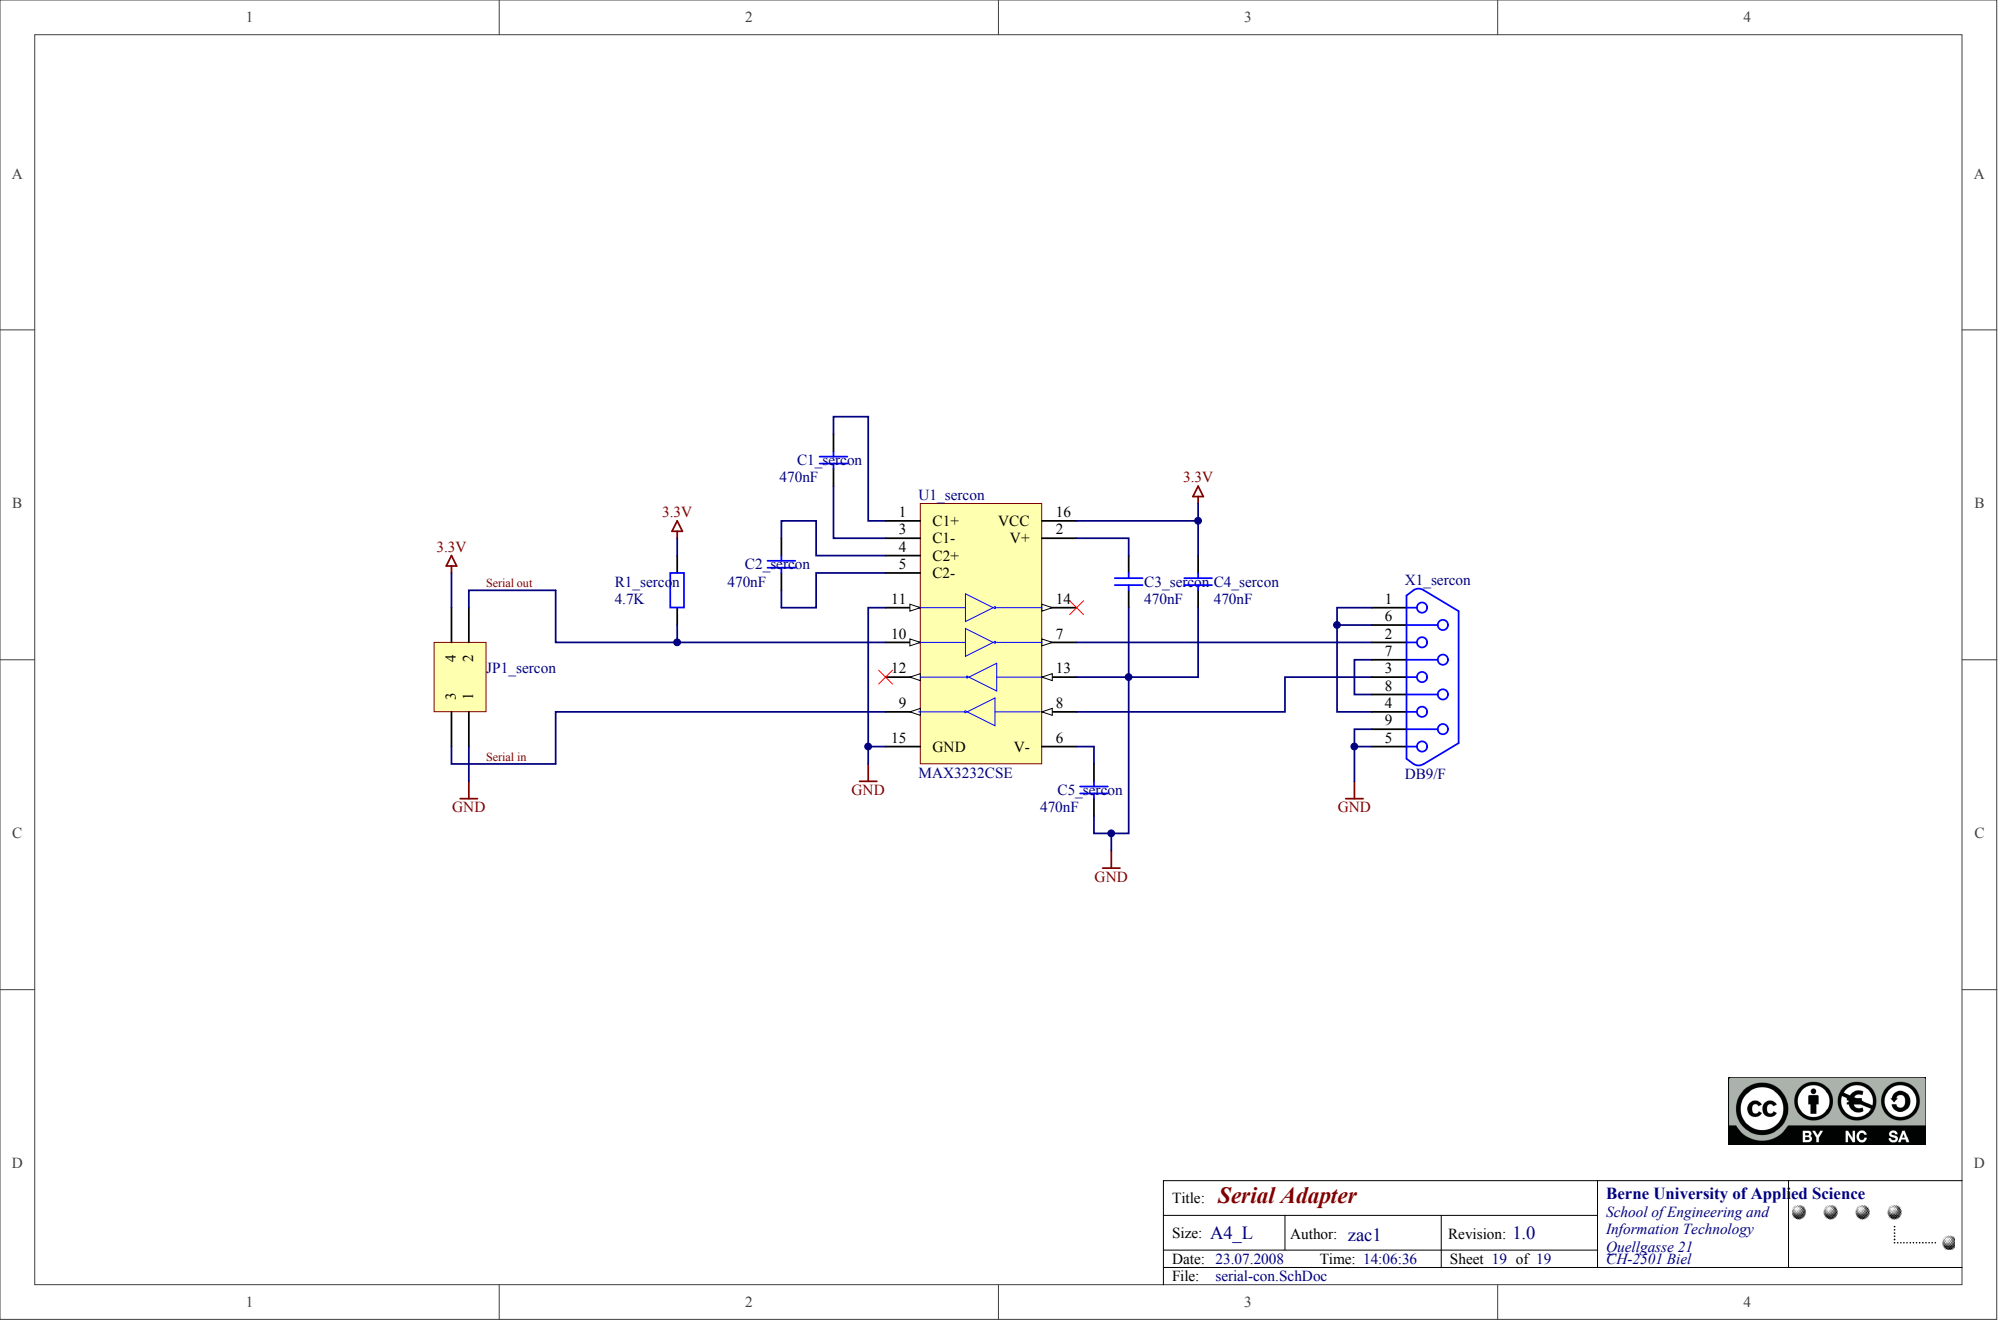
[picture p52: page 1]
GND 15; Serial out; P0C10sercon01 P0C10sercon02; P0C20sercon01 P0C20sercon02; P0C30sercon01 P0C30sercon02; P0C40sercon01 P0C40sercon02; P0C50sercon01 P0C50sercon02; P0JP10sercon01 P0JP10sercon02; P0JP10sercon03 P0JP10sercon04; P0R10sercon01 P0R10sercon02; P0U10sercon02 P0U10sercon03; P0U10sercon08 P0U10sercon09; N0SERIAL OUT

Serial in N0SERIAL IN N0SERIAL IN

Serial Adapter Title: | Berne University of Applied Science School of Engineering and Information Technology CH-2501 Biel

Size: A4_L | Author: zac1 | Revision: 1.0 | Quellgasse 21 19

Date: File: 23.07.2008 Time: 14:06:36 | | Sheet 19 of

serial-con.SchDoc

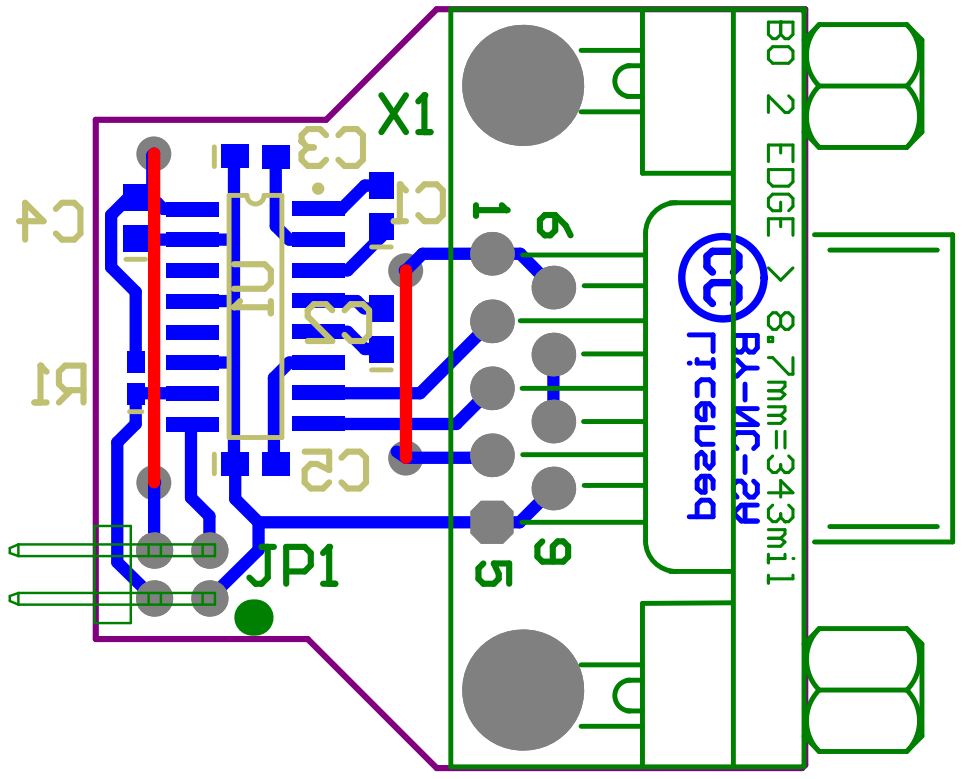
[picture p53: page 2]
