freecores/gecko3/(list of files, drawings)

Other design files:
CAD libraries/gecko3-user/gecko3-library.PcbLib
CAD libraries/gecko3-user/gecko3-user.SchLib
GECKO3basic/CAD files/basic_and_adapter_panel.PcbDoc
GECKO3basic/CAD files/basic_and_adapter_panel_stencil.PcbDoc
GECKO3basic/CAD files/GECKO3basic.PCBDOC
GECKO3basic/CAD files/GECKO3basic.PRJPCB
GECKO3basic/CAD files/Gecko3basic.SchDoc
GECKO3main/cad files/ddr-simulation.SchDoc
GECKO3main/cad files/dram1.SCHDOC
GECKO3main/cad files/dram2.SCHDOC
GECKO3main/cad files/dram.SCHDOC
GECKO3main/cad files/ethernet-con.PcbDoc
GECKO3main/cad files/ethernet-con.PrjPCB
GECKO3main/cad files/ethernet-connector.SchDoc
GECKO3main/cad files/ethernet.SCHDOC
GECKO3main/cad files/flash.SchDoc
GECKO3main/cad files/fpga1.SchDoc
GECKO3main/cad files/fpga2.SCHDOC
GECKO3main/cad files/fpga-config.SCHDOC
GECKO3main/cad files/fpga.SCHDOC
GECKO3main/cad files/gecko3.PcbDoc
GECKO3main/cad files/gecko3.PcbLib
GECKO3main/cad files/GECKO3.PRJPCB
GECKO3main/cad files/gecko3_Panel.pcbdoc
GECKO3main/cad files/gecko3main-tester.PcbDoc
GECKO3main/cad files/gecko3main-tester.SchDoc
GECKO3main/cad files/i2c.SchDoc
GECKO3main/cad files/io-bus2.SchDoc
GECKO3main/cad files/io-bus.SchDoc
GECKO3main/cad files/jtag.SchDoc
GECKO3main/cad files/pds.SchDoc
GECKO3main/cad files/power.SCHDOC
GECKO3main/cad files/serial-con.PcbDoc
GECKO3main/cad files/serial-con.PrjPCB
GECKO3main/cad files/serial-con.SchDoc
GECKO3main/cad files/simulation.PrjPCB
GECKO3main/cad files/spi-flash.SchDoc
GECKO3main/cad files/switches.SchDoc
GECKO3main/cad files/top.SchDoc
GECKO3main/cad files/usb.SCHDOC
GECKO3power/60pin_to_120pin_adapter/60Pin_120Pin.PCBDOC
GECKO3power/60pin_to_120pin_adapter/60Pin_120Pin.SCHDOC
GECKO3power/60pin_to_120pin_adapter/PCB_60PIN_120PIN.PRJPCB
GECKO3power/CAD files/2_Wheels_H_Bridge.SchDoc
GECKO3power/CAD files/Battery_Charger.SchDoc
GECKO3power/CAD files/Gecko3Power.PCBDOC
GECKO3power/CAD files/Gecko3Power.SCHDOC
GECKO3power/CAD files/Gecko3Power_panel.PCBDOC
GECKO3power/CAD files/Gecko3Power_stencil.PCBDOC
GECKO3power/CAD files/Power_Supply.SCHDOC
GECKO3power/CAD files/Project Power_Supply.PRJPCB
GECKO3power/CAD files/Sigma_Delta.SCHDOC
GECKO3power/CAD files/Ultrasonic.SchDoc
templates/gecko3-template.PcbDoc
