freecores/gecko3/(commit log)

2008-11-04 Imported using TkCVS
    [2_Wheels_H_Bridge.SchDoc, 60Pin_120Pin.PCBDOC, 60Pin_120Pin.SCHDOC, Battery_Charger.SchDoc, GECKO3.PRJPCB, GECKO3Power_Supply-BOM.xls, GECKO3basic.PCBDOC, GECKO3basic.PRJPCB]
2009-02-24 small update:
    changed typo in different README and LICENSE files.
    updated the GECKO3main EDK board support package
    fixed the GECKO3main product label. the old one contains the wrong case type
    [serialnumbers.ods]
2009-11-16 First commit to the OC svn.
    This is the release candidate for the GECKO3COM firmware version 0.4.
    Included are all sources, scripts and helper tools.
    Implemented functionality to this firmware version:
    - FW upgrade through USB DFU class
    - works as a USB TMC device (test and measurement class)
    - handles all mandatory IEEE488 and SCPI commands
    - fpga can be configured through USB
    - two different fpga configuration files can be downloaded the the onboard memory
    - loads one of these configuration files during power on
    next step is to implement the transparent data communication between the USB host and the FPGA
2009-11-16 this import did go wrong. look at GECKO3COM/
    [build_eeprom.py, check_mdelay.c, check_udelay.c, debugprint.h, delay.h, eeprom_io.c, eeprom_io.h, firmware_version.h]
2009-12-03 this is the version 0.4 of the GECKO3com IP core.
    This is the last version from Andreas Habegger, the maintainer for this core is now Christoph Zimmermann
    [USB_TMC_IP_timesim.sdf, compxlib.cfg]
2009-12-18 included the gecko3com_0.31.tar.gz firmware package needed to initialize fresh produced boards without any serial number or fpga type information.
    fixed two bugs that were found during testing of the version 0.4-rc
    - the GET_CAPABILITIES function in the usb_tmc module was using a wrong pointer and returned garbage
    - the SLOT_ADRESS defines for the spi write functions were using constants only usable on the GECKO3main prototype
    changed some other small stuff to avoid compiler warnings or clarifie some comments.
    [gecko3com_main.c, gecko3com_spi.h, spi_flash.c, spi_flash.h]
2009-12-18 this is the release of version 0.4rc2
    we provide now the downloadable *.iic file of the current version in the repository at the convinient place
    "gecko3com-fw/firmware/"
2009-12-31 release candidate 3: 0.4rc3
    fixed a bug in the get_capabilities function. was fixed before but it was back again...
    removed one file from the build process, that shouldn't be in the subversion.
    [firmware_version.h]
2010-01-13 killed a bug that caused unreliable out transfers. detection of a ongoing in transfer is malfunctioning. needs redesign.
    [gecko3com_common.c, gecko3com_gpif.c]
2010-01-18 found a pinning error in the series production documentation. fixed in the wiki and the core.
    really stable host to fpga data transfer achieved. several time over 4Gbyte transfered. including switching to fpga to
    host GPIF waveform to listen to possible fpga transfer tries. but fpga to host transfers still not finished.
    the correct length of data is read from the gpif_fsm now. still untested data consitency when data flow throtling occours.
    need bigger buffers to test this. will be done on a higher level.
    [GECKO3main_v1.ucf, gecko3com_gpif.c, gecko3com_gpif.h, gecko3com_main.c, gpif_com.vhd, gpif_com_fsm.vhd, gpif_com_test.vhd]
2010-01-26 basic synchronous IN (fpga to host) transfer works.
    detail changes:
    -the scpi command "fpga:data" checks now, if the fpga is configured before it changes the context to the fpga. if the fpga is
    not configured, it returns an "EXECUTE ERROR".
    in the same way, the main_loop checks if the fpga looses his configuration. it disables the GPIF, switches the context back
    to the fx2 if so. this is mainly to avoid undeterministic behaviour if you reconfigure the fpga via jtag.
    -introduced the new signal "EOM" end of message from the "usb tmc protokoll interpreter" to the gpif_com module
    -changed the GPIF waveform for the FIFO IN transfer to the new scheme.
    -implemented the same waveform into the gpi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
    [gecko3com_gpif.c, gecko3com_main.c, gecko3com_regs.h, gpif_com.vhd, gpif_com_fsm.vhd, gpif_com_test.vhd, message_rom.vhd]
2010-01-27 system is fully working and tested with big files over 4 Gbyte. there were some smaller bugs and glitches which caused sometimes a deadlock. they are fixed now.
    one was because the fx2 reads the done pin sometimes wrong during a long data
    transfer. I don't now if this is because of crosstalk on my prototyping system or fpga internal weakness.
    a simple debouncing (read again after 40 ms) did the trick.
    changed firmware version to 0.5rc0, basically all features targeted for 0.5 are done.
    [firmware_version.h, fpga_load.c, gecko3com_gpif.c, gecko3com_main.c, gpif_com_fsm.vhd]
2010-02-12 GECKO3COM_simple_test designed and written. added needed switches to the ucf files.
    did some cleanup in the GECKO3_simple_*
2010-02-14 first version of the GECKO3COM_simple_test that successfully synthesized. debugging starts now.
    fixed a small bug in the gpif_com_test due to the adding of the gpif_com_eom signal and the eom bit
    flip-flop in the gpif_com module.
    [GECKO3COM_simple.vhd, GECKO3COM_simple_datapath.vhd, GECKO3COM_simple_fsm.vhd, GECKO3COM_simple_test.vhd, coregenerator_fifo_dualclock.v, coregenerator_fifo_dualclock.vhd, coregenerator_fifo_receive.v, coregenerator_fifo_receive.vhd]
2010-02-23 some of the problems are fixed now, some still remain.
    all transfersize counter where wrong. they have to count the correct number of bytes transfered.
    handling of a "short word" added, to be shure that all data (also when it is shorter than a word)
    is transfered.
    corrected some errors with the fifo write enable signals.
    [GECKO3COM_simple_datapath.vhd, GECKO3COM_simple_fsm.vhd, GECKO3COM_simple_test.vhd, gpif_com_fsm.vhd, gpif_com_test.vhd]
2010-02-25 switched to work on the v1 production GECKO3main. the timing is a big issue with the prototype system. the cabeling and the possibly bad influence of the prototype board layout makes it impossible to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
    out transfer is fully working. always in sync with the transfers and reads all
    tmc headers correctly.
    abort handling in the core works as well. there were some fixes needed in the
    firmware, not all IN FIFO buffer where flushed.
    a lot of work was done for the IN transfer (fpga to pc). the in transfer
    handling in GECKO3COM_simple_test.vhd is finished.
    the GECKO3COM_simple_datapath/fsm is finished.
    there is still an issue left but I think the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
    [GECKO3COM_simple_fsm.vhd, GECKO3COM_simple_test.vhd, GECKO3main_prototype.ucf, GECKO3main_v1.ucf, firmware_version.h, gecko3com_gpif.c, gecko3com_main.c]
2010-02-27 some bugfixes and here and there some comment cleaning
    [GECKO3COM_simple_prng_tb.c, GECKO3COM_simple_prng_tb.vhd, GECKO3COM_simple_test.vhd, gecko3com_common.c, gecko3com_gpif.c, gecko3com_gpif.h, gpif_com.vhd, gpif_com_fsm.vhd]
2010-03-08 fixed a lot of warnings when building the doxygen firmware documentation ("make doc")
    [debugprint.h, delay.h, eeprom_io.c, fx2utils.h, gecko3com_commands.h, gecko3com_common.c, gecko3com_common.h, gecko3com_gpif.h]
2010-03-11 fixed in the bit file header analyse function. it was not possible to handle bit files (configure fpga, store into spi flash) when using USB 1.1 conections.
    disabled the debug define in the firmware Makefile
    removed the chipscope file from the GECKO3COM_simple project to get the logic utilisation of our core only.
    [GECKO3COM_simple.vhd, firmware_version.h, fpga_load.c, gecko3com_main.c]
2010-03-25 immediate test version. stand-alone spi flash bug is away. was a bus conflict, because we modifie the spi bus pins at two different code locations.
    just a backup at the moment. needs more testing before a stable release.
    [firmware_version.h, gecko3com_regs.h, spi_flash.c]
2010-04-20 this is the release of the firmware version 1.0
    it is considered as complete, fully functional and as we know bug free.
    changelog since version 0.5:
    - stand-alone mode fully working (writing to the spi flash and fpga configuration during start-up)
    - added some more visual guidiance using the bi-color LED. we flash now the LED for all commands using one or the other memory slot in the spi flash, this is start-up configuration, writing to the spi flash (mem:data) and delete of a fpga configuration (mem:del)
    - old externel usbtmc driver confirmed to be working with linux 2.6.33
    [firmware_version.h, gecko3com_main.c, spi_flash.c]
